dhskinner/Scoreboard/Design/Firmware/Scoreboard_Firmware/ScoreboardControllerWifi/data/mstile-150x150.png

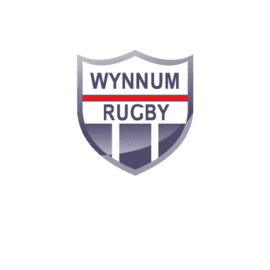
Design/Firmware/Scoreboard_Firmware/ScoreboardControllerWifi/data/mstile-150x150.png
