dhskinner/Scoreboard/Design/Solidworks Controller ULCD/sma-angled.jpg

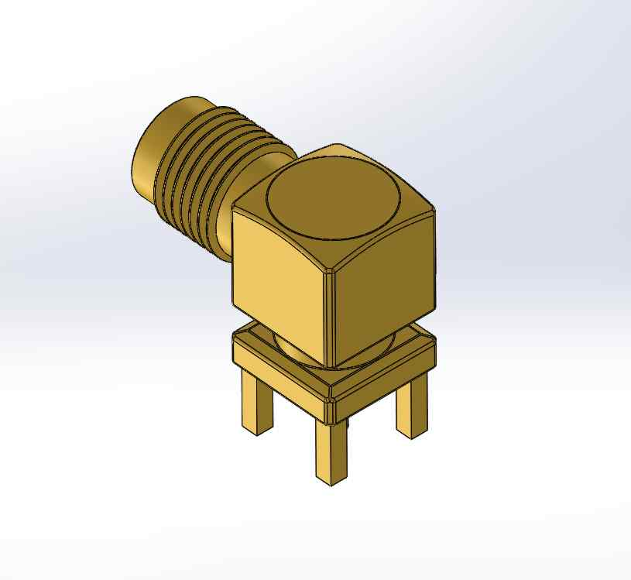
Design/Solidworks Controller ULCD/sma-angled.jpg
