dhskinner/Scoreboard/Sponsors/2023_Season/Property-Centre-stacked-blue.webp

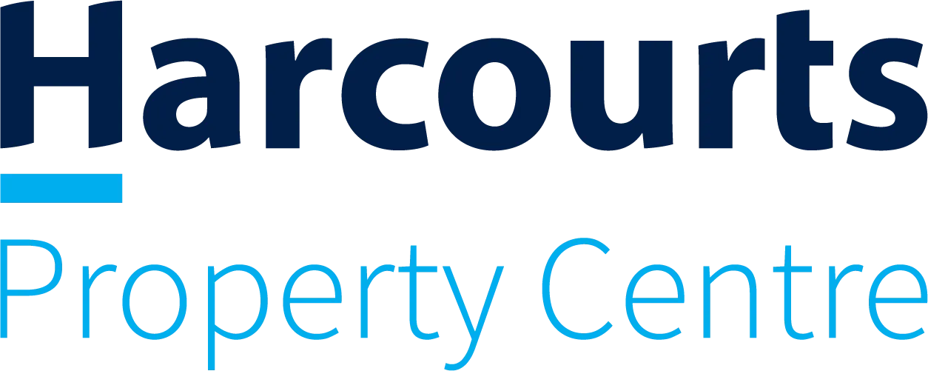
Sponsors/2023_Season/Property-Centre-stacked-blue.webp
