dhskinner/Scoreboard/Sponsors/2023_Season/The-Small-Business-Lawyer-1-1280x695.png

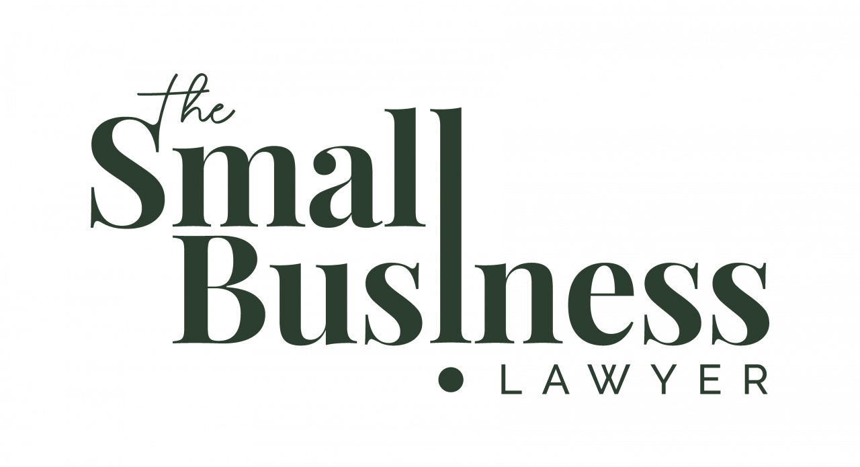
Sponsors/2023_Season/The-Small-Business-Lawyer-1-1280x695.png
