dhskinner/Scoreboard/Sponsors/2023_Season/YPM_Group_FullColour_DeepGreen-1280x766.png

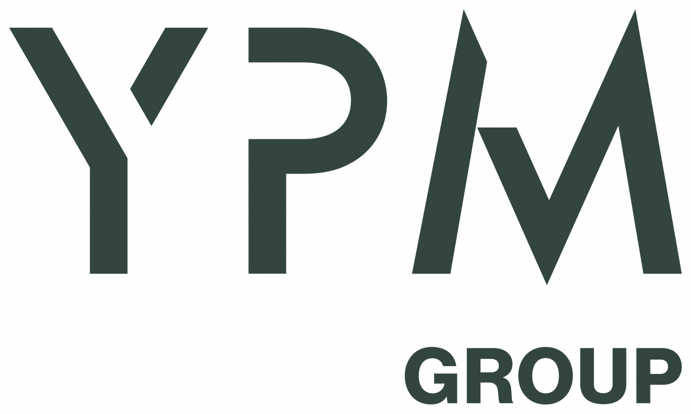
Sponsors/2023_Season/YPM_Group_FullColour_DeepGreen-1280x766.png
