dhskinner/Scoreboard/Design/ScoreBoard Arduino Code.xlsx

Sheet: Brightness
Brightness
// Scale from 0 = zero brightness to six = 255
// This is a whole bunch of magic numbers TODO
switch (_dmdBrightness)
{
 | case FLAG_BRIGHTNESS_0: |  | 0
 |  | _dmd.setBrightness ( 20 ); | 20
 |  | break;
 | case FLAG_BRIGHTNESS_1: |  | 1
 |  | _dmd.setBrightness ( 40 ); | 40
 |  | break;
 | case FLAG_BRIGHTNESS_2: |  | 2
 |  | _dmd.setBrightness ( 80 ); | 80
 |  | break;
 | case FLAG_BRIGHTNESS_3: |  | 3
 |  | _dmd.setBrightness ( 120 ); | 120
 |  | break;
 | case FLAG_BRIGHTNESS_4: |  | 4
 |  | _dmd.setBrightness ( 160 ); | 160
 |  | break;
 | case FLAG_BRIGHTNESS_5: |  | 5
 |  | _dmd.setBrightness ( 200 ); | 200
 |  | break;
 | default: |  | 6
 |  | _dmd.setBrightness ( 255 ); | 255
 |  | break;
}

Sheet: Font 48x24 New
 | 4 | 5 | 6 | 7 | 8 | 9 | 10 | 11 | 12 | 13 | 14 | 15 | 16 | 17 | 18 | 19 | 20 | 21 | 22 | 23 | 24 | 25 | 26 | 27 | 0 | // 0
0 | 0 | 0 | 0 | 0 | 0 | 0 | 0 | 0 | 1 | 1 | 1 | 1 | 1 | 1 | 1 | 1 | 0 | 0 | 0 | 0 | 0 | 0 | 0 | 0 | 0 | 0x00, | 0xC0, | 0xF0, | 0xF8, | 0xFC, | 0xFC, | 0xFE, | 0x7E, | 0x3F, | 0x3F, | 0x3F, | 0x3F, | 0x3F, | 0x3F, | 0x3F, | 0x3F, | 0x7E, | 0xFE, | 0xFC, | 0xFC, | 0xF8, | 0xF0, | 0xC0, | 0x00, | // 0 | 2
1 | 0 | 0 | 0 | 0 | 0 | 0 | 1 | 1 | 1 | 1 | 1 | 1 | 1 | 1 | 1 | 1 | 1 | 1 | 0 | 0 | 0 | 0 | 0 | 0 | 1
2 | 0 | 0 | 0 | 0 | 1 | 1 | 1 | 1 | 1 | 1 | 1 | 1 | 1 | 1 | 1 | 1 | 1 | 1 | 1 | 1 | 0 | 0 | 0 | 0 | 2
3 | 0 | 0 | 0 | 1 | 1 | 1 | 1 | 1 | 1 | 1 | 1 | 1 | 1 | 1 | 1 | 1 | 1 | 1 | 1 | 1 | 1 | 0 | 0 | 0 | 3
4 | 0 | 0 | 1 | 1 | 1 | 1 | 1 | 1 | 1 | 1 | 1 | 1 | 1 | 1 | 1 | 1 | 1 | 1 | 1 | 1 | 1 | 1 | 0 | 0 | 4
5 | 0 | 0 | 1 | 1 | 1 | 1 | 1 | 1 | 1 | 1 | 1 | 1 | 1 | 1 | 1 | 1 | 1 | 1 | 1 | 1 | 1 | 1 | 0 | 0 | 5
6 | 0 | 1 | 1 | 1 | 1 | 1 | 1 | 1 | 0 | 0 | 0 | 0 | 0 | 0 | 0 | 0 | 1 | 1 | 1 | 1 | 1 | 1 | 1 | 0 | 6
7 | 0 | 1 | 1 | 1 | 1 | 1 | 1 | 0 | 0 | 0 | 0 | 0 | 0 | 0 | 0 | 0 | 0 | 1 | 1 | 1 | 1 | 1 | 1 | 0 | 7
8 | 1 | 1 | 1 | 1 | 1 | 1 | 0 | 0 | 0 | 0 | 0 | 0 | 0 | 0 | 0 | 0 | 0 | 0 | 1 | 1 | 1 | 1 | 1 | 1 | 8 | 0xFF, | 0xFF, | 0xFF, | 0xFF, | 0xFF, | 0xFF, | 0x00, | 0x00, | 0x00, | 0x00, | 0x00, | 0x00, | 0x00, | 0x00, | 0x00, | 0x00, | 0x00, | 0x00, | 0xFF, | 0xFF, | 0xFF, | 0xFF, | 0xFF, | 0xFF, | // 0 | 10
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
47 | 0 | 0 | 0 | 0 | 0 | 0 | 0 | 0 | 0 | 0 | 0 | 0 | 0 | 0 | 0 | 0 | 0 | 0 | 0 | 0 | 0 | 0 | 0 | 0 | 47
 | 4 | 5 | 6 | 7 | 8 | 9 | 10 | 11 | 12 | 13 | 14 | 15 | 16 | 17 | 18 | 19 | 20 | 21 | 22 | 23 | 24 | 25 | 26 | 27 | 10

Sheet: Font 44x28 New
 | 0 | 1 | 2 | 3 | 4 | 5 | 6 | 7 | 8 | 9 | 10 | 11 | 12 | 13 | 14 | 15 | 16 | 17 | 18 | 19 | 20 | 21 | 22 | 23 | 24 | 25 | 26 | 27 | 0 | 0 | 1 | 2 | 3 | 4 | 5 | 6 | 7 | 8 | 9 | 10 | 11 | 12 | 13 | 14 | 15 | 16 | 17 | 18 | 19 | 20 | 21 | 22 | 23 | 24 | 25 | 26 | 27
0 | 0 | 0 | 0 | 0 | 0 | 0 | 0 | 0 | 1 | 1 | 1 | 1 | 1 | 1 | 1 | 1 | 1 | 1 | 1 | 1 | 0 | 0 | 0 | 0 | 0 | 0 | 0 | 0 | 0 | 0x00, | 0xC0, | 0xF0, | 0xF8, | 0xFC, | 0xFC, | 0xFE, | 0x7E, | 0x3F, | 0x3F, | 0x3F, | 0x3F, | 0x3F, | 0x3F, | 0x3F, | 0x3F, | 0x3F, | 0x3F, | 0x3F, | 0x3F, | 0x7E, | 0xFE, | 0xFC, | 0xFC, | 0xF8, | 0xF0, | 0xC0, | 0x00, | // 0
1 | 0 | 0 | 0 | 0 | 0 | 0 | 1 | 1 | 1 | 1 | 1 | 1 | 1 | 1 | 1 | 1 | 1 | 1 | 1 | 1 | 1 | 1 | 0 | 0 | 0 | 0 | 0 | 0 | 1
2 | 0 | 0 | 0 | 0 | 1 | 1 | 1 | 1 | 1 | 1 | 1 | 1 | 1 | 1 | 1 | 1 | 1 | 1 | 1 | 1 | 1 | 1 | 1 | 1 | 0 | 0 | 0 | 0 | 2
3 | 0 | 0 | 0 | 1 | 1 | 1 | 1 | 1 | 1 | 1 | 1 | 1 | 1 | 1 | 1 | 1 | 1 | 1 | 1 | 1 | 1 | 1 | 1 | 1 | 1 | 0 | 0 | 0 | 3
4 | 0 | 0 | 1 | 1 | 1 | 1 | 1 | 1 | 1 | 1 | 1 | 1 | 1 | 1 | 1 | 1 | 1 | 1 | 1 | 1 | 1 | 1 | 1 | 1 | 1 | 1 | 0 | 0 | 4
5 | 0 | 0 | 1 | 1 | 1 | 1 | 1 | 1 | 1 | 1 | 1 | 1 | 1 | 1 | 1 | 1 | 1 | 1 | 1 | 1 | 1 | 1 | 1 | 1 | 1 | 1 | 0 | 0 | 5
6 | 0 | 1 | 1 | 1 | 1 | 1 | 1 | 1 | 0 | 0 | 0 | 0 | 0 | 0 | 0 | 0 | 0 | 0 | 0 | 0 | 1 | 1 | 1 | 1 | 1 | 1 | 1 | 0 | 6
7 | 0 | 1 | 1 | 1 | 1 | 1 | 1 | 0 | 0 | 0 | 0 | 0 | 0 | 0 | 0 | 0 | 0 | 0 | 0 | 0 | 0 | 1 | 1 | 1 | 1 | 1 | 1 | 0 | 7
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
4 | 1 | 1 | 1 | 1 | 1 | 1 | 1 | 1 | 1 | 1 | 1 | 1 | 1 | 1 | 1 | 1 | 1 | 1 | 1 | 1 | 1 | 1 | 1 | 1 | 1 | 1 | 0 | 0 | 2
5 | 1 | 1 | 1 | 1 | 1 | 1 | 1 | 1 | 1 | 1 | 1 | 1 | 1 | 1 | 1 | 1 | 1 | 1 | 1 | 1 | 1 | 1 | 1 | 1 | 1 | 1 | 0 | 0 | 3

Sheet: Spacing
320 x 480
3 x BUTTONS

Sheet: Defines III
 |  |  | TYPE | ID | INDEX | NAME | DEFINE OBJECT PLUS INDEX | INPUT NUMBERS | BUTTON_NAMES
 |  |  |  |  |  | // FORMS | // FORMS
 |  |  | FORM | 10 | 0 | MAIN_FORM | #define ULCD_MAIN_FORM 10,0
 |  |  | FORM | 10 | 1 | FIELD1_SCORE0_FORM | #define ULCD_FIELD1_SCORE0_FORM 10,1
 |  |  | FORM | 10 | 2 | FIELD1_TIMER_FORM | #define ULCD_FIELD1_TIMER_FORM 10,2
 |  |  | FORM | 10 | 3 | FIELD2_SCORE0_FORM | #define ULCD_FIELD2_SCORE0_FORM 10,3
 |  |  | FORM | 10 | 4 | SPLASH_FORM | #define ULCD_SPLASH_FORM 10,4
 |  |  | FORM | 10 | 5 | FIELD1_FORM | #define ULCD_FIELD1_FORM 10,5
 |  |  | FORM | 10 | 6 | FIELD2_FORM | #define ULCD_FIELD2_FORM 10,6
 |  |  | FORM | 10 | 7 | MESSAGE_FORM | #define ULCD_MESSAGE_FORM 10,7
 |  |  | FORM | 10 | 8 | DIALOG_FORM | #define ULCD_DIALOG_FORM 10,8
 |  |  | FORM | 10 | 9 | TEXT_SET_FORM | #define ULCD_TEXT_SET_FORM 10,9
 |  |  | FORM | 10 | 10 | FIELD2_TIMER_FORM | #define ULCD_FIELD2_TIMER_FORM 10,10
 |  |  | FORM | 10 | 11 | TEXT_FORM | #define ULCD_TEXT_FORM 10,11
 |  |  | FORM | 10 | 12 | WORKING_FORM | #define ULCD_WORKING_FORM 10,12
4DBUTTON | GENIE_OBJ_4DBUTTON | 30 | FORM | 10 | 13 | FIELD1_SCORE1_FORM | #define ULCD_FIELD1_SCORE1_FORM 10,13
ANGULAR_METER | GENIE_OBJ_ANGULAR_METER | 7 | FORM | 10 | 14 | FIELD2_SCORE1_FORM | #define ULCD_FIELD2_SCORE1_FORM 10,14
ANIBUTTON | GENIE_OBJ_ANIBUTTON | 31 | FORM | 10 | 15 | BLANK_FORM | #define ULCD_BLANK_FORM 10,15
COLORPICKER | GENIE_OBJ_COLORPICKER | 32 |  |  |  | // MAIN FORM | // MAIN FORM
COOL_GAUGE | GENIE_OBJ_COOL_GAUGE | 8 | 4DBUTTON | 30 | 0 | MAIN_DUALSCREEN_4DBTN | #define ULCD_MAIN_DUALSCREEN_4DBTN 30,0 | #define INPUT_MAIN_DUALSCREEN_4DBTN 0 | case INPUT_MAIN_DUALSCREEN_4DBTN: break;
CUSTOM_DIGITS | GENIE_OBJ_CUSTOM_DIGITS | 9 | 4DBUTTON | 30 | 1 | MAIN_SWAPFIELD_4DBTN | #define ULCD_MAIN_SWAPFIELD_4DBTN 30,1 | #define INPUT_MAIN_SWAPFIELD_4DBTN 1 | case INPUT_MAIN_SWAPFIELD_4DBTN: break;
DIPSW | GENIE_OBJ_DIPSW | 0 | TRACKBAR | 5 | 0 | MAIN_BRIGHTNESS_BAR | #define ULCD_MAIN_BRIGHTNESS_BAR 5,0 | #define INPUT_MAIN_BRIGHTNESS_BAR 0 | case INPUT_MAIN_BRIGHTNESS_BAR: break;
FORM | GENIE_OBJ_FORM | 10 | USERBUTTON | 33 | 3 | MAIN_FIELD1_BTN | #define ULCD_MAIN_FIELD1_BTN 33,3 | #define INPUT_MAIN_FIELD1_BTN 3 | case INPUT_MAIN_FIELD1_BTN: break;
GAUGE | GENIE_OBJ_GAUGE | 11 | USERBUTTON | 33 | 5 | MAIN_FIELD2_BTN | #define ULCD_MAIN_FIELD2_BTN 33,5 | #define INPUT_MAIN_FIELD2_BTN 5 | case INPUT_MAIN_FIELD2_BTN: break;
IMAGE | GENIE_OBJ_IMAGE | 12 | USERBUTTON | 33 | 4 | MAIN_TEXT_BTN | #define ULCD_MAIN_TEXT_BTN 33,4 | #define INPUT_MAIN_TEXT_BTN 4 | case INPUT_MAIN_TEXT_BTN: break;
KEYBOARD | GENIE_OBJ_KEYBOARD | 13 | GAUGE | 11 | 4 | MAIN_BATTERY | #define ULCD_MAIN_BATTERY 11,4
KNOB | GENIE_OBJ_KNOB | 1 | USERIMAGES | 27 | 0 | MAIN_SIGNAL | #define ULCD_MAIN_SIGNAL 27,0
LED | GENIE_OBJ_LED | 14 | TIMER | 23 | 0 | MAIN_TIMER | #define ULCD_MAIN_TIMER 23,0
LED_DIGITS | GENIE_OBJ_LED_DIGITS | 15 | STRINGS | 17 | 15 | MAIN_ONLINE_STRING | #define ULCD_MAIN_ONLINE_STRING 17,15
METER | GENIE_OBJ_METER | 16 |  |  |  | // FIELD1 - SCORE0 | // FIELD1 - SCORE0
PININPUT | GENIE_OBJ_PININPUT | 29 | LED_DIGITS | 15 | 3 | FIELD1_SCORE0_SET_LED | #define ULCD_FIELD1_SCORE0_SET_LED 15,3
PINOUTPUT | GENIE_OBJ_PINOUTPUT | 28 | USERBUTTON | 33 | 22 | FIELD1_SCORE0_MINUS1_BTN | #define ULCD_FIELD1_SCORE0_MINUS1_BTN 33,22 | #define INPUT_FIELD1_SCORE0_MINUS1_BTN 22 | case INPUT_FIELD1_SCORE0_MINUS1_BTN: break;
ROCKERSW | GENIE_OBJ_ROCKERSW | 2 | USERBUTTON | 33 | 21 | FIELD1_SCORE0_MINUS5_BTN | #define ULCD_FIELD1_SCORE0_MINUS5_BTN 33,21 | #define INPUT_FIELD1_SCORE0_MINUS5_BTN 21 | case INPUT_FIELD1_SCORE0_MINUS5_BTN: break;
ROTARYSW | GENIE_OBJ_ROTARYSW | 3 | USERBUTTON | 33 | 24 | FIELD1_SCORE0_PLUS5_BTN | #define ULCD_FIELD1_SCORE0_PLUS5_BTN 33,24 | #define INPUT_FIELD1_SCORE0_PLUS5_BTN 24 | case INPUT_FIELD1_SCORE0_PLUS5_BTN: break;
SCOPE | GENIE_OBJ_SCOPE | 25 | USERBUTTON | 33 | 25 | FIELD1_SCORE0_PLUS1_BTN | #define ULCD_FIELD1_SCORE0_PLUS1_BTN 33,25 | #define INPUT_FIELD1_SCORE0_PLUS1_BTN 25 | case INPUT_FIELD1_SCORE0_PLUS1_BTN: break;
SLIDER | GENIE_OBJ_SLIDER | 4 | USERBUTTON | 33 | 23 | FIELD1_SCORE0_BACK_BTN | #define ULCD_FIELD1_SCORE0_BACK_BTN 33,23 | #define INPUT_FIELD1_SCORE0_BACK_BTN 23 | case INPUT_FIELD1_SCORE0_BACK_BTN: break;
SOUND | GENIE_OBJ_SOUND | 22 | USERBUTTON | 33 | 26 | FIELD1_SCORE0_SET_BTN | #define ULCD_FIELD1_SCORE0_SET_BTN 33,26 | #define INPUT_FIELD1_SCORE0_SET_BTN 26 | case INPUT_FIELD1_SCORE0_SET_BTN: break;
SPECTRUM | GENIE_OBJ_SPECTRUM | 24 |  |  |  | // FIELD1 - SCORE1 | // FIELD1 - SCORE1
STATIC_TEXT | GENIE_OBJ_STATIC_TEXT | 21 | LED_DIGITS | 15 | 0 | FIELD1_SCORE1_SET_LED | #define ULCD_FIELD1_SCORE1_SET_LED 15,0
STRINGS | GENIE_OBJ_STRINGS | 17 | USERBUTTON | 33 | 13 | FIELD1_SCORE1_MINUS1_BTN | #define ULCD_FIELD1_SCORE1_MINUS1_BTN 33,13 | #define INPUT_FIELD1_SCORE1_MINUS1_BTN 13 | case INPUT_FIELD1_SCORE1_MINUS1_BTN: break;
TANK | GENIE_OBJ_TANK | 26 | USERBUTTON | 33 | 14 | FIELD1_SCORE1_MINUS5_BTN | #define ULCD_FIELD1_SCORE1_MINUS5_BTN 33,14 | #define INPUT_FIELD1_SCORE1_MINUS5_BTN 14 | case INPUT_FIELD1_SCORE1_MINUS5_BTN: break;
THERMOMETER | GENIE_OBJ_THERMOMETER | 18 | USERBUTTON | 33 | 34 | FIELD1_SCORE1_PLUS5_BTN | #define ULCD_FIELD1_SCORE1_PLUS5_BTN 33,34 | #define INPUT_FIELD1_SCORE1_PLUS5_BTN 34 | case INPUT_FIELD1_SCORE1_PLUS5_BTN: break;
TIMER | GENIE_OBJ_TIMER | 23 | USERBUTTON | 33 | 35 | FIELD1_SCORE1_PLUS1_BTN | #define ULCD_FIELD1_SCORE1_PLUS1_BTN 33,35 | #define INPUT_FIELD1_SCORE1_PLUS1_BTN 35 | case INPUT_FIELD1_SCORE1_PLUS1_BTN: break;
TRACKBAR | GENIE_OBJ_TRACKBAR | 5 | USERBUTTON | 33 | 12 | FIELD1_SCORE1_BACK_BTN | #define ULCD_FIELD1_SCORE1_BACK_BTN 33,12 | #define INPUT_FIELD1_SCORE1_BACK_BTN 12 | case INPUT_FIELD1_SCORE1_BACK_BTN: break;
USER_LED | GENIE_OBJ_USER_LED | 19 | USERBUTTON | 33 | 11 | FIELD1_SCORE1_SET_BTN | #define ULCD_FIELD1_SCORE1_SET_BTN 33,11 | #define INPUT_FIELD1_SCORE1_SET_BTN 11 | case INPUT_FIELD1_SCORE1_SET_BTN: break;
USERBUTTON | GENIE_OBJ_USERBUTTON | 33 |  |  |  | // FIELD2 - SCORE0 | // FIELD2 - SCORE0
USERIMAGES | GENIE_OBJ_USERIMAGES | 27 | LED_DIGITS | 15 | 6 | FIELD2_SCORE0_SET_LED | #define ULCD_FIELD2_SCORE0_SET_LED 15,6
VIDEO | GENIE_OBJ_VIDEO | 20 | USERBUTTON | 33 | 16 | FIELD2_SCORE0_MINUS1_BTN | #define ULCD_FIELD2_SCORE0_MINUS1_BTN 33,16 | #define INPUT_FIELD2_SCORE0_MINUS1_BTN 16 | case INPUT_FIELD2_SCORE0_MINUS1_BTN: break;
WINBUTTON | GENIE_OBJ_WINBUTTON | 6 | USERBUTTON | 33 | 15 | FIELD2_SCORE0_MINUS5_BTN | #define ULCD_FIELD2_SCORE0_MINUS5_BTN 33,15 | #define INPUT_FIELD2_SCORE0_MINUS5_BTN 15 | case INPUT_FIELD2_SCORE0_MINUS5_BTN: break;
 |  |  | USERBUTTON | 33 | 18 | FIELD2_SCORE0_PLUS5_BTN | #define ULCD_FIELD2_SCORE0_PLUS5_BTN 33,18 | #define INPUT_FIELD2_SCORE0_PLUS5_BTN 18 | case INPUT_FIELD2_SCORE0_PLUS5_BTN: break;
 |  |  | USERBUTTON | 33 | 19 | FIELD2_SCORE0_PLUS1_BTN | #define ULCD_FIELD2_SCORE0_PLUS1_BTN 33,19 | #define INPUT_FIELD2_SCORE0_PLUS1_BTN 19 | case INPUT_FIELD2_SCORE0_PLUS1_BTN: break;
 |  |  | USERBUTTON | 33 | 17 | FIELD2_SCORE0_BACK_BTN | #define ULCD_FIELD2_SCORE0_BACK_BTN 33,17 | #define INPUT_FIELD2_SCORE0_BACK_BTN 17 | case INPUT_FIELD2_SCORE0_BACK_BTN: break;
 |  |  | USERBUTTON | 33 | 20 | FIELD2_SCORE0_SET_BTN | #define ULCD_FIELD2_SCORE0_SET_BTN 33,20 | #define INPUT_FIELD2_SCORE0_SET_BTN 20 | case INPUT_FIELD2_SCORE0_SET_BTN: break;
 |  |  |  |  |  | // FIELD2 - SCORE1 | // FIELD2 - SCORE1
 |  |  | LED_DIGITS | 15 | 1 | FIELD2_SCORE1_SET_LED | #define ULCD_FIELD2_SCORE1_SET_LED 15,1
 |  |  | USERBUTTON | 33 | 37 | FIELD2_SCORE1_MINUS1_BTN | #define ULCD_FIELD2_SCORE1_MINUS1_BTN 33,37 | #define INPUT_FIELD2_SCORE1_MINUS1_BTN 37 | case INPUT_FIELD2_SCORE1_MINUS1_BTN: break;
 |  |  | USERBUTTON | 33 | 36 | FIELD2_SCORE1_MINUS5_BTN | #define ULCD_FIELD2_SCORE1_MINUS5_BTN 33,36 | #define INPUT_FIELD2_SCORE1_MINUS5_BTN 36 | case INPUT_FIELD2_SCORE1_MINUS5_BTN: break;
 |  |  | USERBUTTON | 33 | 40 | FIELD2_SCORE1_PLUS5_BTN | #define ULCD_FIELD2_SCORE1_PLUS5_BTN 33,40 | #define INPUT_FIELD2_SCORE1_PLUS5_BTN 40 | case INPUT_FIELD2_SCORE1_PLUS5_BTN: break;
 |  |  | USERBUTTON | 33 | 39 | FIELD2_SCORE1_PLUS1_BTN | #define ULCD_FIELD2_SCORE1_PLUS1_BTN 33,39 | #define INPUT_FIELD2_SCORE1_PLUS1_BTN 39 | case INPUT_FIELD2_SCORE1_PLUS1_BTN: break;
 |  |  | USERBUTTON | 33 | 38 | FIELD2_SCORE1_BACK_BTN | #define ULCD_FIELD2_SCORE1_BACK_BTN 33,38 | #define INPUT_FIELD2_SCORE1_BACK_BTN 38 | case INPUT_FIELD2_SCORE1_BACK_BTN: break;
 |  |  | USERBUTTON | 33 | 41 | FIELD2_SCORE1_SET_BTN | #define ULCD_FIELD2_SCORE1_SET_BTN 33,41 | #define INPUT_FIELD2_SCORE1_SET_BTN 41 | case INPUT_FIELD2_SCORE1_SET_BTN: break;
 |  |  |  |  |  | // FIELD1 - TIMER | // FIELD1 - TIMER
 |  |  | LED_DIGITS | 15 | 4 | FIELD1_TIMER_SET_LED | #define ULCD_FIELD1_TIMER_SET_LED 15,4
 |  |  | STRINGS | 17 | 2 | FIELD1_TIMER_SET_STRING | #define ULCD_FIELD1_TIMER_SET_STRING 17,2
 |  |  | USERBUTTON | 33 | 1 | FIELD1_TIMER_STOP_BTN | #define ULCD_FIELD1_TIMER_STOP_BTN 33,1 | #define INPUT_FIELD1_TIMER_STOP_BTN 1 | case INPUT_FIELD1_TIMER_STOP_BTN: break;
 |  |  | USERBUTTON | 33 | 0 | FIELD1_TIMER_PAUSE_BTN | #define ULCD_FIELD1_TIMER_PAUSE_BTN 33,0 | #define INPUT_FIELD1_TIMER_PAUSE_BTN 0 | case INPUT_FIELD1_TIMER_PAUSE_BTN: break;
 |  |  | USERBUTTON | 33 | 2 | FIELD1_TIMER_START_BTN | #define ULCD_FIELD1_TIMER_START_BTN 33,2 | #define INPUT_FIELD1_TIMER_START_BTN 2 | case INPUT_FIELD1_TIMER_START_BTN: break;
 |  |  | USERBUTTON | 33 | 6 | FIELD1_TIMER_BACK_BTN | #define ULCD_FIELD1_TIMER_BACK_BTN 33,6 | #define INPUT_FIELD1_TIMER_BACK_BTN 6 | case INPUT_FIELD1_TIMER_BACK_BTN: break;
 |  |  | USERBUTTON | 33 | 10 | FIELD1_TIMER_CLOCK_BTN | #define ULCD_FIELD1_TIMER_CLOCK_BTN 33,10 | #define INPUT_FIELD1_TIMER_CLOCK_BTN 10 | case INPUT_FIELD1_TIMER_CLOCK_BTN: break;
 |  |  |  |  |  | // FIELD2 - TIMER | // FIELD2 - TIMER
 |  |  | LED_DIGITS | 15 | 11 | FIELD2_TIMER_SET_LED | #define ULCD_FIELD2_TIMER_SET_LED 15,11
 |  |  | STRINGS | 17 | 13 | FIELD2_TIMER_SET_STRING | #define ULCD_FIELD2_TIMER_SET_STRING 17,13
 |  |  | USERBUTTON | 33 | 47 | FIELD2_TIMER_STOP_BTN | #define ULCD_FIELD2_TIMER_STOP_BTN 33,47 | #define INPUT_FIELD2_TIMER_STOP_BTN 47 | case INPUT_FIELD2_TIMER_STOP_BTN: break;
 |  |  | USERBUTTON | 33 | 48 | FIELD2_TIMER_PAUSE_BTN | #define ULCD_FIELD2_TIMER_PAUSE_BTN 33,48 | #define INPUT_FIELD2_TIMER_PAUSE_BTN 48 | case INPUT_FIELD2_TIMER_PAUSE_BTN: break;
 |  |  | USERBUTTON | 33 | 49 | FIELD2_TIMER_START_BTN | #define ULCD_FIELD2_TIMER_START_BTN 33,49 | #define INPUT_FIELD2_TIMER_START_BTN 49 | case INPUT_FIELD2_TIMER_START_BTN: break;
 |  |  | USERBUTTON | 33 | 51 | FIELD2_TIMER_BACK_BTN | #define ULCD_FIELD2_TIMER_BACK_BTN 33,51 | #define INPUT_FIELD2_TIMER_BACK_BTN 51 | case INPUT_FIELD2_TIMER_BACK_BTN: break;
 |  |  | USERBUTTON | 33 | 50 | FIELD2_TIMER_CLOCK_BTN | #define ULCD_FIELD2_TIMER_CLOCK_BTN 33,50 | #define INPUT_FIELD2_TIMER_CLOCK_BTN 50 | case INPUT_FIELD2_TIMER_CLOCK_BTN: break;
 |  |  |  |  |  | // WORKING | // WORKING
 |  |  | USERIMAGES | 27 | 0 | WORKING_IMAGE | #define ULCD_WORKING_IMAGE 27,0
 |  |  |  |  |  | // SPLASH | // SPLASH
 |  |  | USERBUTTON | 33 | 7 | SPLASH_SKIP_BTN | #define ULCD_SPLASH_SKIP_BTN 33,7 | #define INPUT_SPLASH_SKIP_BTN 7 | case INPUT_SPLASH_SKIP_BTN: break;
 |  |  | USERBUTTON | 33 | 8 | SPLASH_OFFLINE_BTN | #define ULCD_SPLASH_OFFLINE_BTN 33,8 | #define INPUT_SPLASH_OFFLINE_BTN 8 | case INPUT_SPLASH_OFFLINE_BTN: break;
 |  |  |  |  |  | //FIELD1 | //FIELD1
 |  |  | LED_DIGITS | 15 | 5 | FIELD1_SCORE0_LED | #define ULCD_FIELD1_SCORE0_LED 15,5
 |  |  | LED_DIGITS | 15 | 8 | FIELD1_SCORE1_LED | #define ULCD_FIELD1_SCORE1_LED 15,8
 |  |  | LED_DIGITS | 15 | 7 | FIELD1_TIMER_LED | #define ULCD_FIELD1_TIMER_LED 15,7
 |  |  | STRINGS | 17 | 5 | FIELD1_TIMER_STRING | #define ULCD_FIELD1_TIMER_STRING 17,5
 |  |  | USERBUTTON | 33 | 31 | FIELD1_SCORE0_BTN | #define ULCD_FIELD1_SCORE0_BTN 33,31 | #define INPUT_FIELD1_SCORE0_BTN 31 | case INPUT_FIELD1_SCORE0_BTN: break;
 |  |  | USERBUTTON | 33 | 29 | FIELD1_SCORE1_BTN | #define ULCD_FIELD1_SCORE1_BTN 33,29 | #define INPUT_FIELD1_SCORE1_BTN 29 | case INPUT_FIELD1_SCORE1_BTN: break;
 |  |  | USERBUTTON | 33 | 30 | FIELD1_TIMER_BTN | #define ULCD_FIELD1_TIMER_BTN 33,30 | #define INPUT_FIELD1_TIMER_BTN 30 | case INPUT_FIELD1_TIMER_BTN: break;
 |  |  | USERBUTTON | 33 | 32 | FIELD1_BACK_BTN | #define ULCD_FIELD1_BACK_BTN 33,32 | #define INPUT_FIELD1_BACK_BTN 32 | case INPUT_FIELD1_BACK_BTN: break;
 |  |  | USERBUTTON | 33 | 33 | FIELD1_CLEAR_BTN | #define ULCD_FIELD1_CLEAR_BTN 33,33 | #define INPUT_FIELD1_CLEAR_BTN 33 | case INPUT_FIELD1_CLEAR_BTN: break;
 |  |  | GAUGE | 11 | 0 | FIELD1_BATTERY | #define ULCD_FIELD1_BATTERY 11,0
 |  |  | USERIMAGES | 27 | 2 | FIELD1_SIGNAL | #define ULCD_FIELD1_SIGNAL 27,2
 |  |  |  |  |  | //FIELD2 | //FIELD2
 |  |  | LED_DIGITS | 15 | 2 | FIELD2_SCORE0_LED | #define ULCD_FIELD2_SCORE0_LED 15,2
 |  |  | LED_DIGITS | 15 | 10 | FIELD2_SCORE1_LED | #define ULCD_FIELD2_SCORE1_LED 15,10
 |  |  | LED_DIGITS | 15 | 9 | FIELD2_TIMER_LED | #define ULCD_FIELD2_TIMER_LED 15,9
 |  |  | STRINGS | 17 | 7 | FIELD2_TIMER_STRING | #define ULCD_FIELD2_TIMER_STRING 17,7
 |  |  | USERBUTTON | 33 | 42 | FIELD2_SCORE0_BTN | #define ULCD_FIELD2_SCORE0_BTN 33,42 | #define INPUT_FIELD2_SCORE0_BTN 42 | case INPUT_FIELD2_SCORE0_BTN: break;
 |  |  | USERBUTTON | 33 | 46 | FIELD2_SCORE1_BTN | #define ULCD_FIELD2_SCORE1_BTN 33,46 | #define INPUT_FIELD2_SCORE1_BTN 46 | case INPUT_FIELD2_SCORE1_BTN: break;
 |  |  | USERBUTTON | 33 | 43 | FIELD2_TIMER_BTN | #define ULCD_FIELD2_TIMER_BTN 33,43 | #define INPUT_FIELD2_TIMER_BTN 43 | case INPUT_FIELD2_TIMER_BTN: break;
 |  |  | USERBUTTON | 33 | 45 | FIELD2_BACK_BTN | #define ULCD_FIELD2_BACK_BTN 33,45 | #define INPUT_FIELD2_BACK_BTN 45 | case INPUT_FIELD2_BACK_BTN: break;
 |  |  | USERBUTTON | 33 | 44 | FIELD2_CLEAR_BTN | #define ULCD_FIELD2_CLEAR_BTN 33,44 | #define INPUT_FIELD2_CLEAR_BTN 44 | case INPUT_FIELD2_CLEAR_BTN: break;
 |  |  | GAUGE | 11 | 1 | FIELD2_BATTERY | #define ULCD_FIELD2_BATTERY 11,1
 |  |  | USERIMAGES | 27 | 3 | FIELD2_SIGNAL | #define ULCD_FIELD2_SIGNAL 27,3
 |  |  |  |  |  | // MESSAGE | // MESSAGE
 |  |  | STRINGS | 17 | 3 | MESSAGE_STRING | #define ULCD_MESSAGE_STRING 17,3
 |  |  | USERBUTTON | 33 | 27 | MESSAGE_OK_BTN | #define ULCD_MESSAGE_OK_BTN 33,27 | #define INPUT_MESSAGE_OK_BTN 27 | case INPUT_MESSAGE_OK_BTN: break;
 |  |  |  |  |  | // DIALOG | // DIALOG
 |  |  | STRINGS | 17 | 4 | DIALOG_STRING | #define ULCD_DIALOG_STRING 17,4
 |  |  | USERBUTTON | 33 | 28 | DIALOG_YES_BTN | #define ULCD_DIALOG_YES_BTN 33,28 | #define INPUT_DIALOG_YES_BTN 28 | case INPUT_DIALOG_YES_BTN: break;
 |  |  | USERBUTTON | 33 | 9 | DIALOG_NO_BTN | #define ULCD_DIALOG_NO_BTN 33,9 | #define INPUT_DIALOG_NO_BTN 9 | case INPUT_DIALOG_NO_BTN: break;

Sheet: BOM
BILL OF MATERIALS |  |  |  |  |  | BILL OF MATERIALS
Name: | Scoreboard - Electronics |  |  |  |  | Name: | Scoreboard - Electronics
Date: | 2015-07-15 |  |  |  |  | Date: | 2015-07-15
Item | Description | Quantity | Cost/Unit | Total | Comments | Item | Description | Quantity | Cost/Unit | Total | Comments
0 |  |  |  |  |  | 0
1 | SCOREBOARD |  |  |  |  | 1 | SCOREBOARD
2 | DMD LED Panels | 20 | $30 | $929.961 | USD 688.86 | 2 | DMD LED Panels - Blue | 40 | $21.65 | $865.92 | USD 688.86 | 0.7232
3 | ATMEGA328 MCU (Slave) | 4 | $5 | $20 |  | 3 | DMD LED Panels - White | 4 | $0.00 | $0.00
4 | ATMEGA2560 MCU (Master) | 1 | $20 | $20 |  | 4 | ATMEGA328 MCU (Slave) | 3 | $3.34 | $10.02
5 | 5V 30A 150W Switching Power Supply | 3 | $30 | $90 |  | 5 | ATMEGA328 MCU (Master) | 1 | $3.34 | $3.34
6 | DS3231 Realtime Clock | 1 | $5 | $5 |  | 6 | 5V 40A 150W Switching Power Supply | 4 | $25.69 | $102.76
7 | 16A Power Cabling | 20 | $5 | $100 |  | 7 | DS3231 Realtime Clock | 1 | $1.50 | $1.50
8 | Data cabling and hookup | 18 | $3 | $54 |  | 8 | 16A Power Cabling | 20 | $5.00 | $100.00
9 | NRF24L01 inc LNA and PA | 1 | $5 | $5 |  | 9 | Data cabling and hookup | 18 | $3.00 | $54.00
10 | Backboards | 3 | $10 | $30 |  | 10 | NRF24L01 inc LNA and PA | 1 | $5.00 | $5.00
11 | PCB | 1 | $40 | $40 |  | 11 | Backboards | 3 | $10.00 | $30.00
12 | Cooling Fan | 2 | $5 | $10 |  | 12 | PCB | 1 | $56.69 | $56.69
13 | Fasteners, Standoffs, Hardware, Cables | 1 | $50 | $50 |  | 13 | Clipsal PowerInlet | 1 | $36.00 | $36.00
14 |  |  |  | $1353.961 |  | 14 | Cooling Fan | 2 | $5.00 | $10.00
15 | CONTROLLER (EACH) |  |  |  |  | 15 | Fasteners, Standoffs, Hardware, Cables | 1 | $50.00 | $50.00
16 | Duratech Enclosure | 1 | $25 | $25 |  | 16 |  |  |  | $1325.236653
17 | uLCD35 Display | 1 | $95 | $95 |  | 17 | CONTROLLER (EACH)
18 | NRF24L01 inc LNA and PA | 1 | $5 | $5 |  | 18 | Duratech Enclosure | 1 | $25.00 | $25.00
19 | 3.3V Regulator | 1 | $2 | $2 |  | 19 | uLCD35 Display | 1 | $95.00 | $95.00
20 | Switch | 1 | $2 | $2 |  | 20 | NRF24L01 inc LNA and PA | 1 | $5.00 | $5.00
21 | LIPO Battery | 1 | $10 | $10 |  | 21 | 3.3V Regulator | 1 | $2.00 | $2.00
22 | MAX17043 LiPo Fuel Gauge | 1 | $10 | $10 |  | 22 | Switch | 1 | $2.00 | $2.00
23 | TP4056 LiPo charger | 1 | $10 | $10 |  | 23 | LIPO Battery | 1 | $10.00 | $10.00
24 | PCB | 1 | $40 | $40 |  | 24 | MAX17043 LiPo Fuel Gauge | 1 | $10.00 | $10.00
25 | Acrylic , fasteners, standoffs, hardware | 1 | $10 | $10 |  | 25 | TP4056 LiPo charger | 1 | $10.00 | $10.00
26 |  |  |  | $209 |  | 26 | PCB | 1 | $40.00 | $40.00
27 |  |  |  |  |  | 27 | Acrylic , fasteners, standoffs, hardware | 1 | $10.00 | $10.00
28 |  |  |  |  |  | 28 |  |  |  | $209
29 |  |  |  |  |  | 29
30 |  |  |  | $1562.961 |  | 30 |  |  |  | $1534.236653
 |  |  |  |  |  |  | todo
 |  |  |  |  |  |  | sort out an enclosure
 |  |  |  |  |  |  | fix the frame / wrap it up into two demo units
 |  |  |  |  |  |  | make longer wires for i2c
 |  |  |  |  |  |  | sort out a longer antenna
 |  |  |  |  |  |  | sort out the control box
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
