dhskinner/Scoreboard/Sponsors/2024_Season/SponsorList.xlsx

No | Name | 2024 | Logo? | Programmed | Note
0 | Wynnum Bugs Logo |  | Yes | OK |  | Yes | 38
1 | Harcourts Property Centre | Premier | Yes | OK |  | No | 0
2 | Ampol | Foundation | Yes | OK |  | This year | 38
3 | ElectroFire Technologies | Gold | Yes | OK |  | All time | 111
4 | Moody Civil and Pipe | Gold | Yes | OK |  | Test | 0
5 | Waterloo Bay Hotel | Gold | Yes | OK |  | OK | 37
6 | YPM Group | Gold | Yes | OK |  | To do | 1
7 | Aussie Wynnum | Silver | Yes | OK
8 | Bendigo Bank | Silver | Yes | OK
9 | CNW Electrical Wholesale | Silver | Yes | OK
10 | DNV Transport Qld | Silver | Yes | OK
11 | Iona | Silver | Yes | OK
12 | Republic Bar and Lounge | Silver | Yes | OK
13 | Bayside Health Nook | Bronze | Yes | OK
14 | BazTech Construction | Bronze | Yes | OK
15 | C&H Recruitment | Bronze | Yes | Fix the world
16 | Complete Dental Wynnum | Bronze | Yes | OK
17 | EDB Training Services | Bronze | Yes | OK
18 | Gage Roads Brew Co | Bronze | Yes | OK
19 | Joan Pease | Bronze | Yes | OK
20 | Lawn Pride Australia | Bronze | Yes | OK
21 | Mack Services | Bronze | Yes | OK
22 | MDA Cabinets | Bronze | Yes | OK
23 | Port of Brisbane | Bronze | Yes | OK
24 | Reece Tully | Bronze | Yes | OK
25 | Safeguard Inspections | Bronze | Yes | OK
26 | The Small Business Lawyer | Bronze | Yes | OK
27 | The Source Bulk Foods Manly West | Bronze | Yes | OK
28 | Topp Shopp & Office Fitters | Bronze | Yes | OK
29 | Wynnum Manly Veterinary Hospital | Bronze | Yes | OK
30 | Andrew Woodforth Marine | Junior | Yes | OK
31 | Collar Recruitment | Junior | Yes | OK
32 | Bayside Property | Junior | Yes | OK
33 | Leading Edge Prosthetics | Junior | Yes | OK
34 | Ocean Realty | Junior | Yes | OK
35 | Reemax | Junior | Yes | OK
36 | Smartframe | Junior | Yes | OK
37 | Tru Blu Trophies | Junior | Yes | OK
LOGOS FROM PREVIOUS YEARS
No | Name | Year | Logo? | Note
 | 1300 ePromo |  | Yes
 | ActiveHire |  | Yes
 | Aliweld |  | Yes
 | AMHARC |  | Yes
 | Ampol |  | Yes
 | Astute Financial |  | Yes
 | Bartons |  | Yes
 | Bayside Medical |  | Yes
 | Belle Real Estate |  | Yes
 | BLK |  | Yes
 | Buildia |  | Yes
 | Caltex |  | Yes
 | Capitol Coatings |  | Yes
 | CedarAndPine |  | Yes
 | CG Catering |  | Yes
 | CityCave |  | Yes
 | CNW Electrical |  | Yes
 | CompleteDental |  | Yes
 | DentalOnCambridge |  | Yes
 | DMCQueensland |  | Yes
 | Easy Living |  | Yes
 | Ecopool |  | Yes
 | EDB |  | Yes
 | Electrofire |  | Yes
 | EvolvedEngineering |  | Yes
 | Falcon Cranes |  | Yes
 | Fig Resteraunt |  | Yes
 | Fitzroy Island |  | Yes
 | HazMat Plus |  | Yes
 | IFC |  | Yes
 | IFeelGood |  | Yes
 | InspiredBuilt |  | Yes
 | Intercept |  | Yes
 | InvestmentZone |  | Yes
 | JoyConstructions |  | Yes
 | KebabZone |  | Yes
 | KeidlnElectrical |  | Yes
 | Kickons |  | Yes
 | Kris Webb Constructions |  | Yes
 | LandscapeSolutions |  | Yes
 | LHDLAwyers |  | Yes
 | MCElectric |  | Yes
 | MDACabinets |  | Yes
 | Minipump |  | Yes
 | MoodyCivil |  | Yes
 | Mosh |  | Yes
 | MovePodiatry |  | Yes
 | Murrays Concrete |  | Yes
 | Nailedit Creations |  | Yes
 | NestHomes |  | Yes
 | Perrys Fruit |  | Yes
 | Pita Pit |  | Yes
 | Place Realestate |  | Yes
 | PoolWerx |  | Yes
 | Port of Brisbane |  | Yes
 | RBC Electrical Solutions |  | Yes
 | Reece Tully |  | Yes
 | Remax |  | Yes
 | Ross Planning |  | Yes
 | Safeguard Inspections |  | Yes
 | SBI Group |  | Yes
 | Simient |  | Yes
 | Sleeper Hut |  | Yes
 | Sonic6 |  | Yes
 | Spot |  | Yes
 | SSSSigns |  | Yes
 | TasteTheAroma |  | Yes
 | The MasterMind |  | Yes
 | Thor Demolition |  | Yes
 | Vet Hospital |  | Yes
 | Waterloo Bay |  | Yes
 | Wynnum RSL |  | Yes
 | YDF |  | Yes
