dhskinner/Scoreboard/Sponsors/2017_Season/2017 Sponsors.xlsx

Sheet: Sheet1
TYPE | PACKAGE TITLE | COMPANY | Domain | LOGO REC'D | Programmed |  | Tagline | Club | Netball | Seniors | PLATINUM | GOLD | SILVER | BRONZE
CLUB | PLATINUM CLUB SPONSOR | Waterloo Hotel | hambros.com.au | X | Yes |  |  | TRUE | FALSE | FALSE | TRUE | FALSE | FALSE | FALSE
NETBALL | GOLD SPONSOR |  |  |  | No |  |  | FALSE | TRUE | FALSE | FALSE | TRUE | FALSE | FALSE
CLUB | GOLD SPONSOR | MDA Cabinets | gmail.com | X | Yes | Logo OK | Quality, Service, Craftmanship | TRUE | FALSE | FALSE | FALSE | TRUE | FALSE | FALSE
CLUB/SENIORS | GOLD SPONSOR | Capitol Coatings |  |  | No |  |  | TRUE | FALSE | TRUE | FALSE | TRUE | FALSE | FALSE
CLUB/NETBALL | SILVER SPONSOR | Aussie Home Loans | aussie.com.au | X | Yes |  |  | TRUE | TRUE | FALSE | FALSE | FALSE | TRUE | FALSE
CLUB/NETBALL | SILVER SPONSOR | Caltex | caltex.com.au | X | Yes |  |  | TRUE | TRUE | FALSE | FALSE | FALSE | TRUE | FALSE
CLUB/NETBALL | SILVER SPONSOR | I Feel Good | ifeelgood247.com.au | X | Yes |  |  | TRUE | TRUE | FALSE | FALSE | FALSE | TRUE | FALSE
CLUB/NETBALL | SILVER SPONSOR | Belle | bellproperty.com.au | X | Yes |  |  | TRUE | TRUE | FALSE | FALSE | FALSE | TRUE | FALSE
SENIORS | SILVER SPONSOR | SBI group | sbigroup.net.au | X | No | Could not confirm logo |  | FALSE | FALSE | TRUE | FALSE | FALSE | TRUE | FALSE
CLUB | SILVER SPONSOR | 1300epromo | 1300epromo.com.au | X | Yes |  |  | TRUE | FALSE | FALSE | FALSE | FALSE | TRUE | FALSE
NETBALL | SILVER SPONSOR | Caltex | caltex.com.au | X | Yes |  |  | FALSE | TRUE | FALSE | FALSE | FALSE | TRUE | FALSE
CLUB | SILVER SPONSOR | Your Digital File | yourdigitalfile.com | X | Yes | Logo OK |  | TRUE | FALSE | FALSE | FALSE | FALSE | TRUE | FALSE
SENIORS | BRONZE SPONSOR | The Mastermind | businessnet.com.au | X | No | Could not confirm logo |  | FALSE | FALSE | TRUE | FALSE | FALSE | FALSE | TRUE
CLUB/NETBALL | BRONZE SPONSOR | Joan Pease | parliament.qld.gov.au | X | Yes | Could not confirm logo |  | TRUE | TRUE | FALSE | FALSE | FALSE | FALSE | TRUE
CLUB/NETBALL | BRONZE SPONSOR | Easy Living | easy-living.com.au | X | Yes |  |  | TRUE | TRUE | FALSE | FALSE | FALSE | FALSE | TRUE
CLUB | BRONZE SPONSOR | Perry's Fruit | perrysfruit.com | X | Yes |  | Picked with passion / #PERRYSFRUITMARKET | TRUE | FALSE | FALSE | FALSE | FALSE | FALSE | TRUE
SENIORS | Senior polo shirts | EDB | edbtraining.com.au | X | Yes | Logo OK | Excellence, Development and Business (EDB) Training | FALSE | FALSE | TRUE | FALSE | FALSE | FALSE | FALSE
SENIORS | Senior polo shirts | Eco Pools | ecopools.com.au | X | Yes |  |  | FALSE | FALSE | TRUE | FALSE | FALSE | FALSE | FALSE
CLUB | JNR KITS U16 | Bartons | bartons.net.au | X | Yes |  |  | TRUE | FALSE | FALSE | FALSE | FALSE | FALSE | FALSE
CLUB | JNR KITS U13 | Active Hire | activehire.com.au | X | Yes | Logo OK | From eskies to excavators - we can help - hire sales repairs | TRUE | FALSE | FALSE | FALSE | FALSE | FALSE | FALSE
SENIORS | SNR JERSEY SLEEVE | Murrays | murraysconcretecutting.com.au | X | Yes | Logo OK | Concrete cutting and demolition | FALSE | FALSE | TRUE | FALSE | FALSE | FALSE | FALSE
SENIORS | SNR JERSEY SLEEVE | Baztech | gmail.com | X | Yes |  |  | FALSE | FALSE | TRUE | FALSE | FALSE | FALSE | FALSE
SENIORS | SNR JERSEY SLEEVE | Kebabzone | hotmail.com | X | Yes | No logo | @WynnumKebabZone / find us on facebook | FALSE | FALSE | TRUE | FALSE | FALSE | FALSE | FALSE
SENIORS | SNR JERSEY SLEEVE | Simient | simient.com | X | Yes |  |  | FALSE | FALSE | TRUE | FALSE | FALSE | FALSE | FALSE
CLUB | GAME DAY - OLD BOYS DAY | Move Podiatry | movepodiatry.com.au | X | Yes | Logo OK | Your feet are your foundation | TRUE | FALSE | FALSE | FALSE | FALSE | FALSE | FALSE
CLUB | GAME DAY - FIRST GAME | Complete Dental | completedentalwynnum.com.au | X | Yes | Logo OK |  | TRUE | FALSE | FALSE | FALSE | FALSE | FALSE | FALSE
CLUB | GAME DAY - OLD BOYS DAY | Epromo | epromo.com.au | X | Yes |  |  | TRUE | FALSE | FALSE | FALSE | FALSE | FALSE | FALSE
 |  | Mack Services | live.com.au | X | No |  |  | FALSE | FALSE | FALSE | FALSE | FALSE | FALSE | FALSE
 |  | ilove2Plumb | gmail.com | X | No |  |  | FALSE | FALSE | FALSE | FALSE | FALSE | FALSE | FALSE

Sheet: Sheet3
Sponsor | Programmed
Waterloo Hotel | Yes
Waterloo Motel | Yes
Fig Restaurant | Yes
Bartons | Yes
Caltex | Yes
MDA Cabinets | Yes
Capitol Coatings | No
Your Digital file | Yes
SBI Group | Yes
Aussie | Yes
I feel Good 24/7 | Yes
Belle | Yes
1300 epromo | Yes
Easy living | Yes
Simient | Yes
Eco pools | Yes
EDB Training | Yes
Active Hire | Yes
Perry’s Fruit Market | Yes
Mastermind | Yes
Joan Pease | Yes
Kebabzone | Yes
Baztech | Yes
I Love 2 Plumb | Yes
Mack Electrical | Yes
Intercept | Yes
Pita Pit | Yes

Sheet: Sheet2
COMPANY | LOGO REC'D | Programmed
1300epromo | X | Yes
Active Hire | X | No
Aussie Home Loans | X | Yes
Bartons | X | Yes
Baztech | X | Yes
Belle | X | Yes
Caltex | X | Yes
Capitol Coatings |  | No
Complete Dental | X | No
Easy Living | X | Yes
Eco Pools | X | Yes
EDB | X | No
Epromo | X | Yes
I Feel Good | X | Yes
ilove2Plumb | X | No
Joan Pease | X | No
Kebabzone | X | No
Mack Services | X | No
MDA Cabinets | X | No
Move Podiatry | X | No
Murrays | X | No
Perry's Fruit | X | No
SBI group | X | No
Simient | X | Yes
The Mastermind | X | No
Waterloo Hotel | X | Yes
Your Digital File | X | No
