dhskinner/Scoreboard/Design/DMD Template.SLDASM

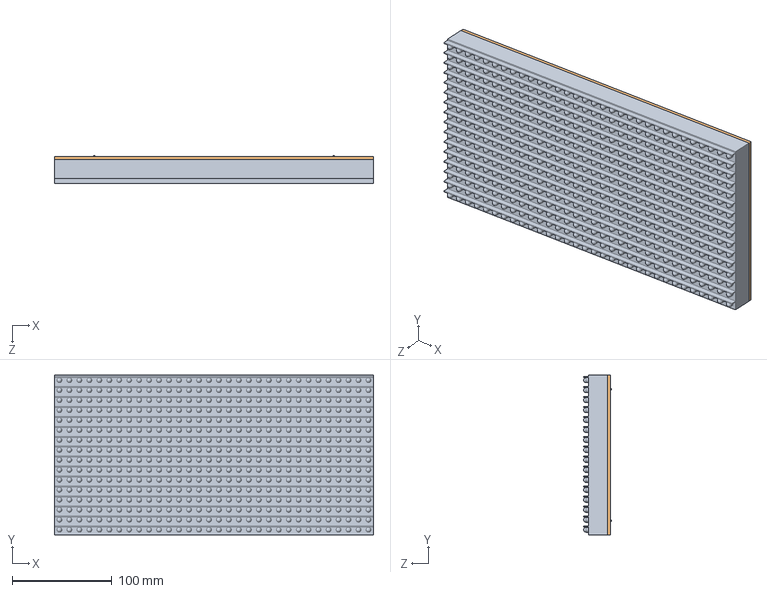
[picture p18: CAD file, 2017-08-02]
Design/DMD Template.SLDASM
320.0 x 160.0 x 28.0 mm
Freetronics DMD
DMD Template^DMD Template
