dhskinner/Scoreboard/Design/Solidworks Mini Timer/Scoreboard Timer.SLDASM

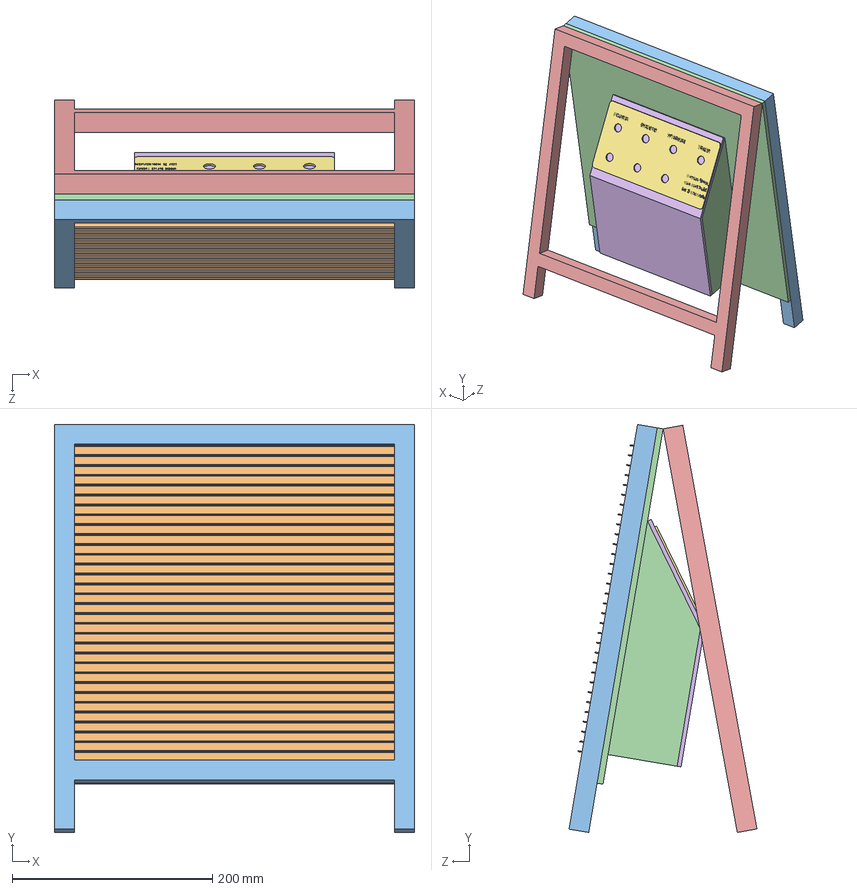
[picture p19: CAD file, 2017-08-02]
Design/Solidworks Mini Timer/Scoreboard Timer.SLDASM
360.0 x 407.6 x 187.8 mm
Battery SLA HT-12V-7.2AH-20HR
Freetronics DMD Simplified x 2
Scoreboard Timer Frame Front
Scoreboard Timer Back
Scoreboard Timer Frame Back
Scoreboard Tomer Cover
Scoreboard Timer Switch Plate
