dhskinner/Scoreboard/Design/Solidworks Mini Timer/Scoreboard Timer Electronics.SLDASM

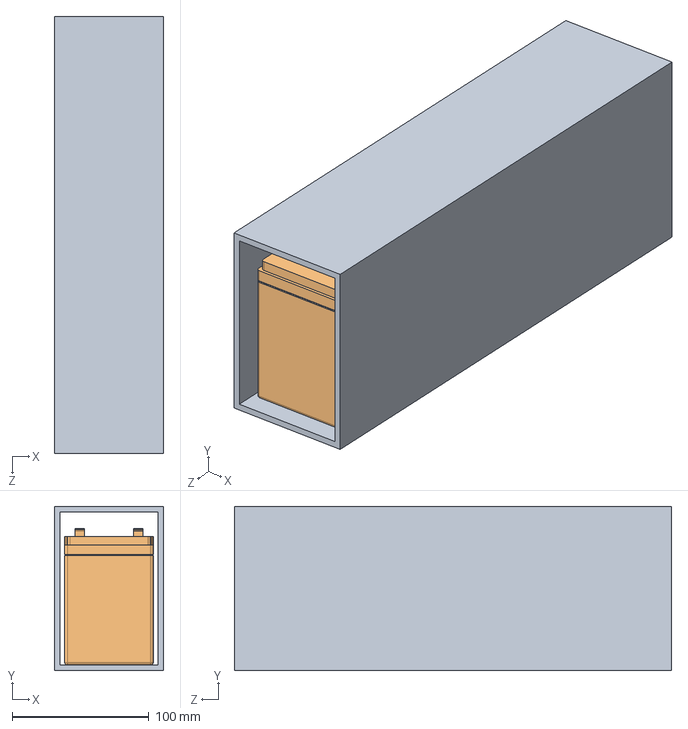
[picture p20: CAD file, 2017-08-02]
Design/Solidworks Mini Timer/Scoreboard Timer Electronics.SLDASM
80.0 x 120.0 x 320.0 mm
Timer Electronics
Battery SLA HT-12V-7.2AH-20HR
