dhskinner/Scoreboard/Design/Solidworks Scoreboard/Scoreboard - Power Supply Shield B.SLDASM

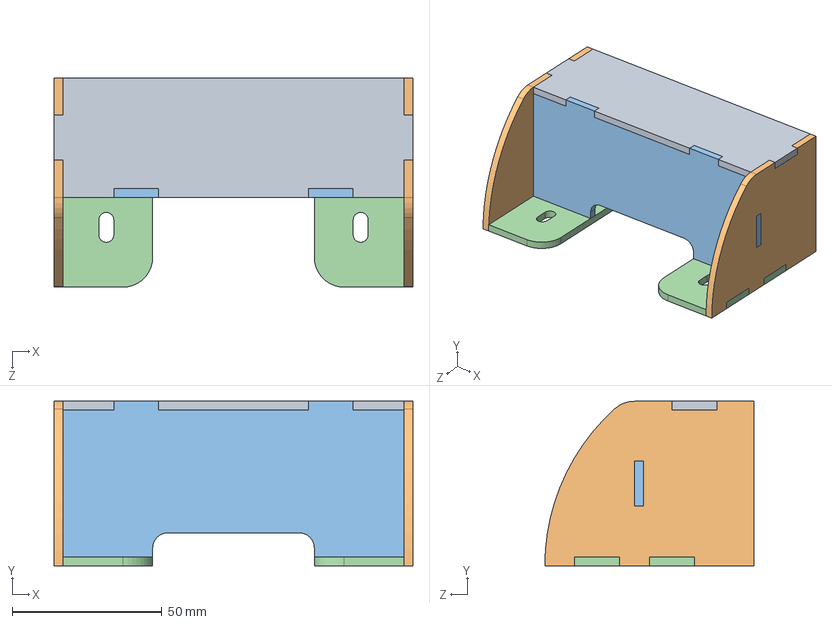
[picture p21: CAD file, 2017-08-02]
Design/Solidworks Scoreboard/Scoreboard - Power Supply Shield B.SLDASM
120.0 x 55.0 x 70.0 mm
Power Supply - Shield I
Power Supply - Shield H x 2
Power Supply - Shield J
Power Supply - Shield K x 2
