dhskinner/Scoreboard/Design/Solidworks Controller WIFI/NRF24L01+PA.SLDASM

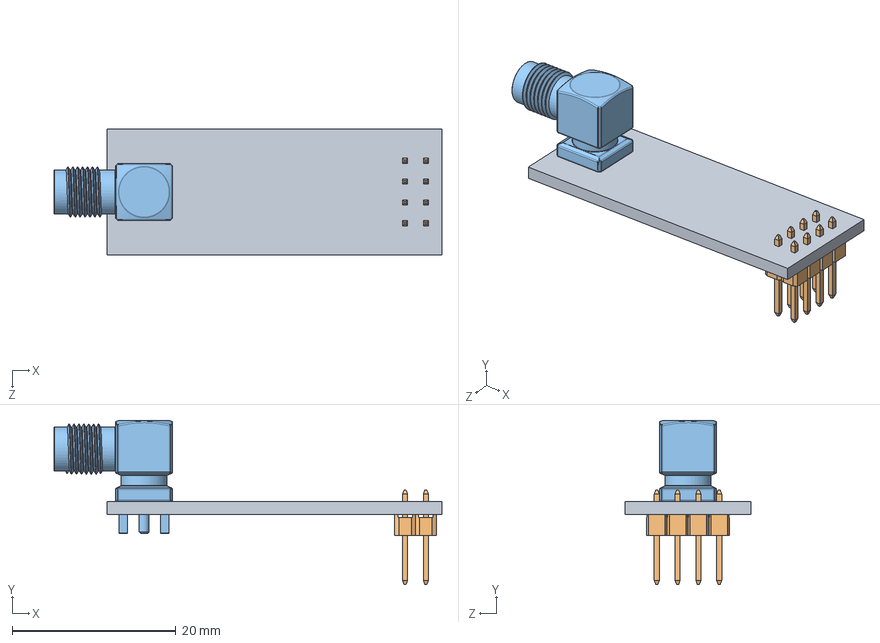
[picture p22: CAD file, 2020-08-17]
Design/Solidworks Controller WIFI/NRF24L01+PA.SLDASM
47.4 x 20.0 x 15.4 mm
NRF24L01
pin header double row- 20 contacts
SMA-angled
