dhskinner/Scoreboard/Design/Solidworks Scoreboard/Scoreboard - Trolley Side Front.SLDASM

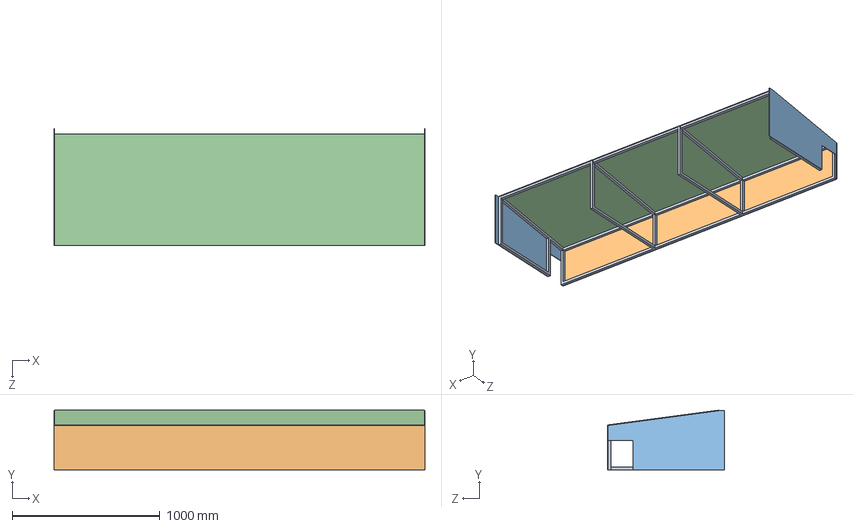
[picture p23: CAD file, 2017-08-02]
Design/Solidworks Scoreboard/Scoreboard - Trolley Side Front.SLDASM
2508.0 x 403.9 x 792.0 mm
Scoreboard - Trolley Signboard Frame - Front
Signboard - Side
Signboard - Back x 2
Signboard - Top
