dhskinner/Scoreboard/Design/Solidworks Scoreboard/Electronics Sled Triple.SLDASM

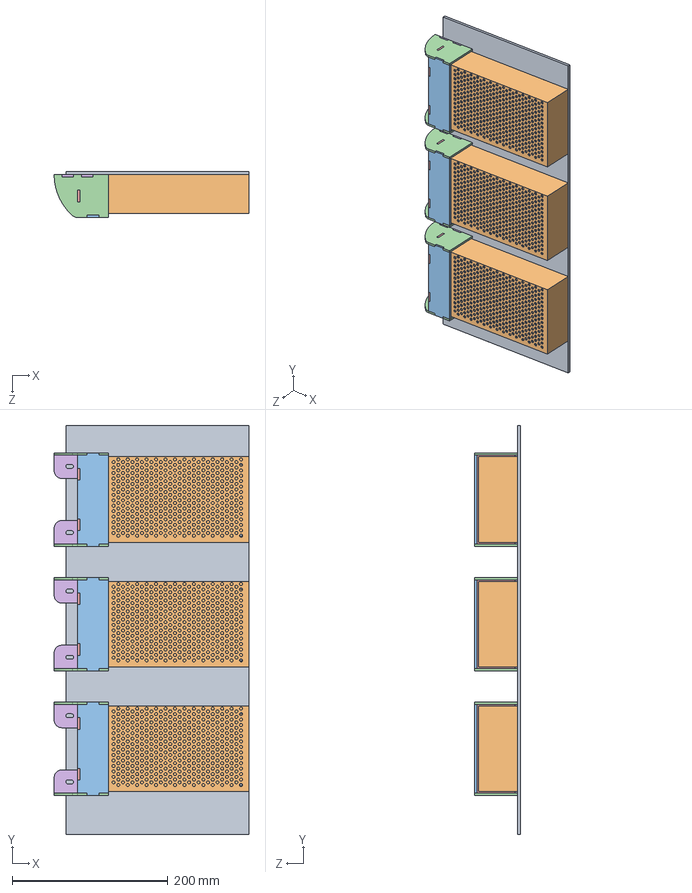
[picture p24: CAD file, 2017-08-02]
Design/Solidworks Scoreboard/Electronics Sled Triple.SLDASM
250.0 x 525.0 x 59.0 mm
Electronics Sled Triple
Power Supply 5V40A x 3
Power Supply - Shield I x 3
Power Supply - Shield H x 6
Power Supply - Shield J x 3
Power Supply - Shield K x 6
