dhskinner/Scoreboard/Design/Solidworks Mini Timer/Scoreboard Timer 2.SLDASM

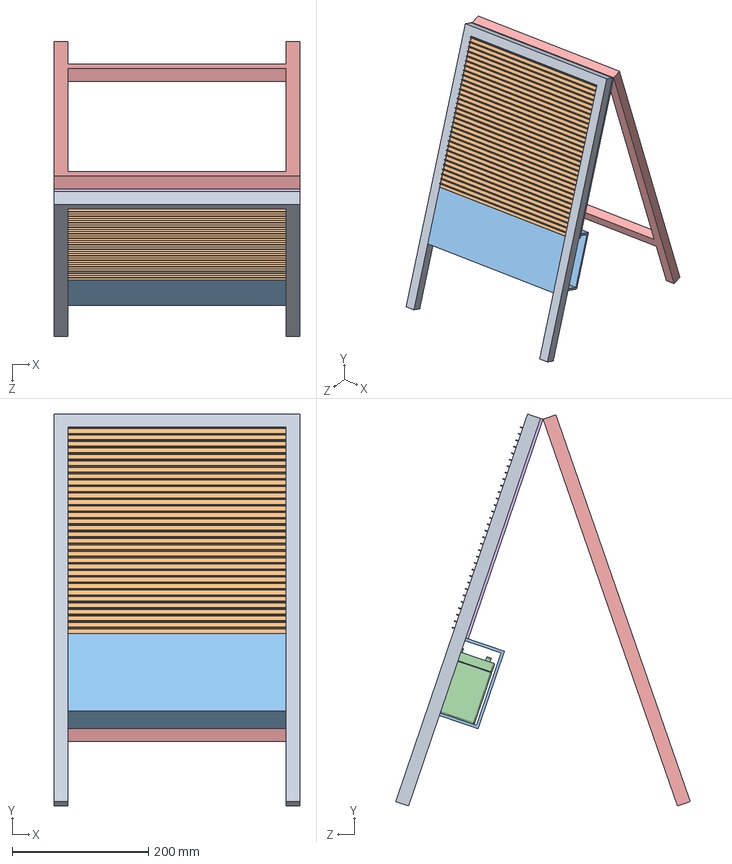
[picture p25: CAD file, 2017-08-02]
Design/Solidworks Mini Timer/Scoreboard Timer 2.SLDASM
360.0 x 574.5 x 431.8 mm
Scoreboard Timer Frame Front IISLDPRT
Freetronics DMD Simplified x 2
Timer Electronics
Battery SLA HT-12V-7.2AH-20HR
Scoreboard Timer Frame Back 2
Scoreboard Timer Back 2
