dhskinner/Scoreboard/Design/Solidworks Scoreboard/Electronics Sled.SLDASM

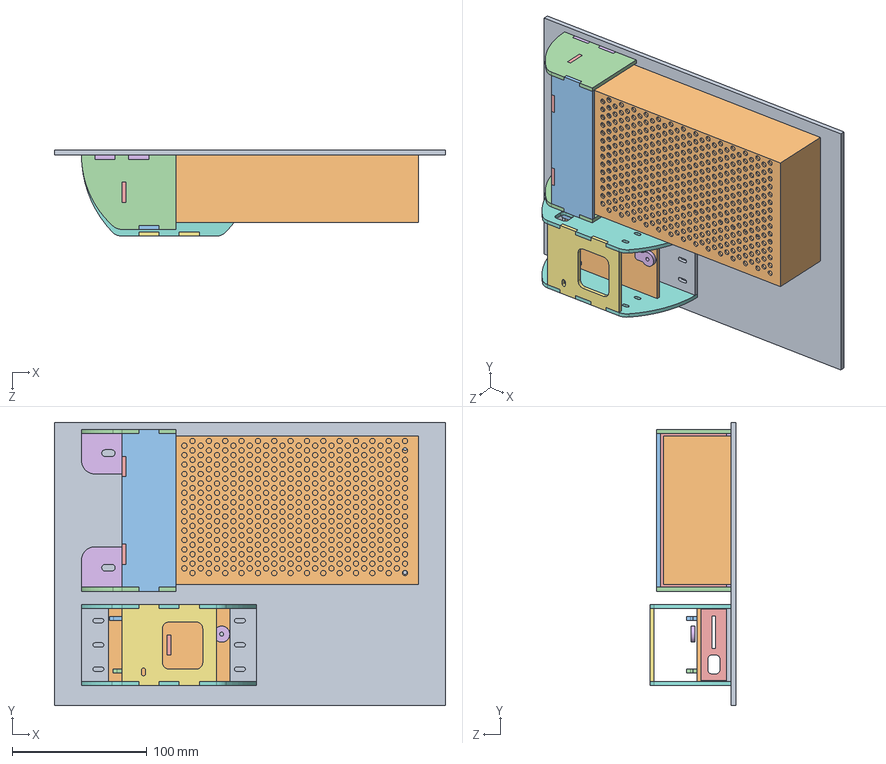
[picture p26: CAD file, 2017-08-02]
Design/Solidworks Scoreboard/Electronics Sled.SLDASM
290.0 x 210.0 x 64.0 mm
Electronics Sled
Power Supply 5V40A
Power Supply - Shield I
Power Supply - Shield H x 2
Power Supply - Shield J
Power Supply - Shield K x 2
Processor - Shield CBare
Processor - Shield ABare x 2
Processor - Shield BBare
Processor - Shield DBare
Processor - Shield EBare
Processor - Shield FBare
Processor - Shield GBare
Processor - Shield HBare
