dhskinner/Scoreboard/Design/Solidworks Scoreboard/Scoreboard LED 4x2 Panel.SLDASM

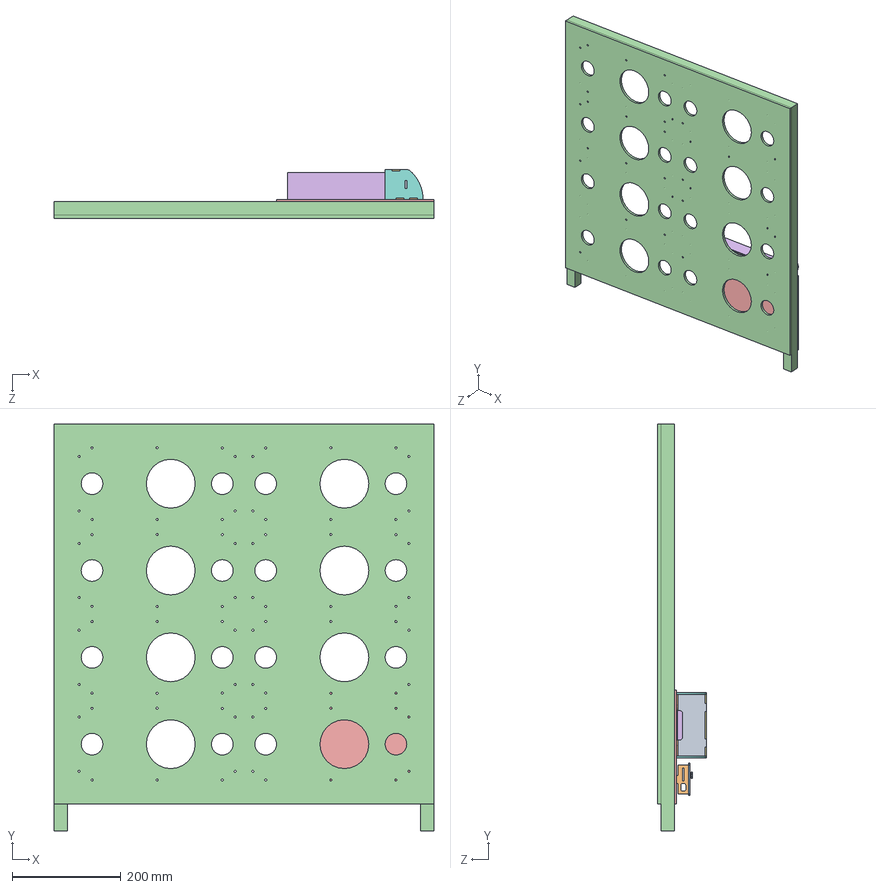
[picture p27: CAD file, 2017-08-02]
Design/Solidworks Scoreboard/Scoreboard LED 4x2 Panel.SLDASM
700.0 x 750.0 x 90.0 mm
Scoreboard 4 x 2 Frame
Electronics Sled
Power Supply 5V40A
Power Supply - Shield I
Power Supply - Shield H x 2
Power Supply - Shield J
Power Supply - Shield K x 2
Processor - Shield DBare
Processor - Shield GBare
Processor - Shield HBare
