dhskinner/Scoreboard/Design/Solidworks Scoreboard/ScoreBoard.SLDASM

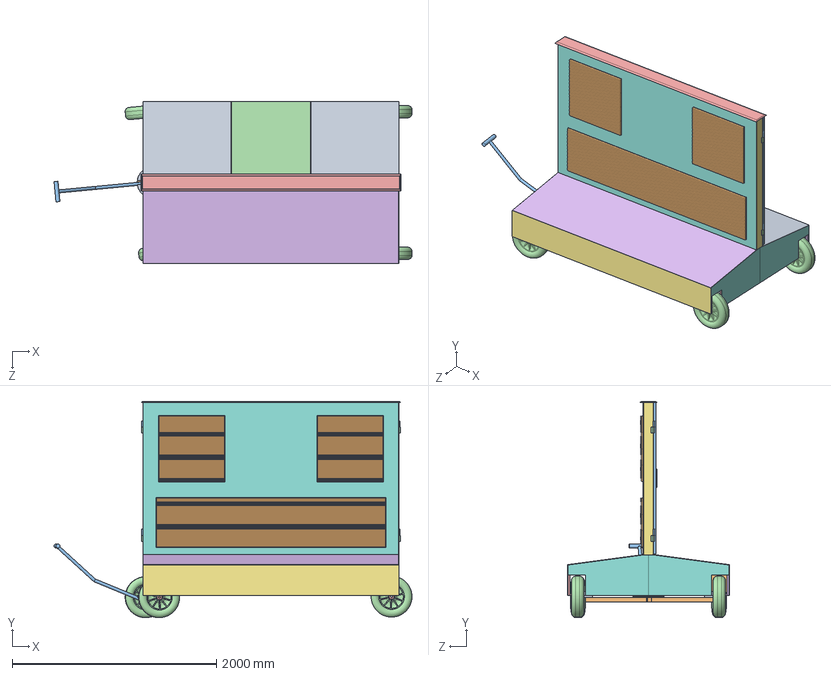
[picture p28: CAD file, 2017-08-02]
Design/Solidworks Scoreboard/ScoreBoard.SLDASM
3502.7 x 2115.9 x 1583.9 mm
Scoreboard - Trolley 2
Scoreboard Axle - Front
Scoreboard - Trolley Handle
Scoreboard - Trolley Wheel x 4
Washer 19x50x3 x 8
Scoreboard - Trolley Signboard Frame - Back
Signboard - Side x 2
Signboard - Back x 4
Signboard - Back Half x 2
Plywood - Back Storage
Scoreboard - Trolley Signboard Frame - Back Hatch
Signboard - Back Hatch
Scoreboard - Trolley Signboard Frame - Front
Signboard - Top
Scoreboard - Frame
Scoreboard Front
Scoreboard 7 x 3 Frame
Freetronics DMD Simplified x 37
Electronics Sled Triple
Power Supply 5V40A x 5
Power Supply - Shield I x 5
Power Supply - Shield H x 10
Power Supply - Shield J x 5
Power Supply - Shield K x 10
Scoreboard 4 x 2 Frame x 2
Electronics Sled x 2
Processor - Shield CBare x 2
Processor - Shield ABare x 4
Processor - Shield BBare x 2
Processor - Shield DBare x 2
Processor - Shield EBare x 2
Processor - Shield FBare x 2
Processor - Shield GBare x 2
Processor - Shield HBare x 2
Scoreboard - Door Frame x 2
Hinge x 4
Scoreboard - Flashing
