dhskinner/Scoreboard/Design/Solidworks Controller ULCD/Scoreboard Controller Base.SLDASM

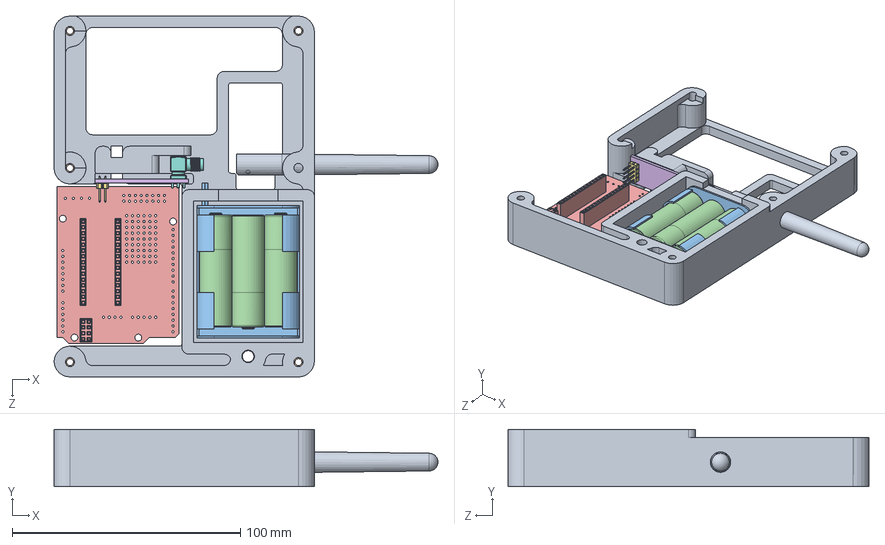
[picture p29: CAD file, 2017-08-02]
Design/Solidworks Controller ULCD/Scoreboard Controller Base.SLDASM
168.1 x 25.0 x 158.0 mm
Nut SS304 M5
3xAA Battery Holder
AA Battery x 3
Nano Breakout Controller
NRF24L01
pin header double row- 20 contacts
SMA-angled
SMA Antenna Dipole
Scoreboard Controller Base 3D
Nut SS304 M3 x 6
