dhskinner/Scoreboard/Design/Solidworks Scoreboard/Scoreboard - Trolley.SLDASM

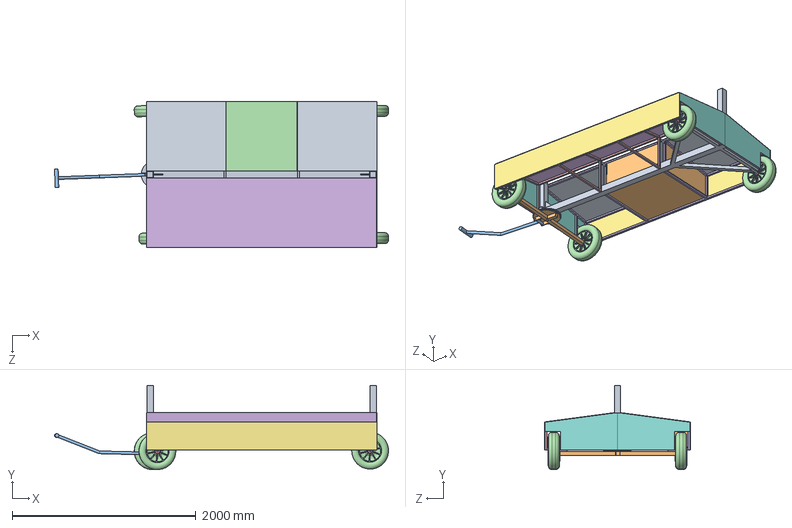
[picture p30: CAD file, 2017-08-02]
Design/Solidworks Scoreboard/Scoreboard - Trolley.SLDASM
3633.2 x 915.0 x 1583.9 mm
Scoreboard - Trolley 2
Scoreboard Axle - Front
Scoreboard - Trolley Handle
Scoreboard - Trolley Wheel x 4
Washer 19x50x3 x 8
Scoreboard - Trolley Signboard Frame - Back
Signboard - Side x 2
Signboard - Back x 4
Signboard - Back Half x 2
Plywood - Back Storage
Scoreboard - Trolley Signboard Frame - Back Hatch
Signboard - Back Hatch
Scoreboard - Trolley Signboard Frame - Front
Signboard - Top
