dhskinner/Scoreboard/Design/Solidworks Scoreboard/Scoreboard - Trolley Side Back.SLDASM

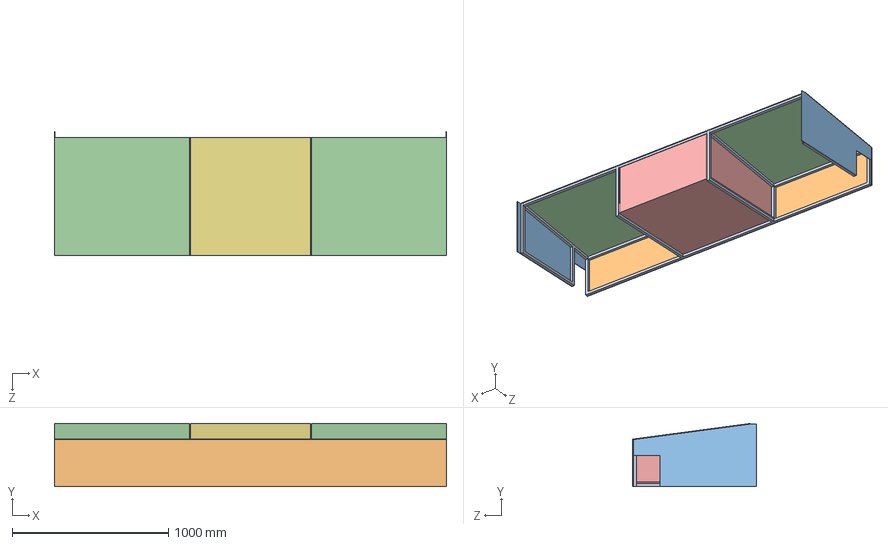
[picture p31: CAD file, 2017-08-02]
Design/Solidworks Scoreboard/Scoreboard - Trolley Side Back.SLDASM
2508.0 x 403.9 x 792.0 mm
Scoreboard - Trolley Signboard Frame - Back
Signboard - Side
Signboard - Back x 2
Signboard - Back Half x 2
Plywood - Back Storage
Scoreboard - Trolley Signboard Frame - Back Hatch
Signboard - Back Hatch
