dhskinner/Scoreboard/Design/Solidworks Scoreboard/Scoreboard - Trolley Wheel.SLDASM

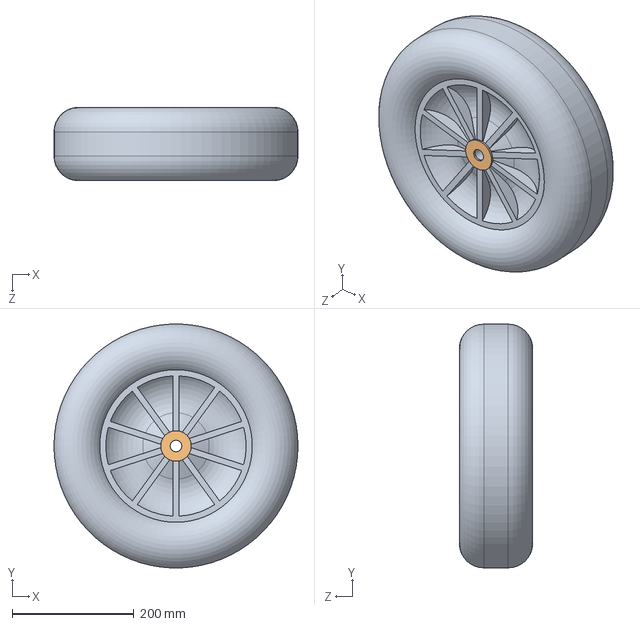
[picture p32: CAD file, 2017-08-02]
Design/Solidworks Scoreboard/Scoreboard - Trolley Wheel.SLDASM
400.0 x 399.6 x 120.1 mm
Scoreboard - Trolley Wheel
Washer 19x50x3 x 2
