dhskinner/Scoreboard/Design/Solidworks Scoreboard/Scoreboard LED 7x3 Panel - Triple Row.SLDASM

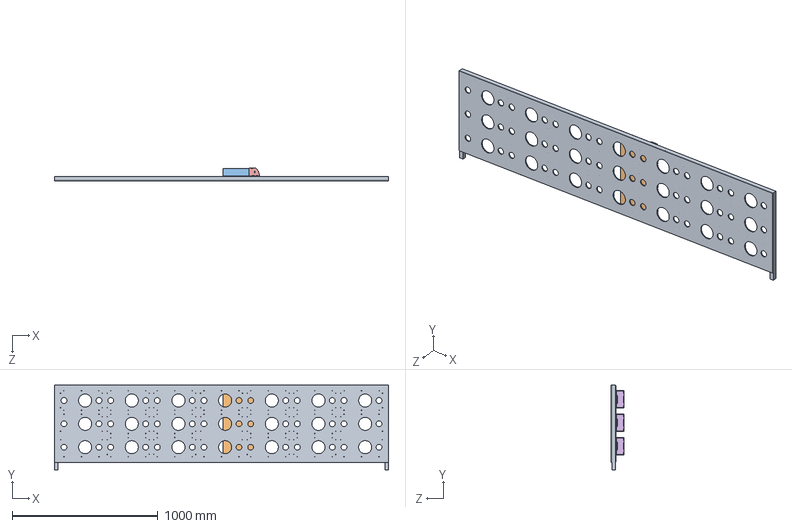
[picture p33: CAD file, 2017-08-02]
Design/Solidworks Scoreboard/Scoreboard LED 7x3 Panel - Triple Row.SLDASM
2290.0 x 580.0 x 90.0 mm
Scoreboard 7 x 3 Frame
Electronics Sled Triple
Power Supply 5V40A x 3
Power Supply - Shield I x 3
Power Supply - Shield H x 6
Power Supply - Shield J x 3
Power Supply - Shield K x 6
