dhskinner/Scoreboard/Design/Solidworks Scoreboard/Scoreboard - Trolley 2.SLDASM

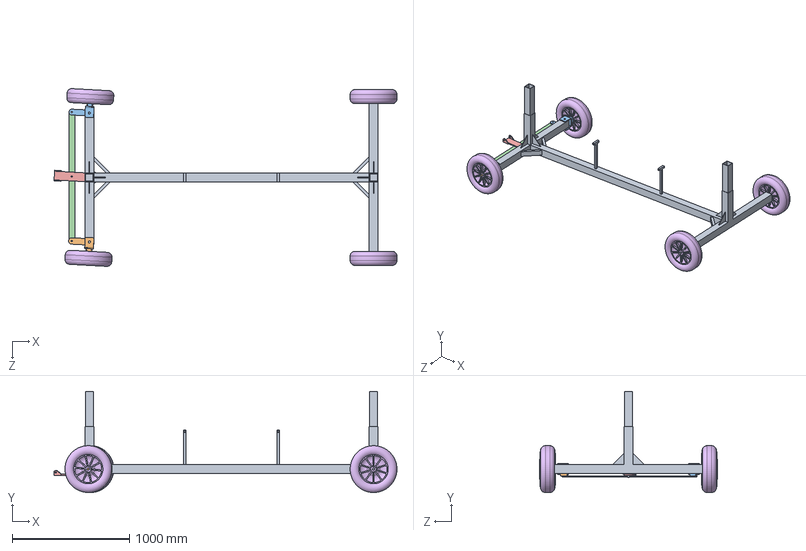
[picture p34: CAD file, 2017-08-02]
Design/Solidworks Scoreboard/Scoreboard - Trolley 2.SLDASM
2927.1 x 862.5 x 1517.5 mm
Scoreboard - Trolley 2
Trolley Front Wheel Mount Left
Trolley Front Wheel Mount Right
Scoreboard - Trolley Steering Bar
Scoreboard - Trolley Steering Tang
Scoreboard - Trolley Wheel x 4
