dhskinner/Scoreboard/Design/Solidworks Controller WIFI/SMA Antenna.SLDASM

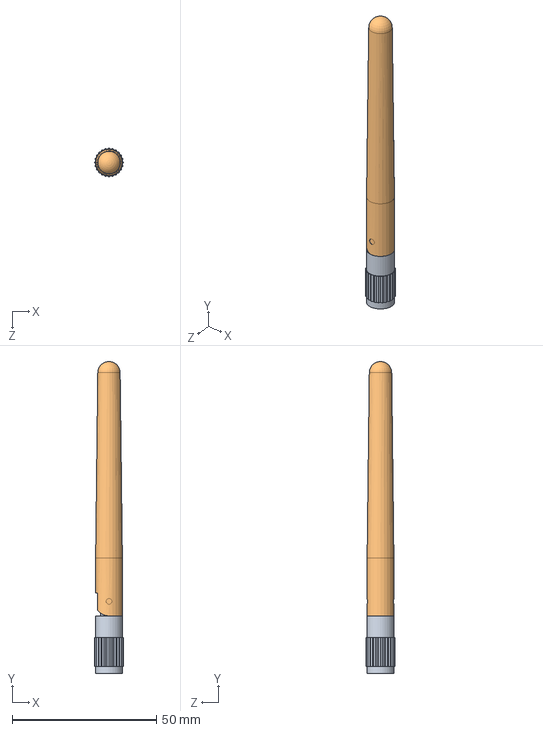
[picture p35: CAD file, 2020-08-17]
Design/Solidworks Controller WIFI/SMA Antenna.SLDASM
10.0 x 108.2 x 10.0 mm
SMA Antenna Base
SMA Antenna Dipole
