dhskinner/Scoreboard/Design/Solidworks Scoreboard/Scoreboard - Board.SLDASM

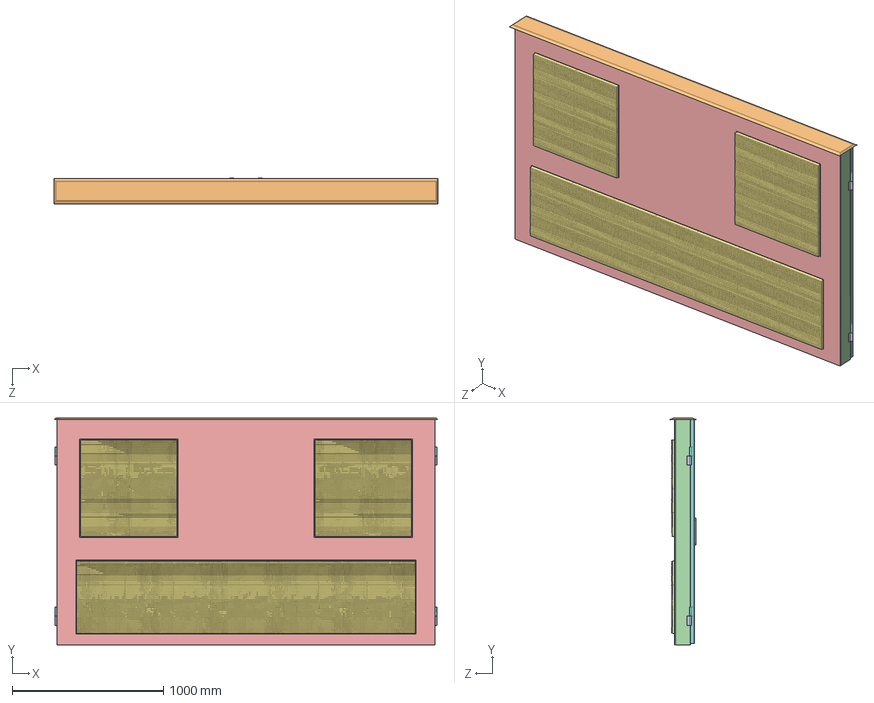
[picture p36: CAD file, 2017-08-02]
Design/Solidworks Scoreboard/Scoreboard - Board.SLDASM
2540.0 x 1501.0 x 169.0 mm
Scoreboard - Frame
Scoreboard Front
Scoreboard 7 x 3 Frame
Freetronics DMD x 37
Electronics Sled Triple
Power Supply 5V40A x 5
Power Supply - Shield I x 5
Power Supply - Shield H x 10
Power Supply - Shield J x 5
Power Supply - Shield K x 10
Scoreboard 4 x 2 Frame x 2
Electronics Sled x 2
Processor - Shield DBare x 2
Processor - Shield GBare x 2
Processor - Shield HBare x 2
Scoreboard - Door Frame x 2
Hinge x 4
Scoreboard - Flashing
