dhskinner/Scoreboard/Design/Solidworks Controller ULCD/Scoreboard Controller Top.SLDASM

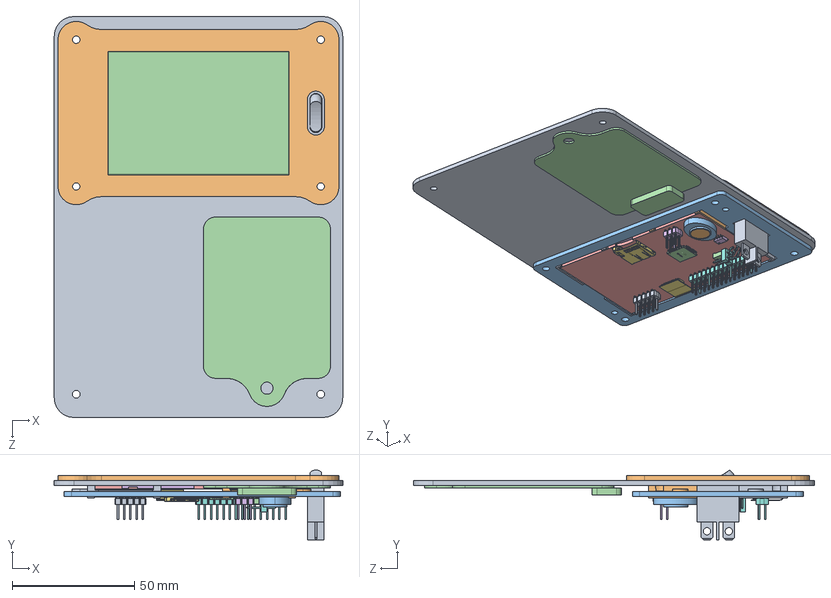
[picture p37: CAD file, 2017-08-02]
Design/Solidworks Controller ULCD/Scoreboard Controller Top.SLDASM
118.0 x 28.6 x 164.0 mm
Scoreboard Controller Base Top Face
4DLCD-35T-HVGA-BASE
4DLCD-35T-HVGA-LCDGLASS
4DLCD-35T-HVGA-GLASS
4DLCD-35T-HVGA-METAL
4DLCD-35T-HVGA-FRAME
Flex
K3D-WH1P040WA1-R5 JAE Connector Division Proprietary
Corner2 x 2
Corner1
Corner1-Trimmed
uLCD-35DT-REV1.03_Outline
Header3x2
112A-TAAR-R02_C_1
2x15Header
2x5Header
Speaker_Magnet
Speaker_Shell
User_Library-TQFP64
User_Library-SOIC-8-150_pin_SOIC_SO-150_1 x 8
User_Library-SOIC-8-150_SOIC_150_SOIC_5X4_1
K3D-WH1S040WA1-R5_JAE_Connector_Division_Proprietary
Samtec-TSM-102-01-L-DH-A
Jaycar Switch Rocker
Scoreboard Controller Base Bezel A
Scoreboard Controller Bezel B
Scoreboard Controller Base E
