dhskinner/Scoreboard/Design/Solidworks Scoreboard/Scoreboard - Processor Shield Bare.SLDASM

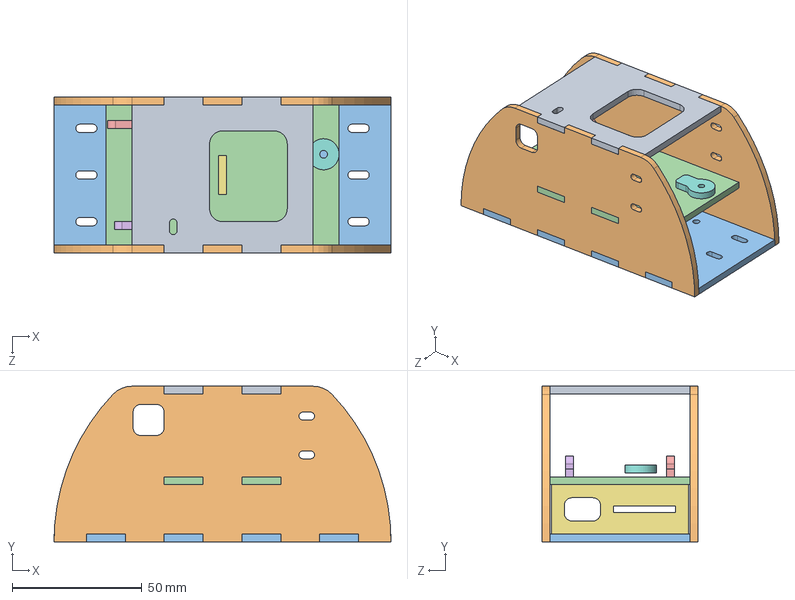
[picture p38: CAD file, 2017-08-02]
Design/Solidworks Scoreboard/Scoreboard - Processor Shield Bare.SLDASM
130.0 x 60.0 x 60.0 mm
Processor - Shield CBare
Processor - Shield ABare x 2
Processor - Shield BBare
Processor - Shield DBare
Processor - Shield EBare
Processor - Shield FBare
Processor - Shield GBare
Processor - Shield HBare
