dhskinner/Scoreboard/Design/Solidworks Controller WIFI/Adafruit HUZZAH.SLDASM

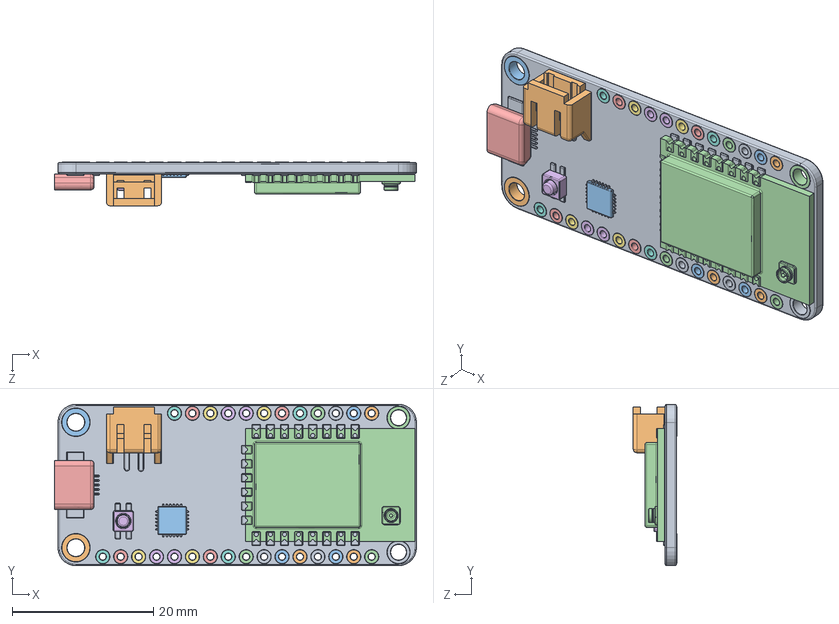
[picture p39: CAD file, 2020-08-17]
Design/Solidworks Controller WIFI/Adafruit HUZZAH.SLDASM
51.3 x 22.9 x 6.17 mm
Base PCB1
Base PCB2
Base PCB3
Base PCB4
Base PCB5
Base PCB6
Base PCB7
Base PCB8
Base PCB9
Base PCB10
Base PCB11
Base PCB12
Base PCB13
Base PCB14
Base PCB15
Base PCB16
Base PCB17
Base PCB18
Base PCB19
Base PCB20
Base PCB21
Base PCB22
Base PCB23
Base PCB24
Base PCB25
Base PCB26
Base PCB27
Base PCB28
Base PCB29
Base PCB30
Base PCB31
Base PCB32
Base PCB33
Base PCB34
Base PCB35
Base PCB36
Base PCB37
Base PCB38
