dhskinner/Scoreboard/Design/Solidworks Controller WIFI/Scoreboard Hotspot Controller.SLDASM

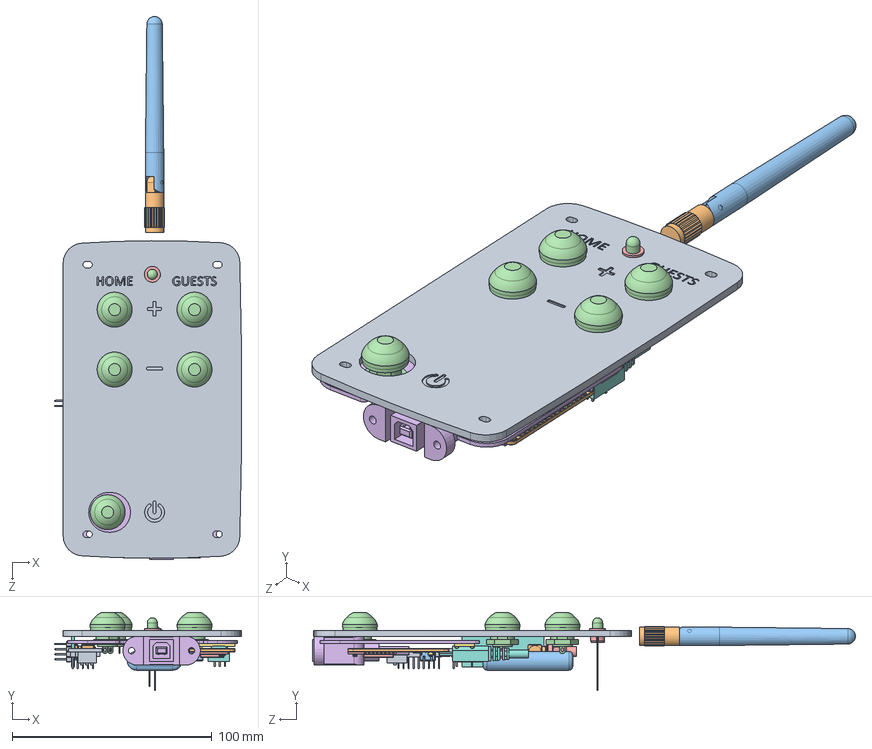
[picture p40: CAD file, 2017-08-02]
Design/Solidworks Controller WIFI/Scoreboard Hotspot Controller.SLDASM
93.8 x 39.2 x 271.9 mm
Top
Base PCB1
Base PCB2
Base PCB3
Base PCB4
Base PCB5
Base PCB6
Base PCB7
Base PCB8
Base PCB9
Base PCB10
Base PCB11
Base PCB12
Base PCB13
Base PCB14
Base PCB15
Base PCB16
Base PCB17
Base PCB18
Base PCB19
Base PCB20
Base PCB21
Base PCB22
Base PCB23
Base PCB24
Base PCB25
Base PCB26
Base PCB27
Base PCB28
Base PCB29
Base PCB30
Base PCB31
Base PCB32
Base PCB33
Base PCB34
Base PCB35
Base PCB36
Base PCB37
Base PCB38
NRF24L01
pin header double row- 20 contacts
SMA-angled
Lipo 1000mAh Battery
Button SPST Momentary IP67 x 5
SMA male
92844-005 USB CABLE B MALE TO B FEMALE PANEL MOUNT2
LIPO Fuel Gauge
micro_usb_plug
PCF8754 I2C GPIO Short
SMA Antenna Base
SMA Antenna Dipole
Led
5mm LED GROMMIT
New Scoreboard PCB V2
