dhskinner/Scoreboard/Design/Solidworks Mini Timer/Scoreboard Timer Frame Back.SLDPRT

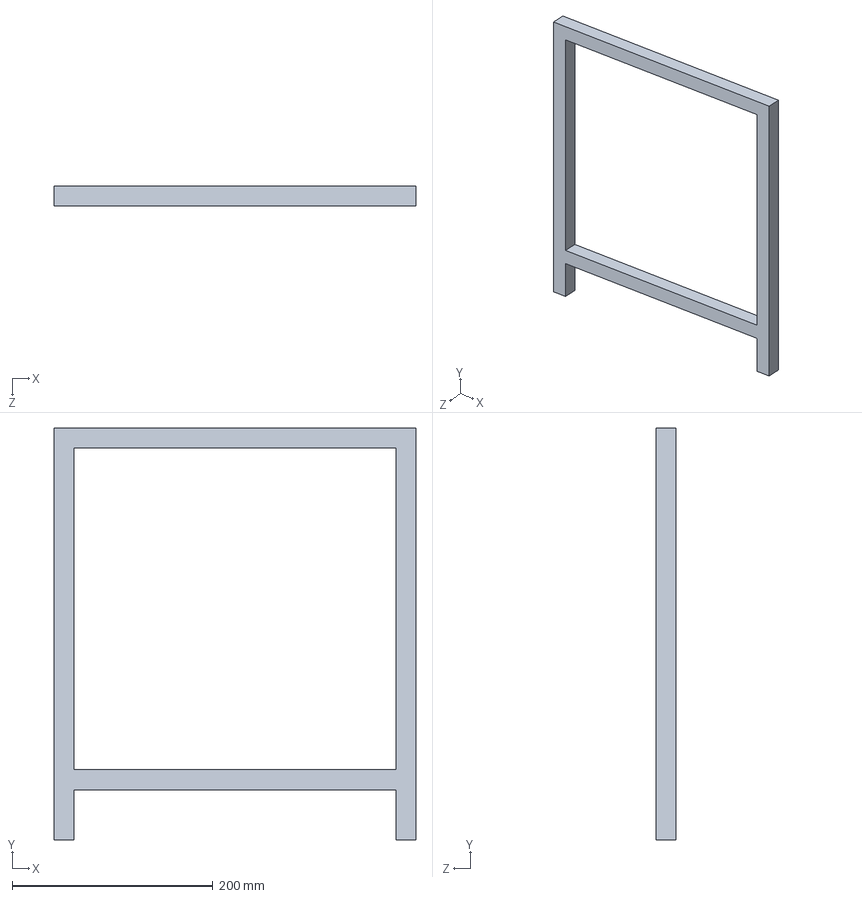
[picture p41: CAD file, 2017-08-02]
Design/Solidworks Mini Timer/Scoreboard Timer Frame Back.SLDPRT
360.0 x 410.0 x 20.0 mm
