dhskinner/Scoreboard/Design/Solidworks Scoreboard/Power Supply - Shield K.sldprt

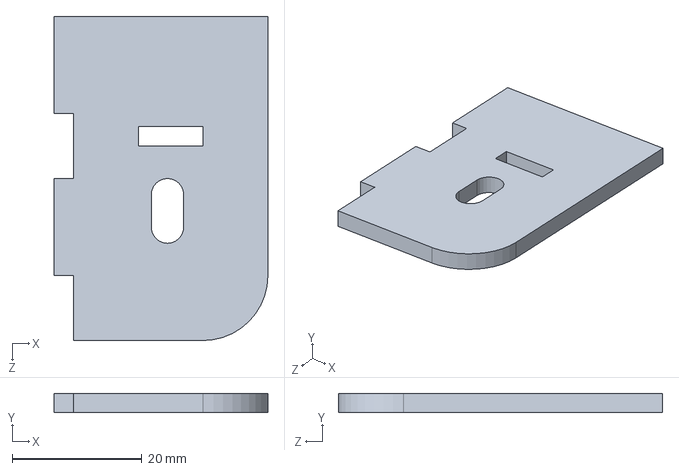
[picture p42: CAD file, 2017-08-02]
Design/Solidworks Scoreboard/Power Supply - Shield K.sldprt
33.0 x 3.00 x 50.0 mm
