dhskinner/Scoreboard/Design/Solidworks Controller ULCD/Top Face.SLDPRT

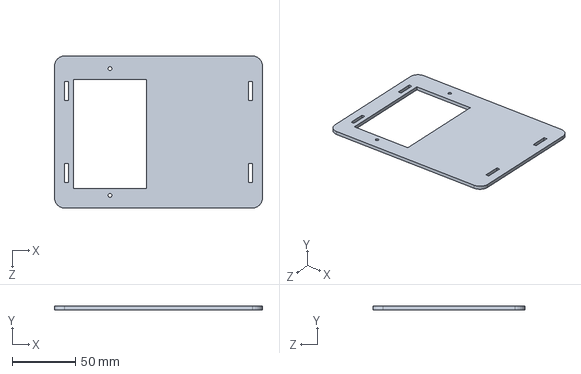
[picture p43: CAD file, 2017-08-02]
Design/Solidworks Controller ULCD/Top Face.SLDPRT
164.0 x 3.00 x 120.0 mm
