dhskinner/Scoreboard/Design/Solidworks Scoreboard/Power Supply - Shield H.sldprt

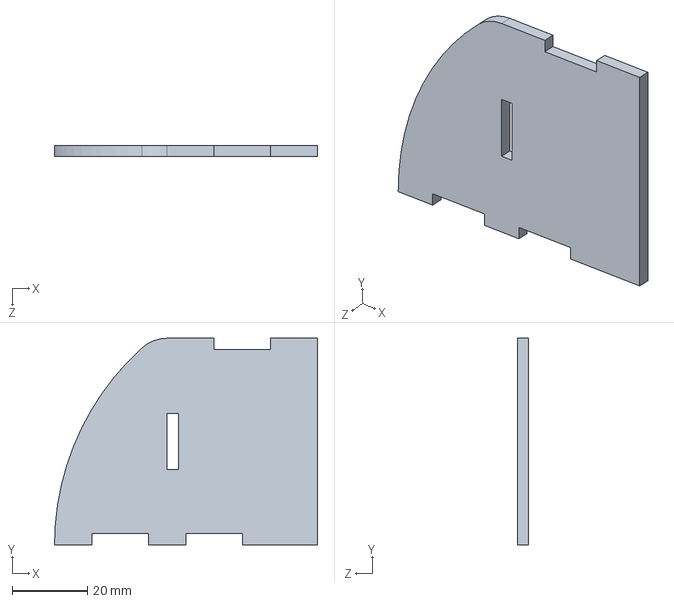
[picture p44: CAD file, 2017-08-02]
Design/Solidworks Scoreboard/Power Supply - Shield H.sldprt
70.0 x 55.0 x 3.00 mm
