dhskinner/Scoreboard/Design/Solidworks Controller ULCD/Scoreboard Controller Bezel B.SLDPRT

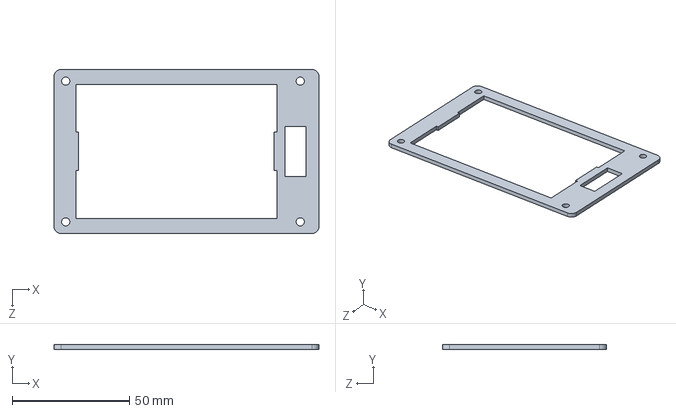
[picture p45: CAD file, 2017-08-02]
Design/Solidworks Controller ULCD/Scoreboard Controller Bezel B.SLDPRT
113.0 x 2.00 x 70.0 mm
