dhskinner/Scoreboard/Design/Solidworks Mini Timer/Scoreboard Timer Frame Front IISLDPRT.SLDPRT

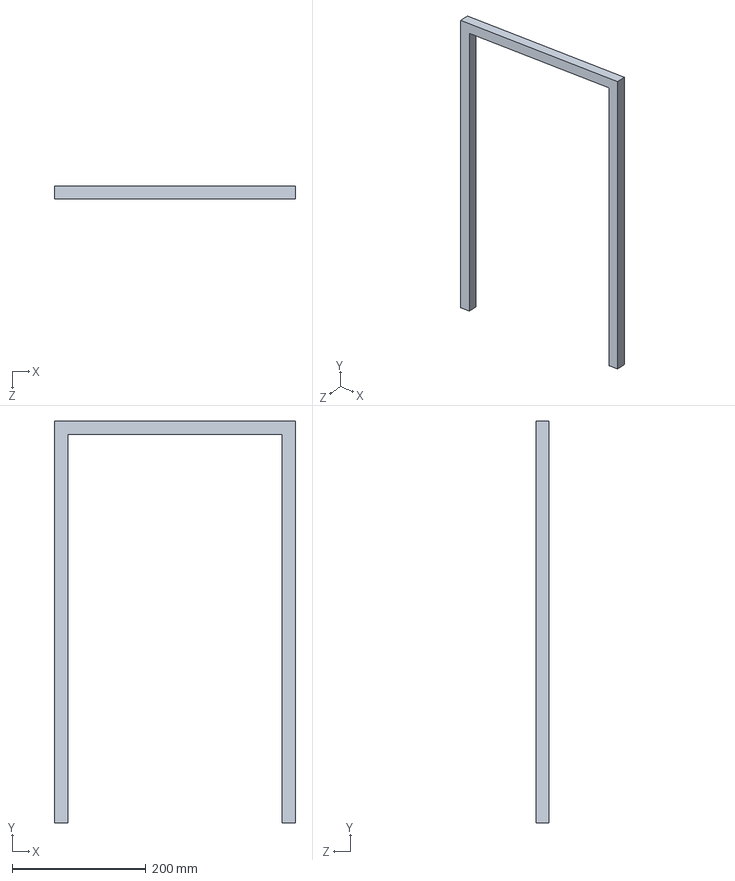
[picture p46: CAD file, 2017-08-02]
Design/Solidworks Mini Timer/Scoreboard Timer Frame Front IISLDPRT.SLDPRT
360.0 x 600.0 x 20.0 mm
