dhskinner/Scoreboard/Design/Solidworks Scoreboard/Processor - Shield GBare.sldprt

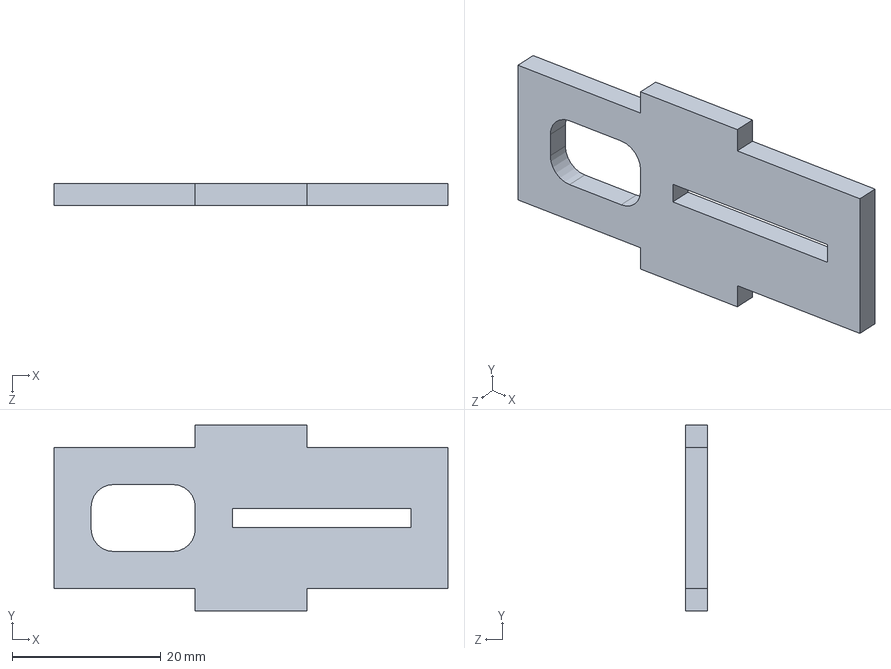
[picture p47: CAD file, 2017-08-02]
Design/Solidworks Scoreboard/Processor - Shield GBare.sldprt
53.0 x 25.0 x 3.00 mm
