dhskinner/Scoreboard/Design/Solidworks Controller ULCD/Scoreboard Controller Base Bezel A.sldprt

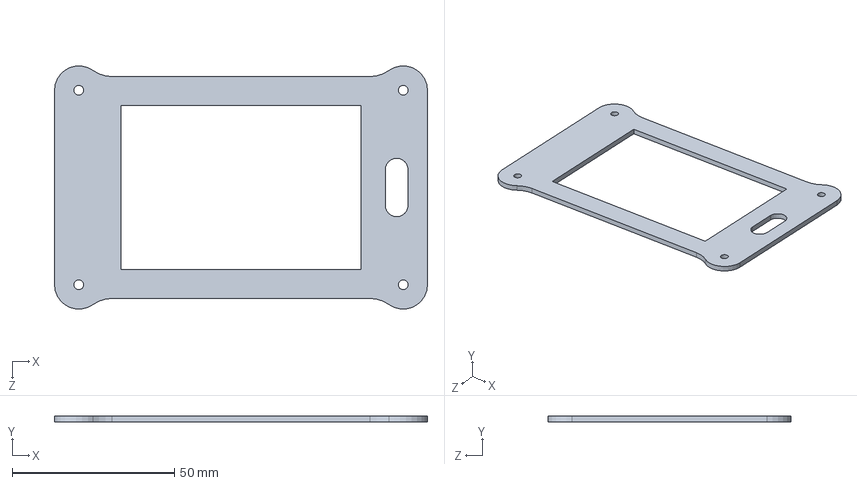
[picture p48: CAD file, 2017-08-02]
Design/Solidworks Controller ULCD/Scoreboard Controller Base Bezel A.sldprt
115.0 x 2.00 x 74.9 mm
