dhskinner/Scoreboard/Design/Solidworks Controller WIFI/SMA Antenna Dipole.SLDPRT

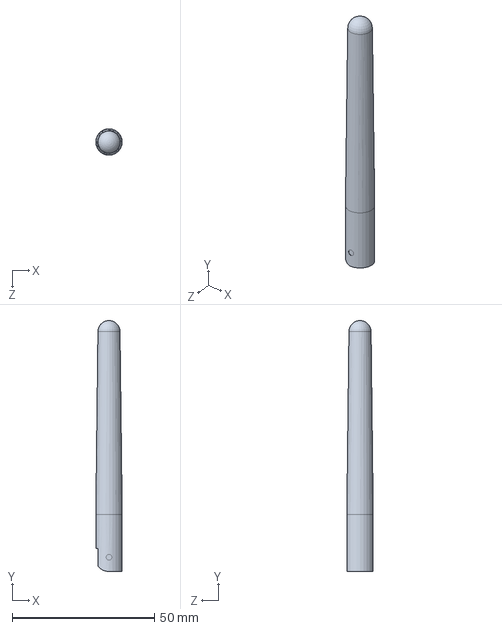
[picture p49: CAD file, 2020-08-17]
Design/Solidworks Controller WIFI/SMA Antenna Dipole.SLDPRT
9.30 x 88.2 x 9.30 mm
