dhskinner/Scoreboard/Design/Solidworks Controller ULCD/Bulgin Battery Holder.SLDPRT

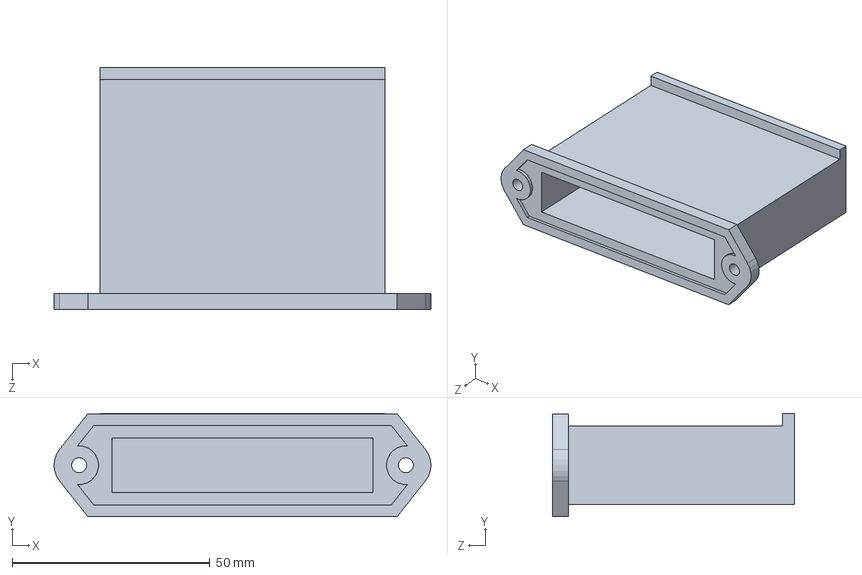
[picture p50: CAD file, 2017-08-02]
Design/Solidworks Controller ULCD/Bulgin Battery Holder.SLDPRT
95.3 x 26.1 x 61.2 mm
