dhskinner/Scoreboard/Design/Solidworks Mini Timer/Scoreboard Tomer Cover.SLDPRT

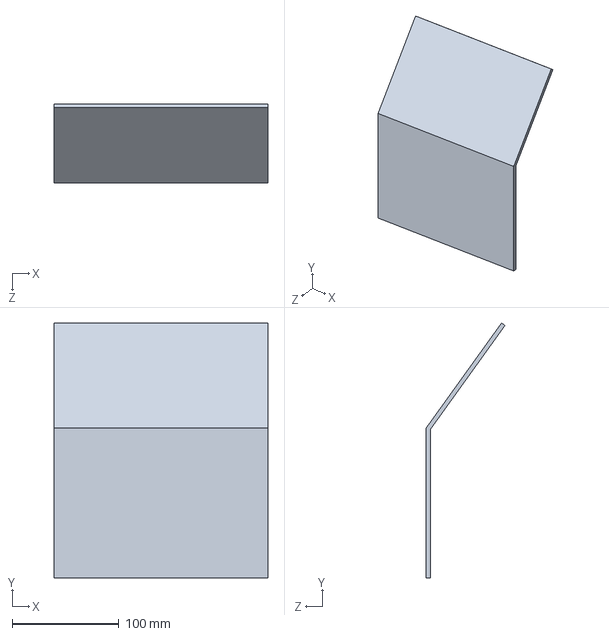
[picture p51: CAD file, 2017-08-02]
Design/Solidworks Mini Timer/Scoreboard Tomer Cover.SLDPRT
200.0 x 238.8 x 74.0 mm
