dhskinner/Scoreboard/Design/Solidworks Scoreboard/Scoreboard - Trolley Signboard Frame - Back.SLDPRT

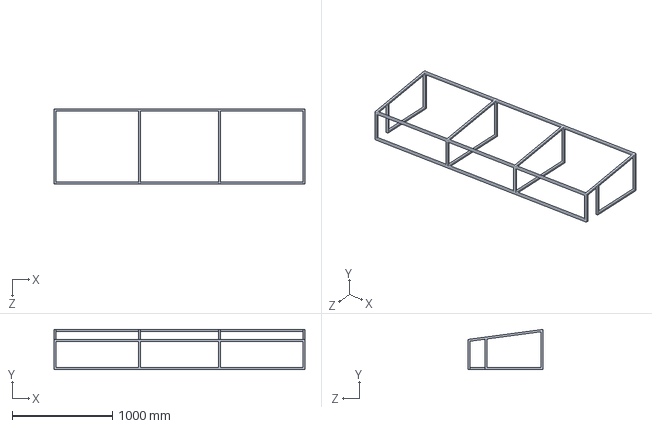
[picture p52: CAD file, 2017-08-02]
Design/Solidworks Scoreboard/Scoreboard - Trolley Signboard Frame - Back.SLDPRT
2500.0 x 400.0 x 750.0 mm
