dhskinner/Scoreboard/Design/Solidworks Controller ULCD/3xAA Battery Holder.SLDPRT

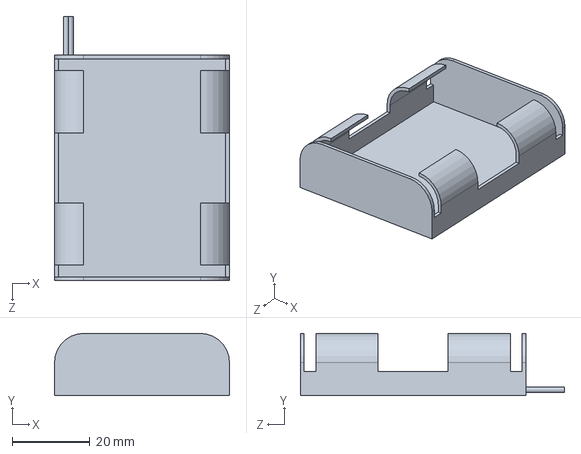
[picture p53: CAD file, 2017-08-02]
Design/Solidworks Controller ULCD/3xAA Battery Holder.SLDPRT
45.0 x 16.0 x 68.0 mm
