dhskinner/Scoreboard/Design/Solidworks Scoreboard/Processor - Shield DBare.sldprt

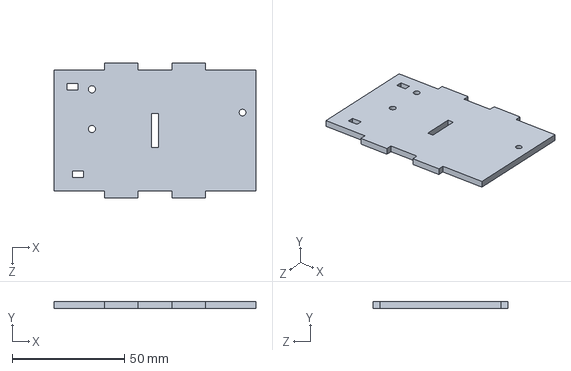
[picture p54: CAD file, 2017-08-02]
Design/Solidworks Scoreboard/Processor - Shield DBare.sldprt
90.0 x 3.00 x 60.0 mm
