dhskinner/Scoreboard/Design/Solidworks Mini Timer/Scoreboard Timer Back.SLDPRT

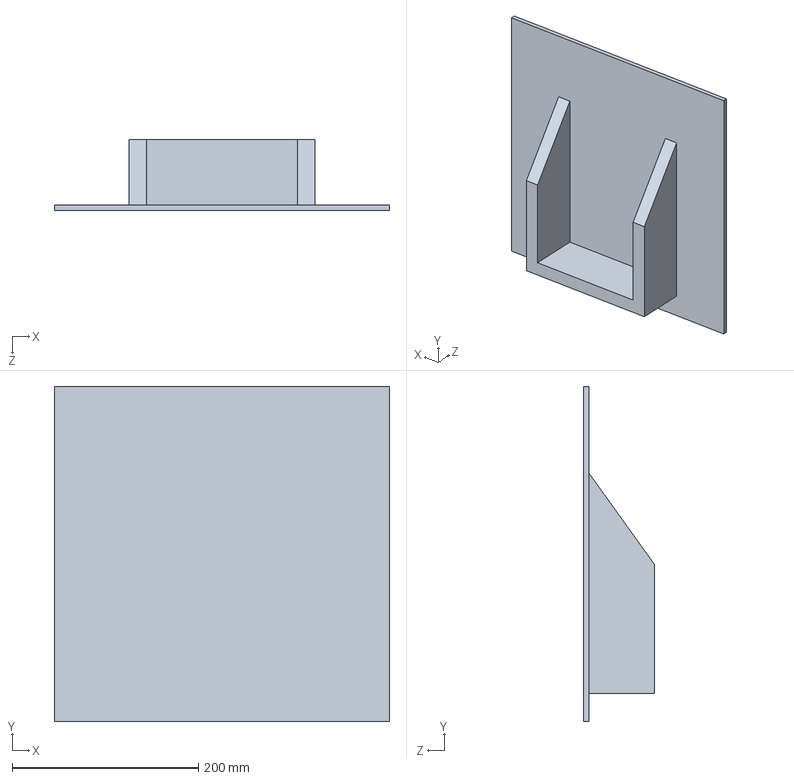
[picture p55: CAD file, 2017-08-02]
Design/Solidworks Mini Timer/Scoreboard Timer Back.SLDPRT
360.0 x 360.0 x 76.0 mm
