dhskinner/Scoreboard/Design/Solidworks Scoreboard/Hinge.SLDPRT

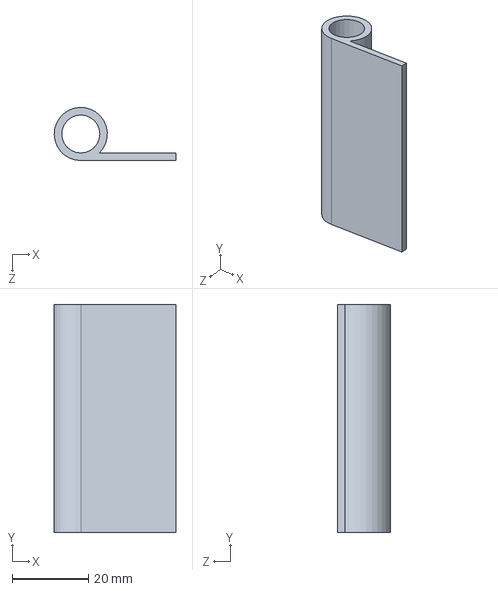
[picture p56: CAD file, 2017-08-02]
Design/Solidworks Scoreboard/Hinge.SLDPRT
32.0 x 60.0 x 14.0 mm
