dhskinner/Scoreboard/Design/Solidworks Controller ULCD/Top Face Bezel.sldprt

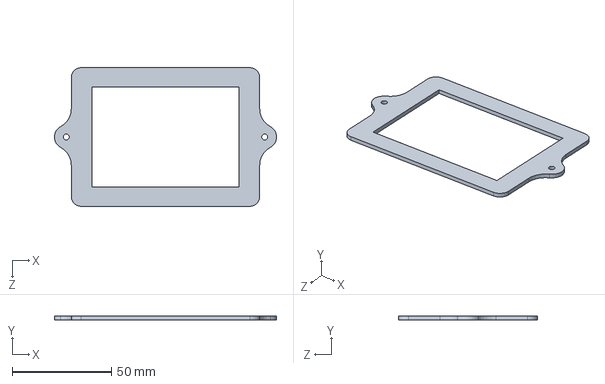
[picture p57: CAD file, 2017-08-02]
Design/Solidworks Controller ULCD/Top Face Bezel.sldprt
111.9 x 2.00 x 70.0 mm
