dhskinner/Scoreboard/Design/Solidworks Controller WIFI/Top.SLDPRT

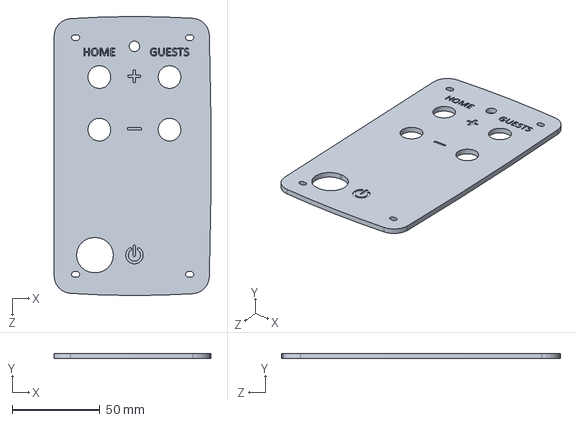
[picture p58: CAD file, 2020-08-17]
Design/Solidworks Controller WIFI/Top.SLDPRT
89.4 x 3.00 x 159.0 mm
