dhskinner/Scoreboard/Design/Solidworks Mini Timer/Timer Electronics.SLDPRT

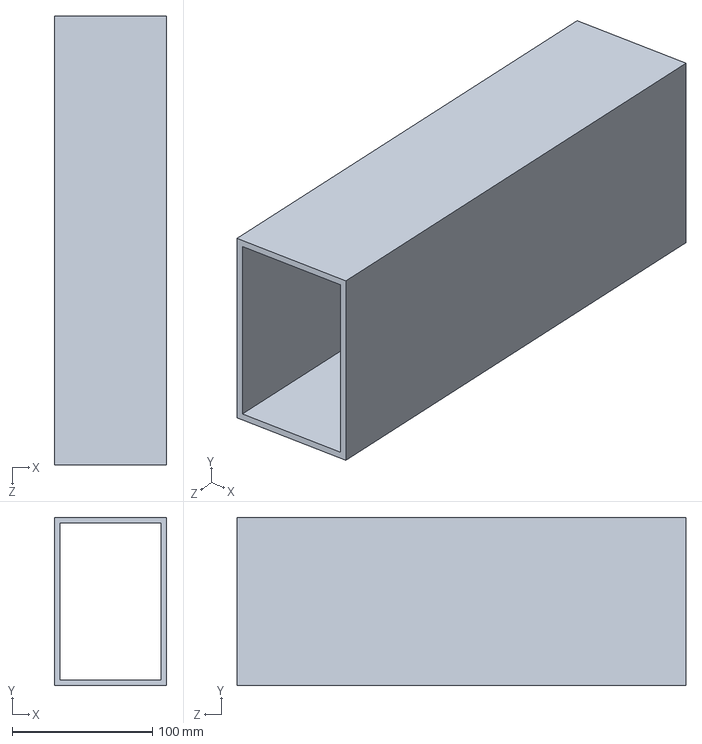
[picture p59: CAD file, 2017-08-02]
Design/Solidworks Mini Timer/Timer Electronics.SLDPRT
80.0 x 120.0 x 320.0 mm
