dhskinner/Scoreboard/Design/Solidworks Mini Timer/Scoreboard Timer Switch Plate.SLDPRT

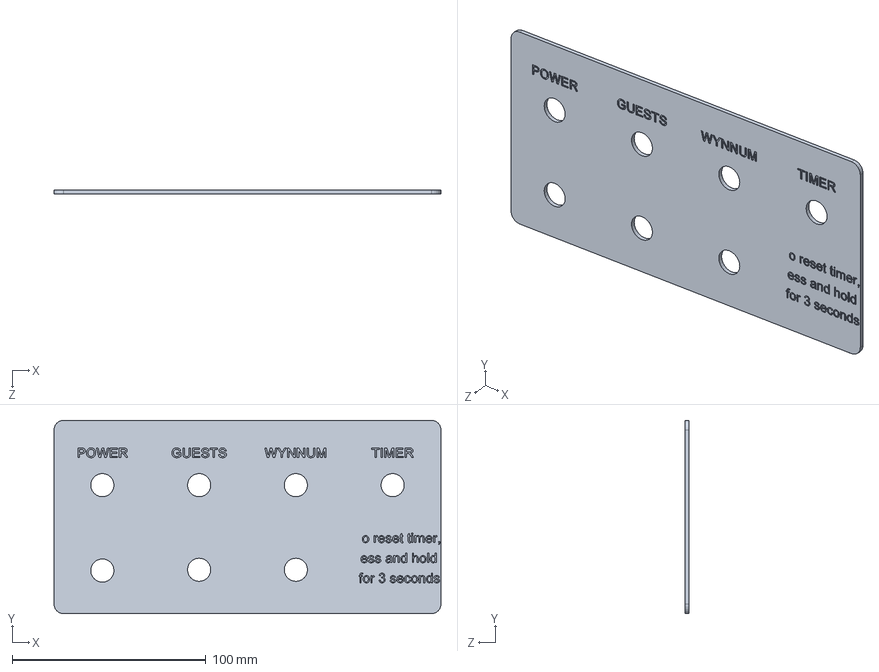
[picture p60: CAD file, 2017-08-02]
Design/Solidworks Mini Timer/Scoreboard Timer Switch Plate.SLDPRT
200.0 x 100.0 x 2.00 mm
