dhskinner/Scoreboard/Design/Solidworks Scoreboard/Signboard - Back Hatch.sldprt

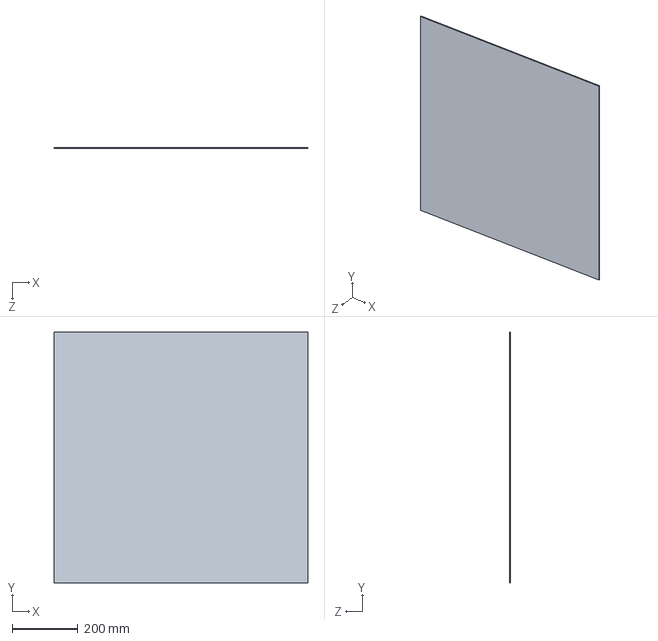
[picture p61: CAD file, 2017-08-02]
Design/Solidworks Scoreboard/Signboard - Back Hatch.sldprt
770.0 x 760.0 x 4.00 mm
