dhskinner/Scoreboard/Design/Solidworks Controller ULCD/Scoreboard Controller Base B.SLDPRT

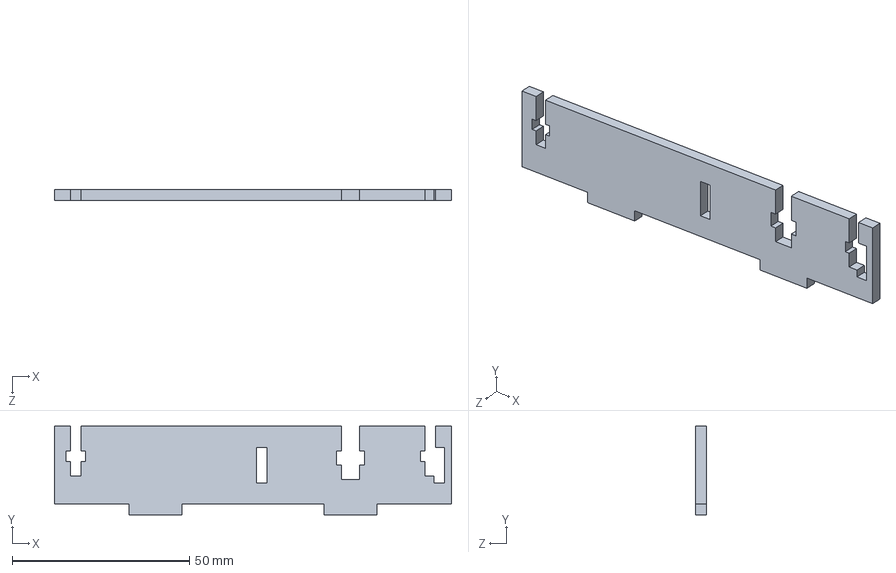
[picture p62: CAD file, 2017-08-02]
Design/Solidworks Controller ULCD/Scoreboard Controller Base B.SLDPRT
112.0 x 25.0 x 3.00 mm
