dhskinner/Scoreboard/Design/Solidworks Controller WIFI/New Scoreboard PCB V2.SLDPRT

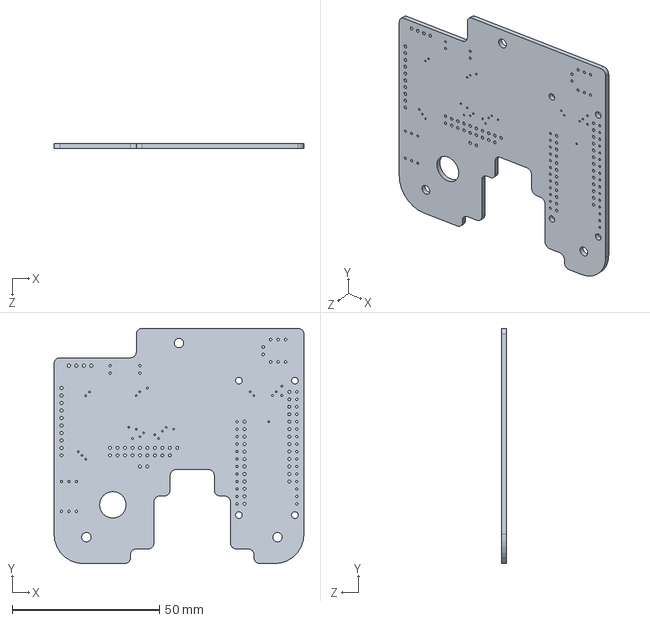
[picture p63: CAD file, 2020-08-17]
Design/Solidworks Controller WIFI/New Scoreboard PCB V2.SLDPRT
85.0 x 80.0 x 1.60 mm
