dhskinner/Scoreboard/Design/Solidworks Mini Timer/Scoreboard Timer Back 2.SLDPRT

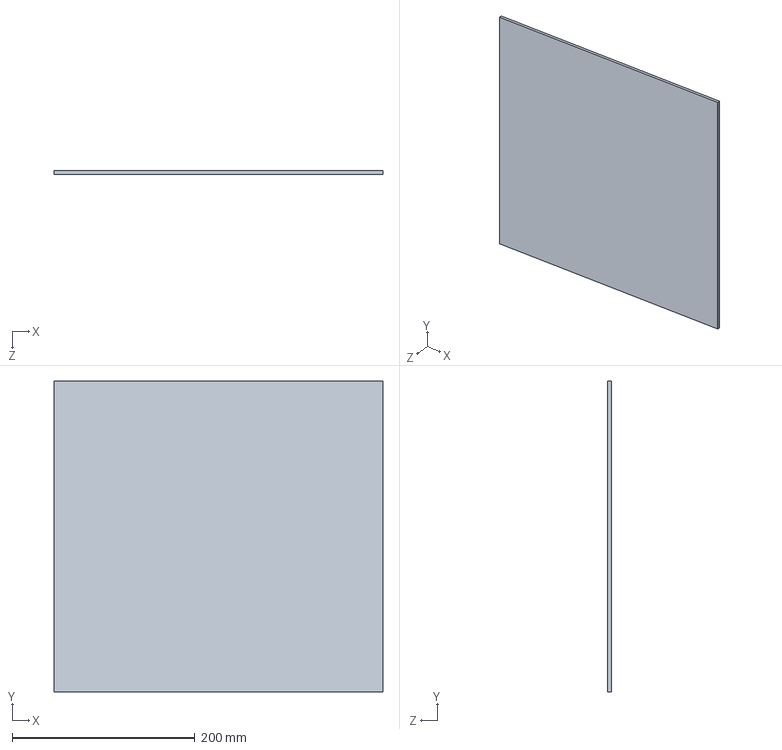
[picture p64: CAD file, 2017-08-02]
Design/Solidworks Mini Timer/Scoreboard Timer Back 2.SLDPRT
360.0 x 340.0 x 4.00 mm
