dhskinner/Scoreboard/Design/Solidworks Scoreboard/Processor - Shield HBare.sldprt

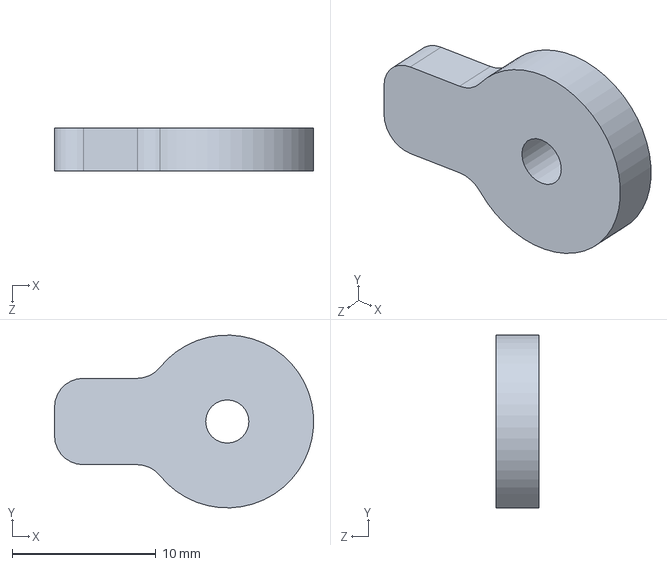
[picture p65: CAD file, 2017-08-02]
Design/Solidworks Scoreboard/Processor - Shield HBare.sldprt
18.0 x 12.0 x 3.00 mm
