dhskinner/Scoreboard/Design/Solidworks Controller ULCD/Rib.SLDPRT

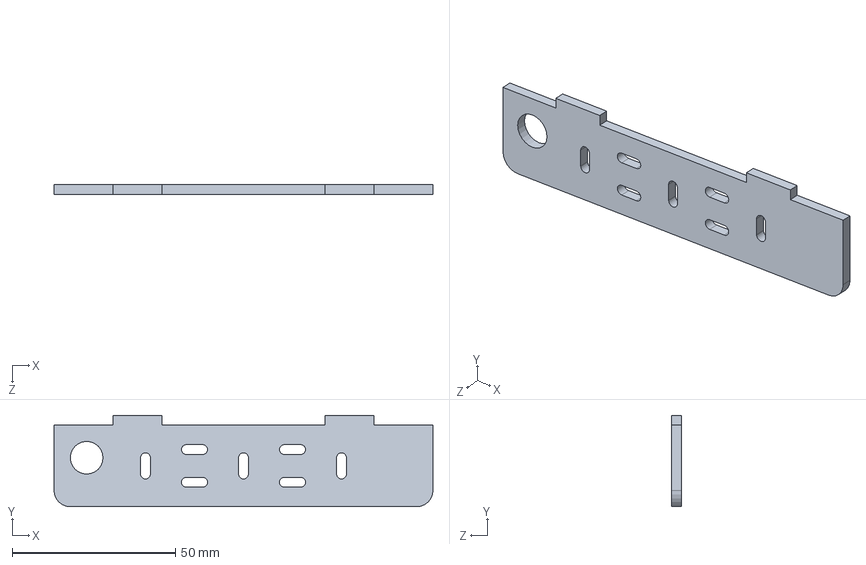
[picture p66: CAD file, 2017-08-02]
Design/Solidworks Controller ULCD/Rib.SLDPRT
116.0 x 28.0 x 3.00 mm
