dhskinner/Scoreboard/Design/Solidworks Mini Timer/Scoreboard Timer Frame Back 2.SLDPRT

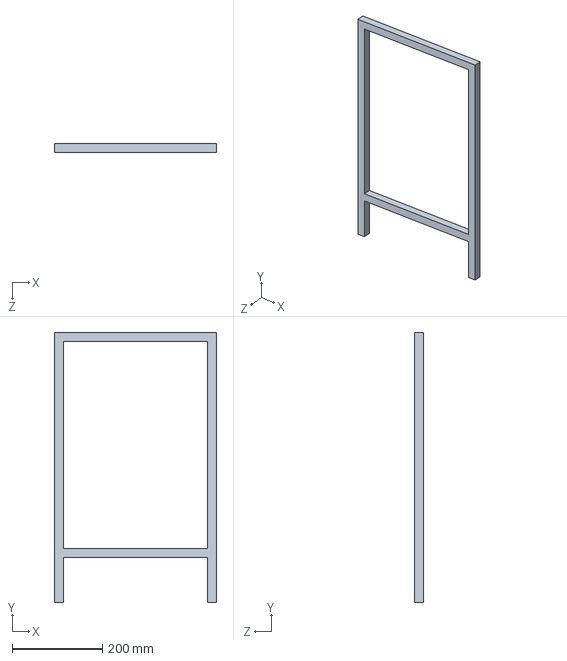
[picture p67: CAD file, 2017-08-02]
Design/Solidworks Mini Timer/Scoreboard Timer Frame Back 2.SLDPRT
360.0 x 600.0 x 20.0 mm
