dhskinner/Scoreboard/Design/Solidworks Controller WIFI/NRF24L01.SLDPRT

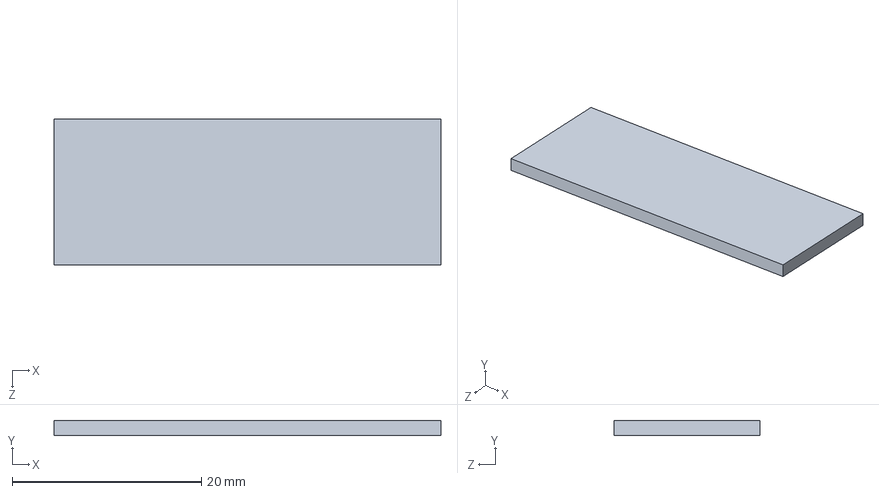
[picture p68: CAD file, 2020-08-17]
Design/Solidworks Controller WIFI/NRF24L01.SLDPRT
40.9 x 1.60 x 15.4 mm
