dhskinner/Scoreboard/Design/Solidworks Scoreboard/Signboard - Back.SLDPRT

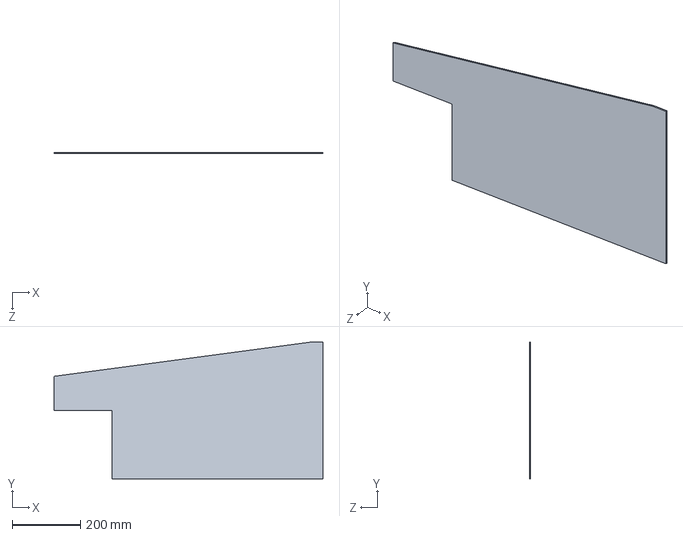
[picture p69: CAD file, 2017-08-02]
Design/Solidworks Scoreboard/Signboard - Back.SLDPRT
787.5 x 400.0 x 4.00 mm
