dhskinner/Scoreboard/Design/Solidworks Controller ULCD/Keeper.SLDPRT

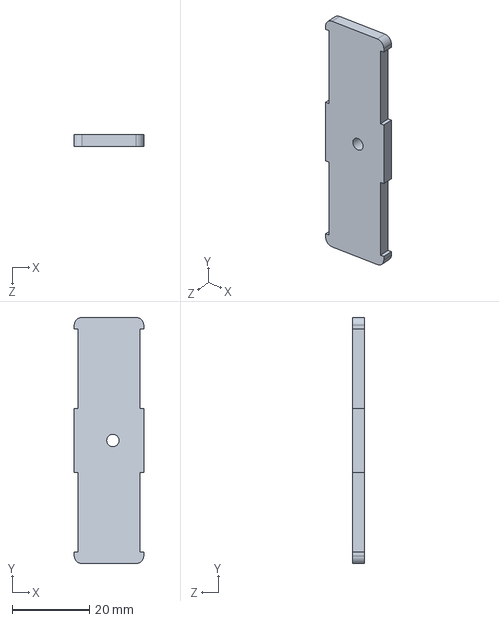
[picture p70: CAD file, 2017-08-02]
Design/Solidworks Controller ULCD/Keeper.SLDPRT
18.0 x 63.5 x 3.00 mm
