dhskinner/Scoreboard/Design/Solidworks Controller WIFI/Lipo 1000mAh Battery.SLDPRT

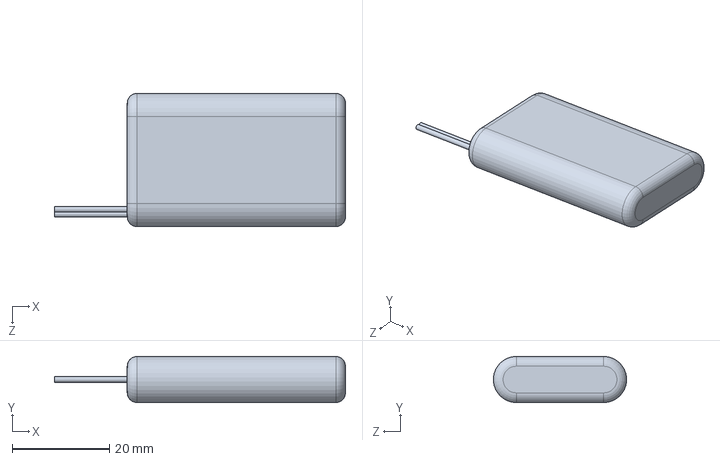
[picture p71: CAD file, 2020-08-17]
Design/Solidworks Controller WIFI/Lipo 1000mAh Battery.SLDPRT
60.0 x 9.50 x 27.5 mm
