dhskinner/Scoreboard/Design/Solidworks Controller ULCD/Scoreboard Controller Base C.SLDPRT

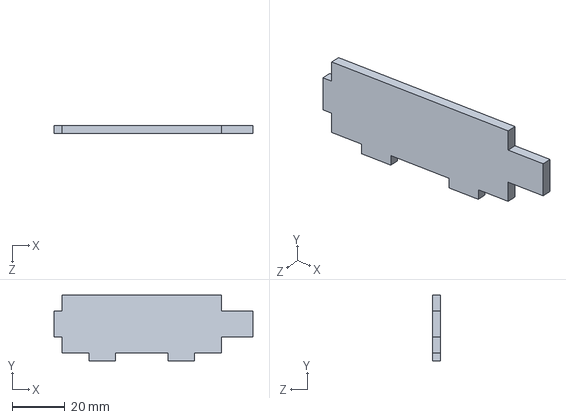
[picture p72: CAD file, 2017-08-02]
Design/Solidworks Controller ULCD/Scoreboard Controller Base C.SLDPRT
75.5 x 25.0 x 3.00 mm
