dhskinner/Scoreboard/Design/Solidworks Scoreboard/Freetronics DMD.SLDPRT

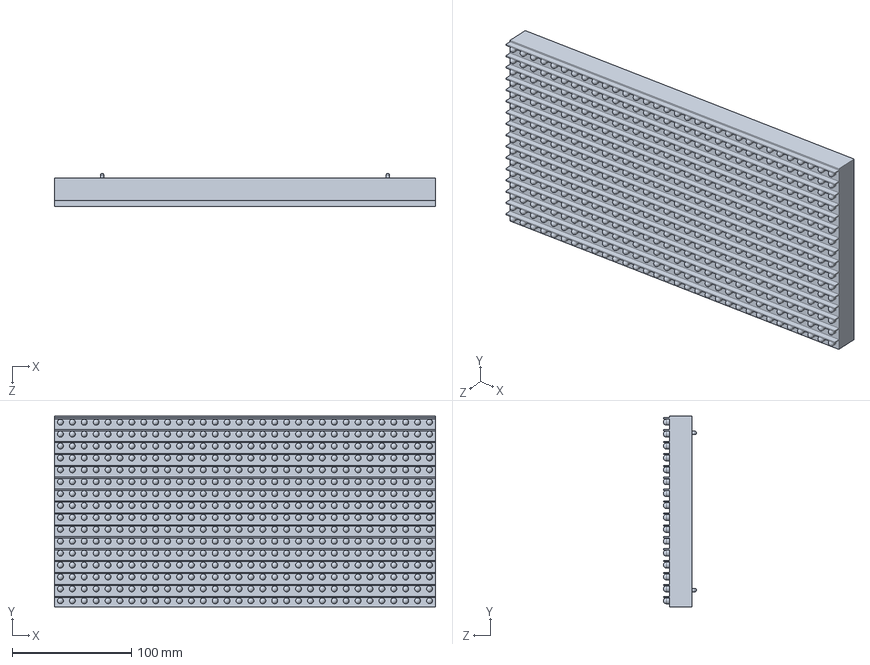
[picture p73: CAD file, 2017-08-02]
Design/Solidworks Scoreboard/Freetronics DMD.SLDPRT
320.0 x 160.0 x 28.0 mm
