dhskinner/Scoreboard/Design/Solidworks Scoreboard/Power Supply - Shield J.sldprt

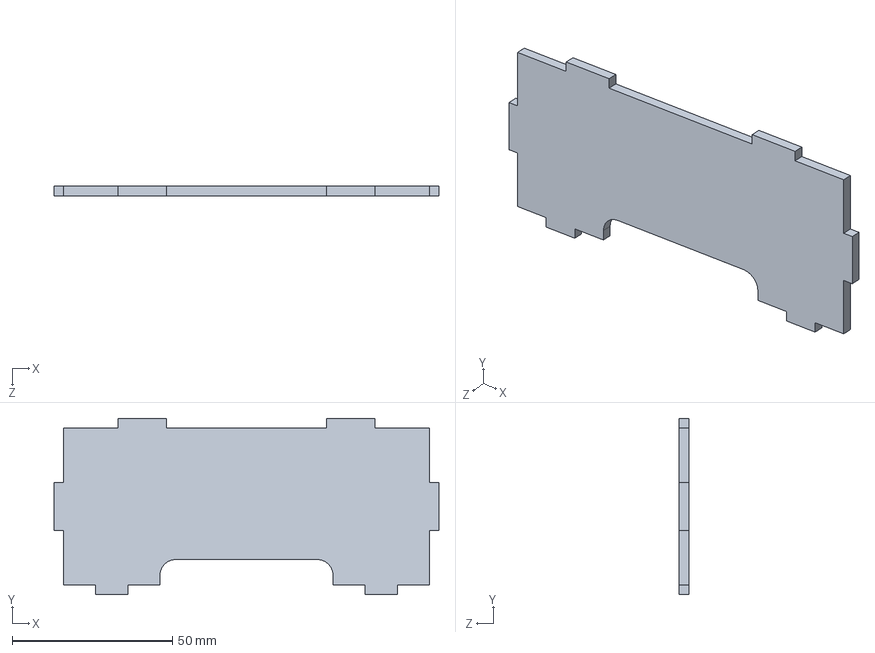
[picture p74: CAD file, 2017-08-02]
Design/Solidworks Scoreboard/Power Supply - Shield J.sldprt
120.0 x 55.0 x 3.00 mm
