dhskinner/Scoreboard/Design/Solidworks Controller ULCD/LIPO Fuel Gauge.SLDPRT

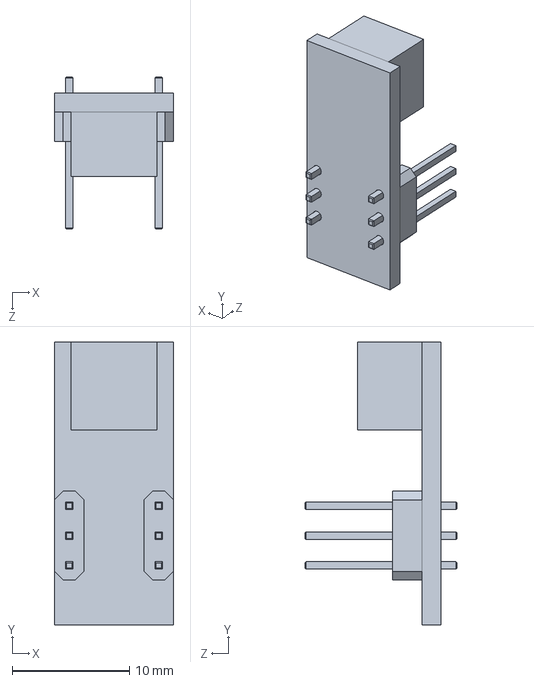
[picture p75: CAD file, 2017-08-02]
Design/Solidworks Controller ULCD/LIPO Fuel Gauge.SLDPRT
10.2 x 24.1 x 13.0 mm
