dhskinner/Scoreboard/Design/Solidworks Scoreboard/Processor - Shield BBare.sldprt

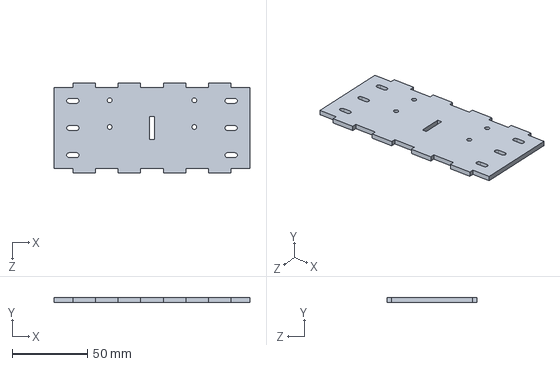
[picture p76: CAD file, 2017-08-02]
Design/Solidworks Scoreboard/Processor - Shield BBare.sldprt
130.0 x 3.00 x 60.0 mm
