dhskinner/Scoreboard/Design/Solidworks Controller ULCD/Scoreboard Controller Base A.SLDPRT

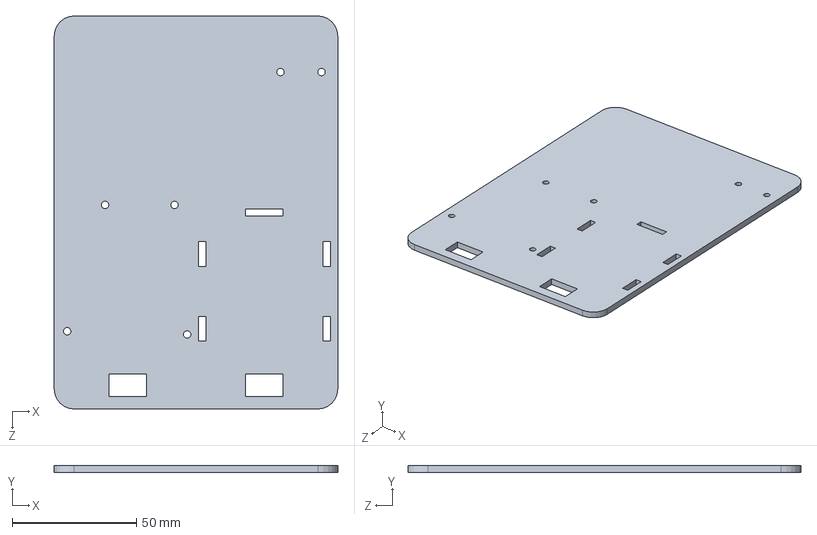
[picture p77: CAD file, 2017-08-02]
Design/Solidworks Controller ULCD/Scoreboard Controller Base A.SLDPRT
114.0 x 3.00 x 158.0 mm
