dhskinner/Scoreboard/Design/Solidworks Controller WIFI/pin header double row- 20 contacts.SLDPRT

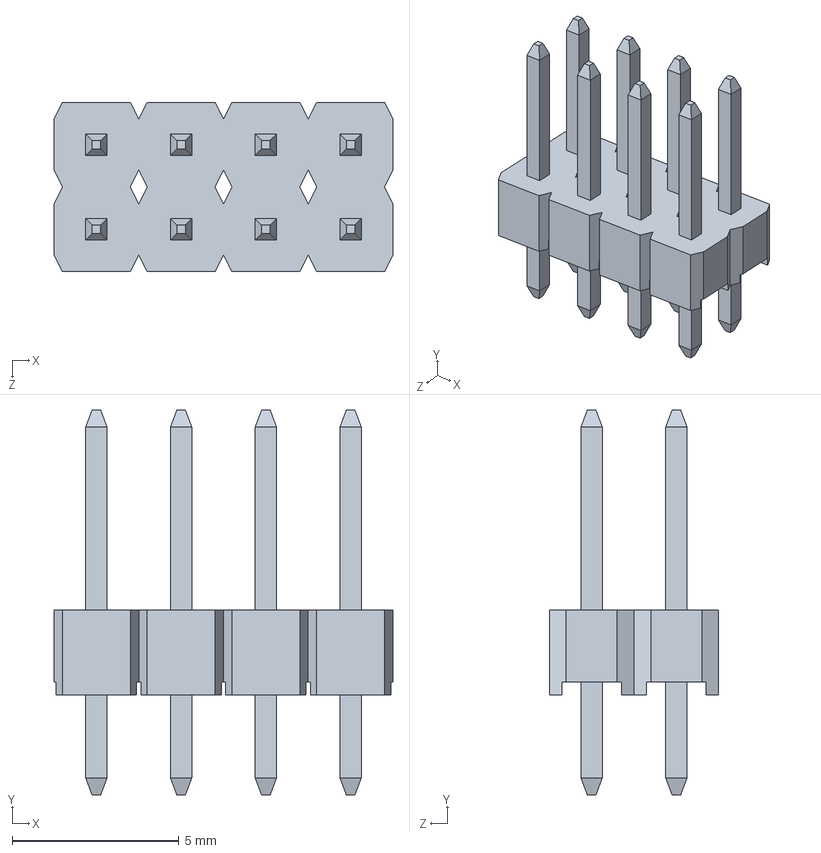
[picture p78: CAD file, 2020-08-17]
Design/Solidworks Controller WIFI/pin header double row- 20 contacts.SLDPRT
10.2 x 11.5 x 5.08 mm
