dhskinner/Scoreboard/Design/Solidworks Scoreboard/Plywood - Back Storage.sldprt

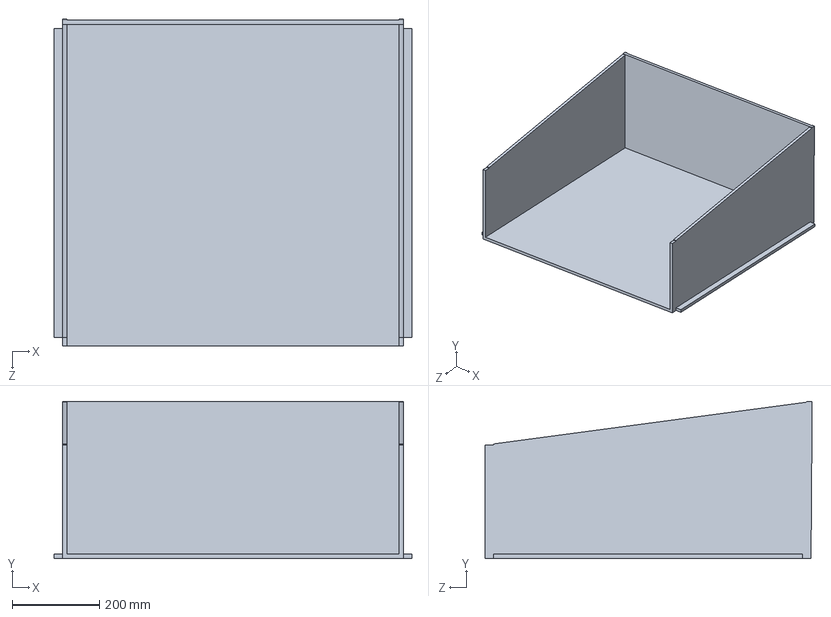
[picture p79: CAD file, 2017-08-02]
Design/Solidworks Scoreboard/Plywood - Back Storage.sldprt
820.0 x 359.8 x 750.0 mm
