dhskinner/Scoreboard/Design/Solidworks Controller WIFI/5mm LED GROMMIT.SLDPRT

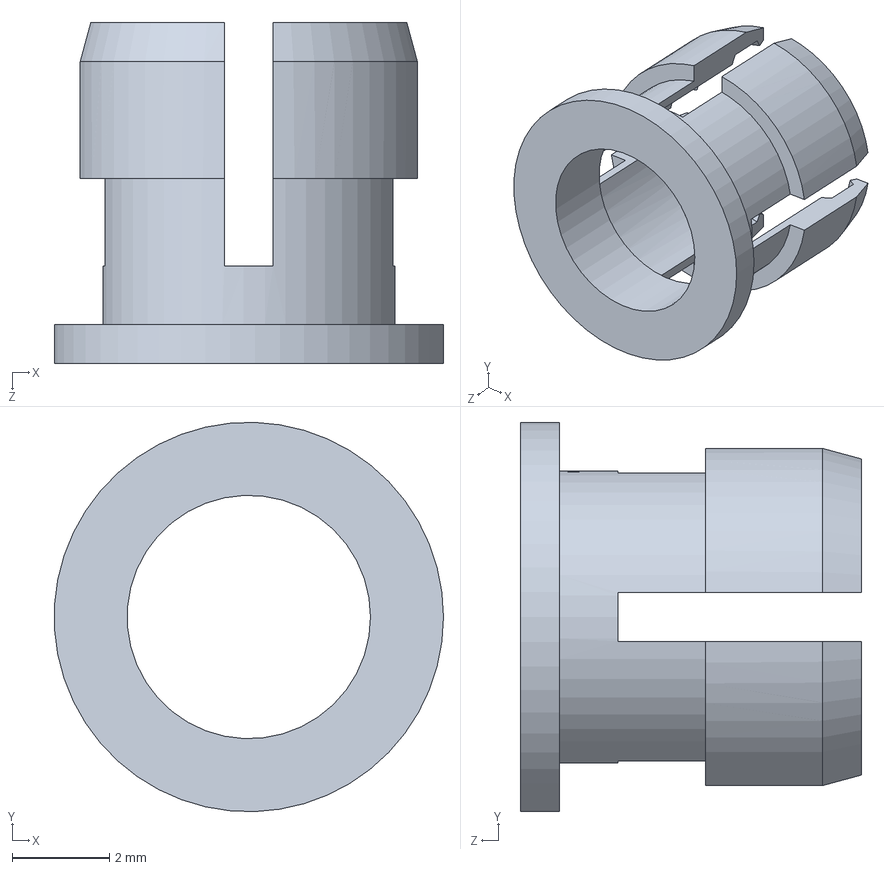
[picture p80: CAD file, 2020-08-17]
Design/Solidworks Controller WIFI/5mm LED GROMMIT.SLDPRT
7.99 x 8.00 x 7.00 mm
