dhskinner/Scoreboard/Design/Solidworks Scoreboard/Scoreboard - Frame.SLDPRT

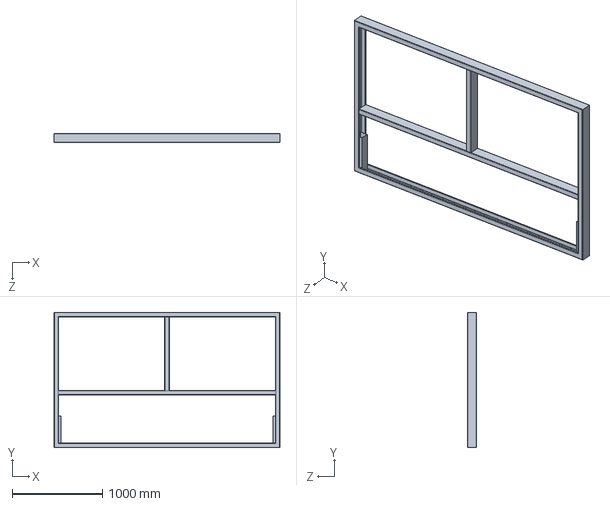
[picture p81: CAD file, 2017-08-02]
Design/Solidworks Scoreboard/Scoreboard - Frame.SLDPRT
2502.0 x 1500.0 x 102.0 mm
