dhskinner/Scoreboard/Design/Solidworks Controller WIFI/SMA-angled.SLDPRT

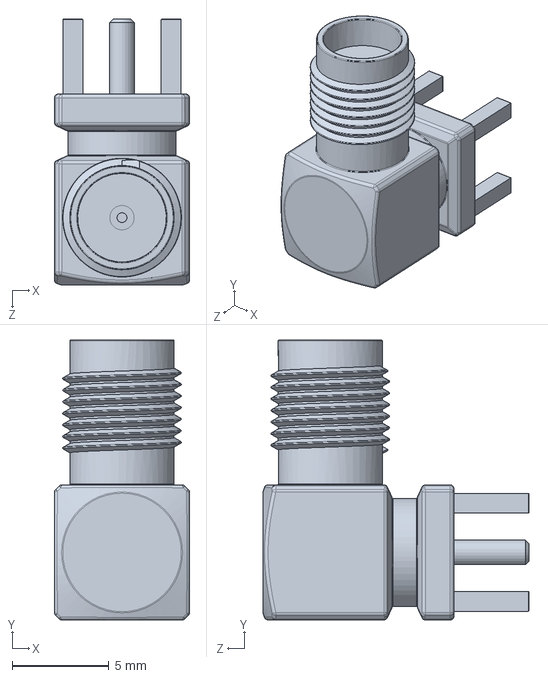
[picture p82: CAD file, 2020-08-17]
Design/Solidworks Controller WIFI/SMA-angled.SLDPRT
7.00 x 14.5 x 13.8 mm
