dhskinner/Scoreboard/Design/Solidworks Scoreboard/Signboard - Back Half.SLDPRT

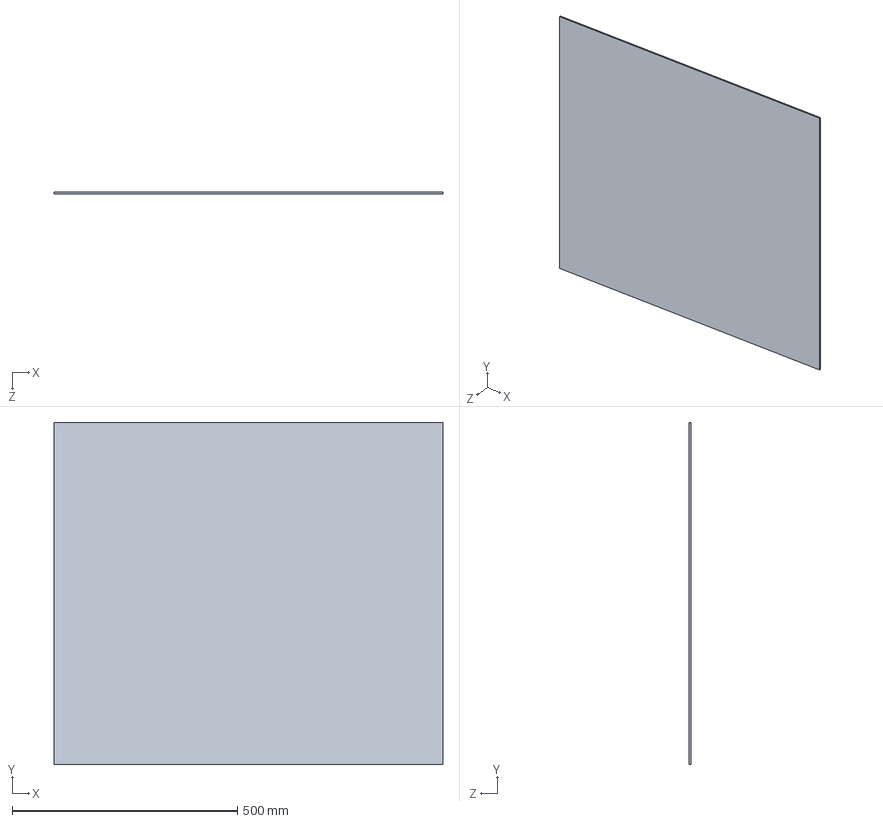
[picture p83: CAD file, 2017-08-02]
Design/Solidworks Scoreboard/Signboard - Back Half.SLDPRT
864.0 x 760.0 x 4.00 mm
