dhskinner/Scoreboard/Design/Solidworks Controller ULCD/8x2 Header Female.SLDPRT

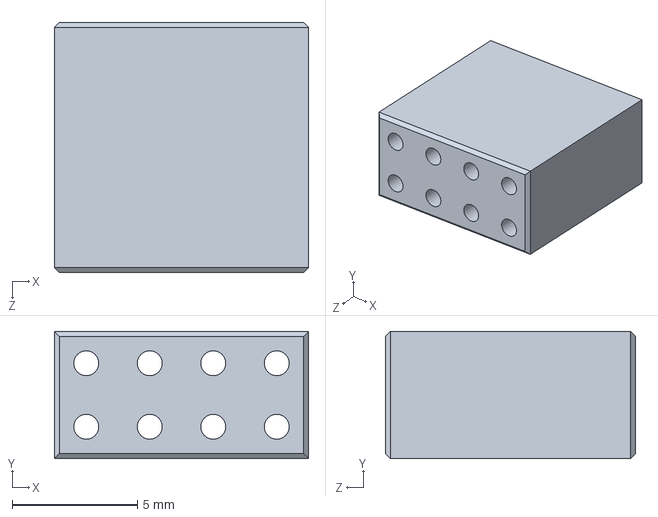
[picture p84: CAD file, 2017-08-02]
Design/Solidworks Controller ULCD/8x2 Header Female.SLDPRT
10.2 x 5.08 x 10.0 mm
