dhskinner/Scoreboard/Design/Solidworks Scoreboard/Scoreboard Axle - Front.SLDPRT

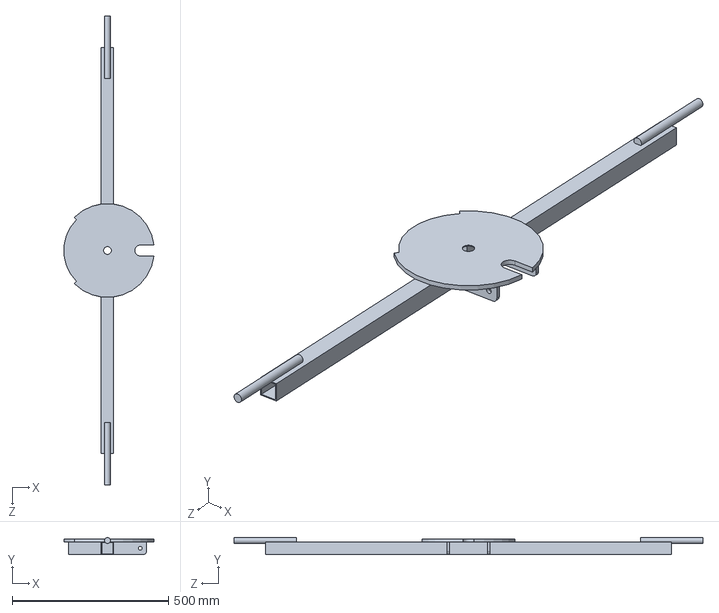
[picture p85: CAD file, 2017-08-02]
Design/Solidworks Scoreboard/Scoreboard Axle - Front.SLDPRT
288.1 x 54.5 x 1500.0 mm
