dhskinner/Scoreboard/Design/Solidworks Controller ULCD/Scoreboard Controller Base F.SLDPRT

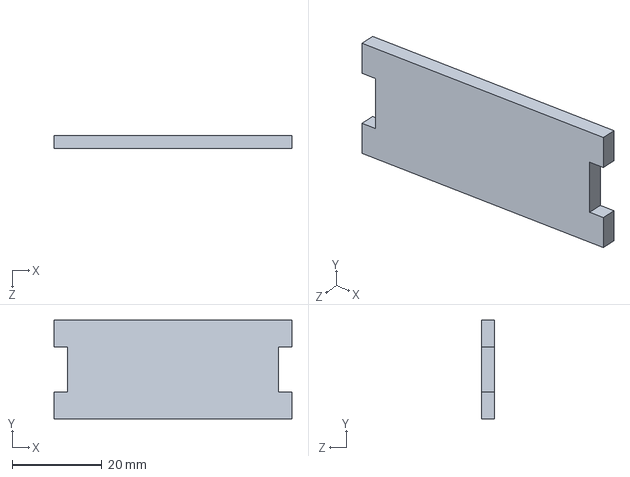
[picture p86: CAD file, 2017-08-02]
Design/Solidworks Controller ULCD/Scoreboard Controller Base F.SLDPRT
53.0 x 22.0 x 3.00 mm
