dhskinner/Scoreboard/Design/Solidworks Scoreboard/Power Supply - Shield I.sldprt

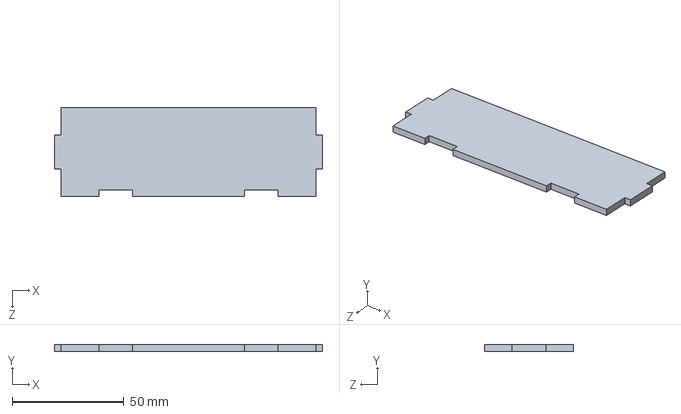
[picture p87: CAD file, 2017-08-02]
Design/Solidworks Scoreboard/Power Supply - Shield I.sldprt
120.0 x 3.00 x 40.0 mm
