dhskinner/Scoreboard/Design/Solidworks Controller ULCD/Scoreboard Controller Base Top Face.SLDPRT

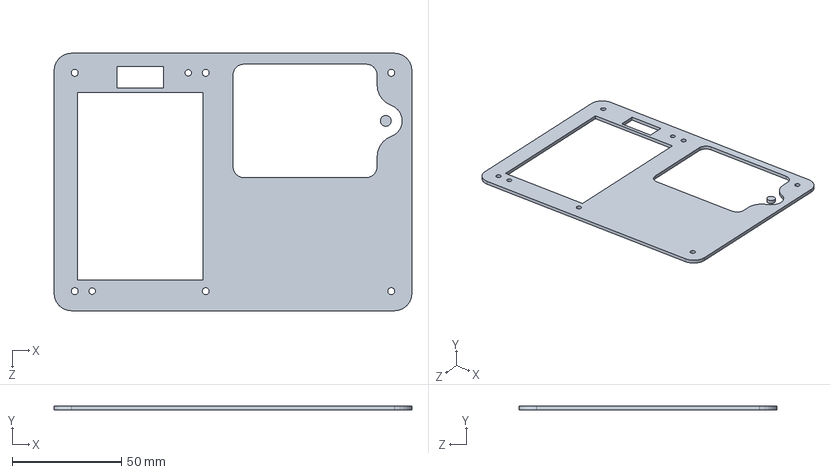
[picture p88: CAD file, 2017-08-02]
Design/Solidworks Controller ULCD/Scoreboard Controller Base Top Face.SLDPRT
164.0 x 2.00 x 118.0 mm
