dhskinner/Scoreboard/Design/Solidworks Scoreboard/Processor - Shield EBare.sldprt

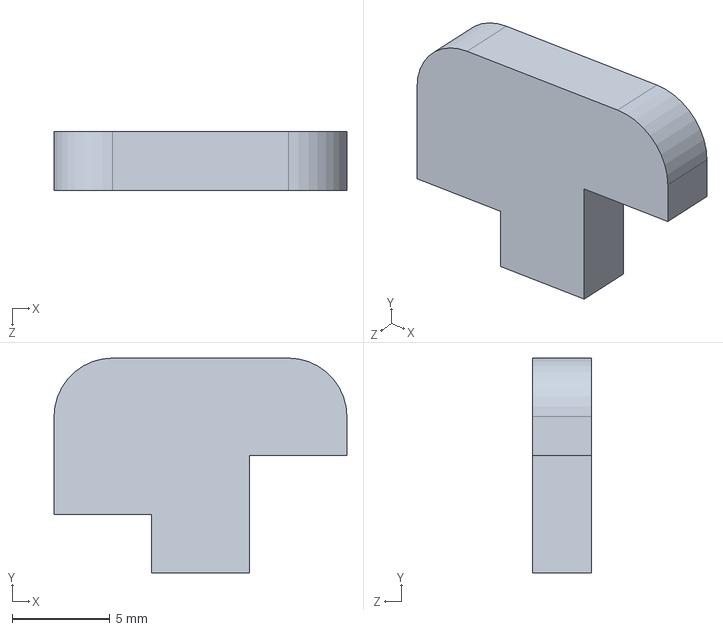
[picture p89: CAD file, 2017-08-02]
Design/Solidworks Scoreboard/Processor - Shield EBare.sldprt
15.0 x 11.0 x 3.00 mm
