dhskinner/Scoreboard/Design/Solidworks Controller ULCD/Scoreboard Controller Base 3D.SLDPRT

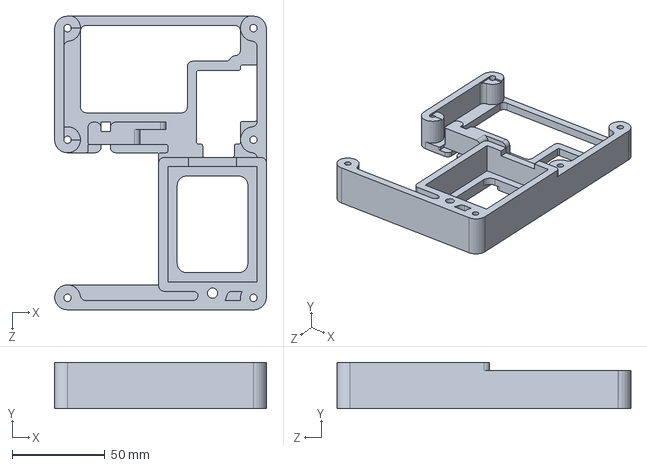
[picture p90: CAD file, 2017-08-02]
Design/Solidworks Controller ULCD/Scoreboard Controller Base 3D.SLDPRT
114.0 x 25.0 x 158.0 mm
