dhskinner/Scoreboard/Design/Solidworks Controller WIFI/SMA Antenna Base.SLDPRT

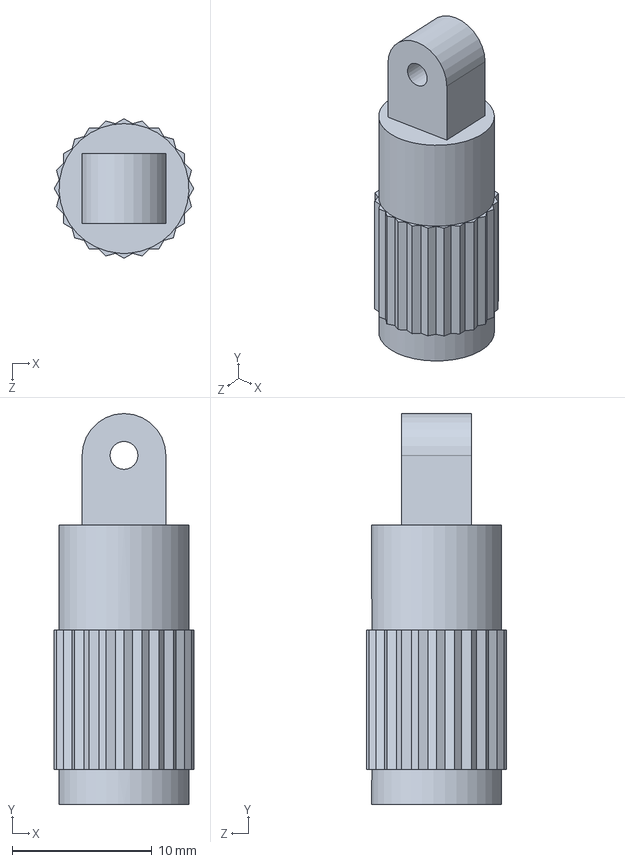
[picture p91: CAD file, 2020-08-17]
Design/Solidworks Controller WIFI/SMA Antenna Base.SLDPRT
10.0 x 28.0 x 10.0 mm
