dhskinner/Scoreboard/Design/Solidworks Controller WIFI/Button SPST Momentary IP67.SLDPRT

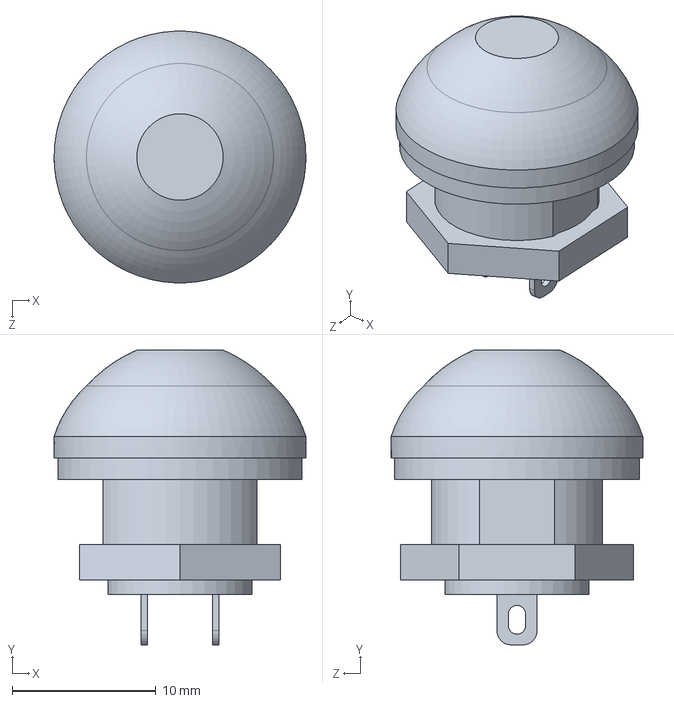
[picture p92: CAD file, 2020-08-17]
Design/Solidworks Controller WIFI/Button SPST Momentary IP67.SLDPRT
17.5 x 20.5 x 17.5 mm
