dhskinner/Scoreboard/Design/Solidworks Scoreboard/Scoreboard - Trolley Signboard Frame - Back Hatch.SLDPRT

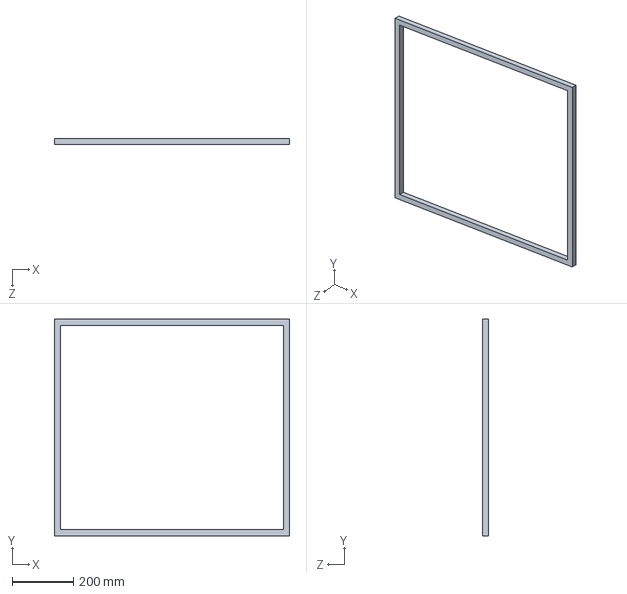
[picture p93: CAD file, 2017-08-02]
Design/Solidworks Scoreboard/Scoreboard - Trolley Signboard Frame - Back Hatch.SLDPRT
770.0 x 710.0 x 20.0 mm
