dhskinner/Scoreboard/Design/Solidworks Controller WIFI/PCF8754 I2C GPIO Short.SLDPRT

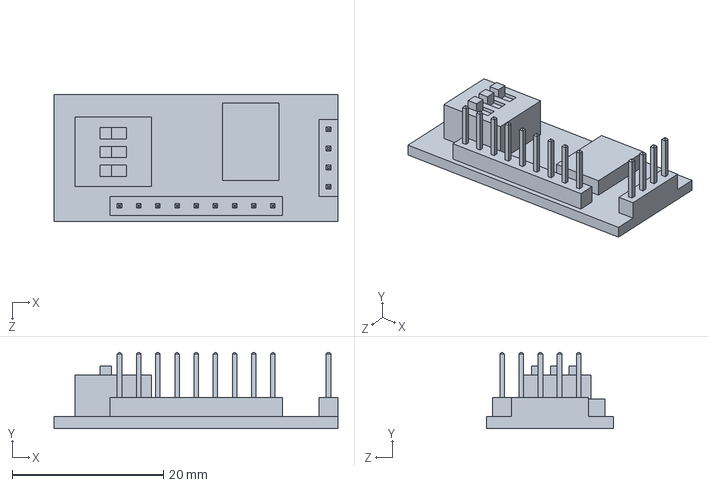
[picture p94: CAD file, 2020-08-17]
Design/Solidworks Controller WIFI/PCF8754 I2C GPIO Short.SLDPRT
37.6 x 10.1 x 16.8 mm
