dhskinner/Scoreboard/Design/Solidworks Scoreboard/Scoreboard - Trolley Handle.SLDPRT

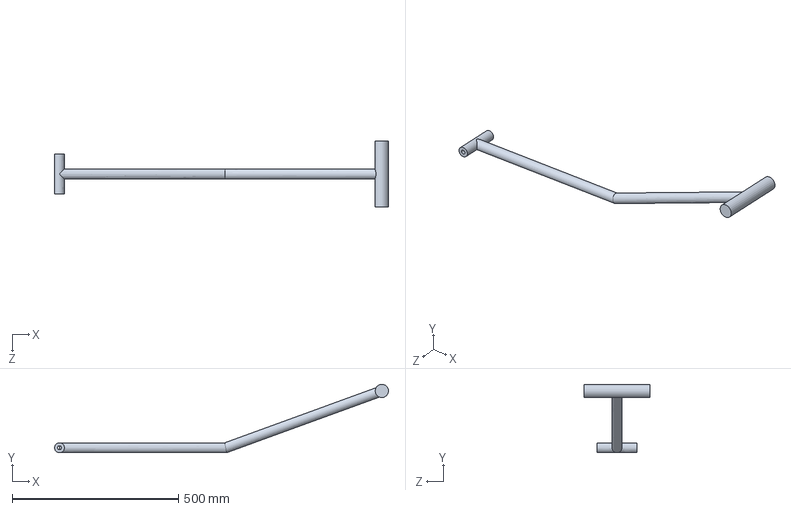
[picture p95: CAD file, 2017-08-02]
Design/Solidworks Scoreboard/Scoreboard - Trolley Handle.SLDPRT
1004.8 x 206.0 x 200.0 mm
