dhskinner/Scoreboard/Design/Solidworks Controller WIFI/Led.SLDPRT

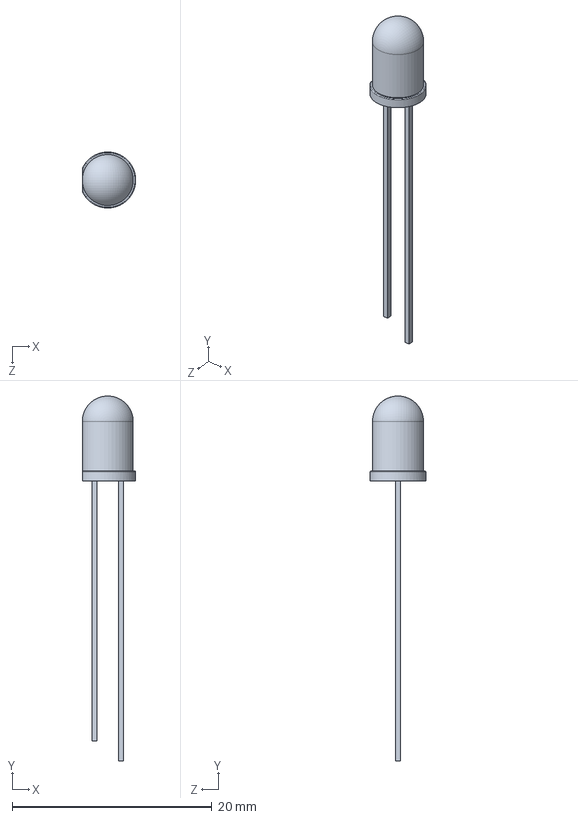
[picture p96: CAD file, 2020-08-17]
Design/Solidworks Controller WIFI/Led.SLDPRT
5.35 x 36.5 x 5.60 mm
