dhskinner/Scoreboard/Design/Solidworks Scoreboard/Power Supply 5V40A.SLDPRT

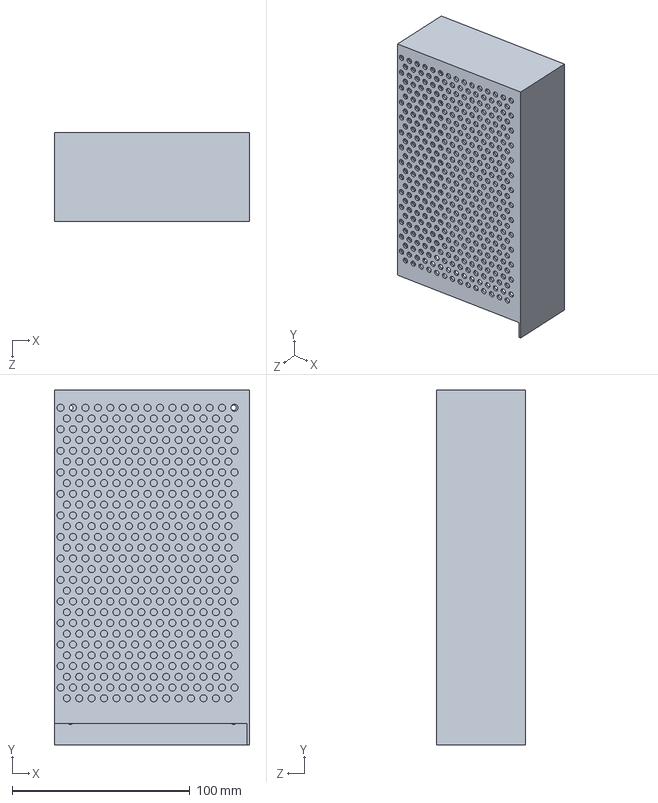
[picture p97: CAD file, 2017-08-02]
Design/Solidworks Scoreboard/Power Supply 5V40A.SLDPRT
110.0 x 200.0 x 50.0 mm
