dhskinner/Scoreboard/Design/Solidworks Scoreboard/Scoreboard 7 x 3 Frame.SLDPRT

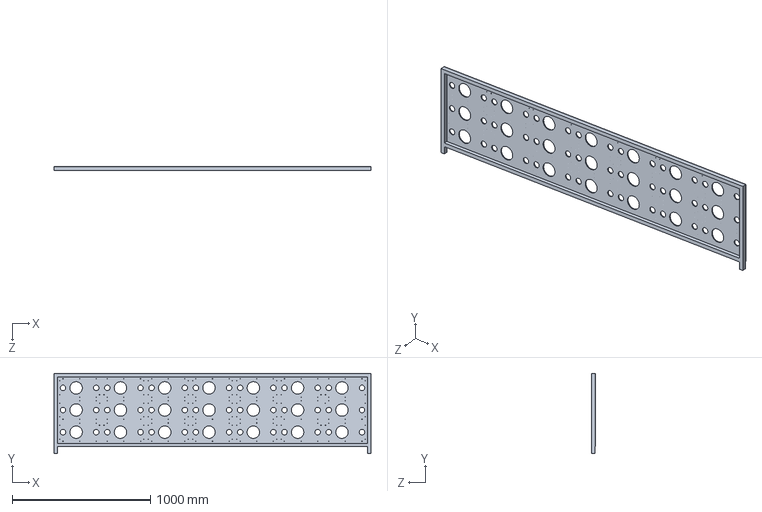
[picture p98: CAD file, 2017-08-02]
Design/Solidworks Scoreboard/Scoreboard 7 x 3 Frame.SLDPRT
2290.0 x 580.0 x 31.0 mm
