dhskinner/Scoreboard/Design/Solidworks Controller ULCD/Scoreboard Controller Base D.SLDPRT

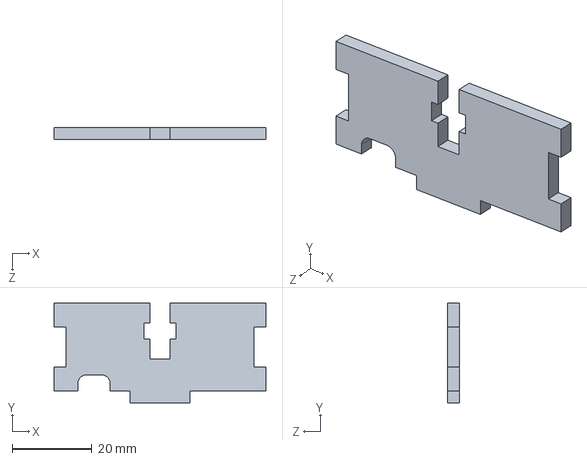
[picture p99: CAD file, 2017-08-02]
Design/Solidworks Controller ULCD/Scoreboard Controller Base D.SLDPRT
53.0 x 25.0 x 3.00 mm
