dhskinner/Scoreboard/Design/Solidworks Scoreboard/Scoreboard - Door Frame.SLDPRT

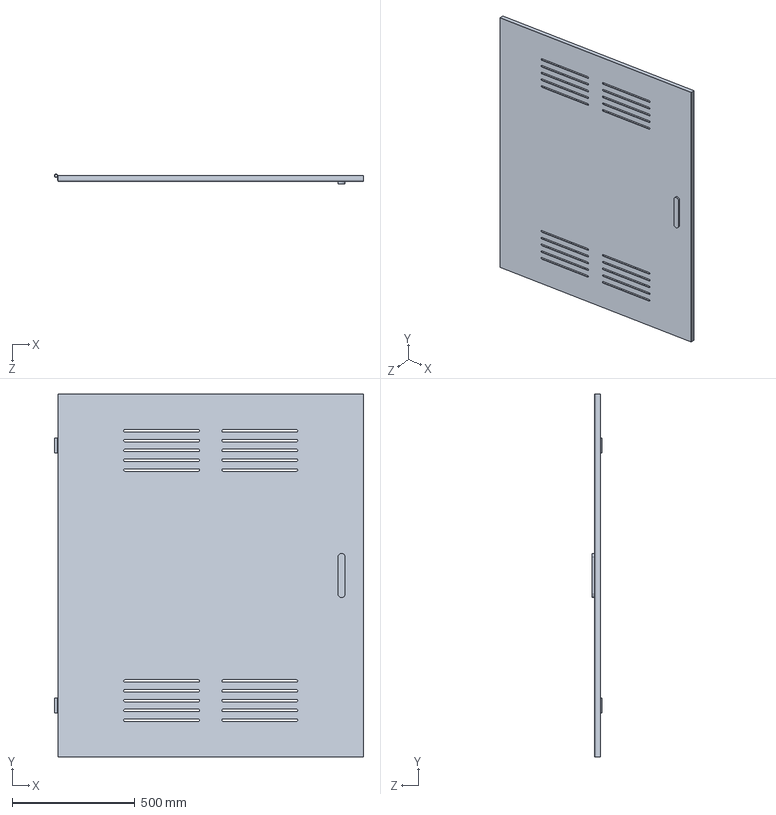
[picture p100: CAD file, 2017-08-02]
Design/Solidworks Scoreboard/Scoreboard - Door Frame.SLDPRT
1261.0 x 1480.0 x 41.0 mm
