dhskinner/Scoreboard/Design/Solidworks Controller ULCD/Scoreboard Controller Base E.SLDPRT

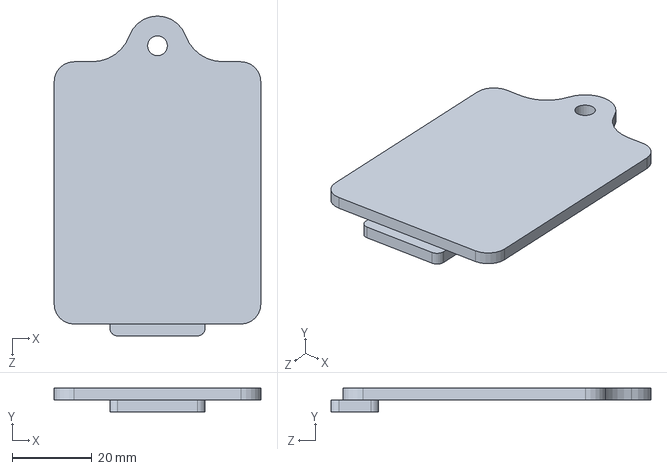
[picture p101: CAD file, 2017-08-02]
Design/Solidworks Controller ULCD/Scoreboard Controller Base E.SLDPRT
52.0 x 6.00 x 80.5 mm
