dhskinner/Scoreboard/Design/Solidworks Scoreboard/Scoreboard - Trolley Steering Tang.SLDPRT

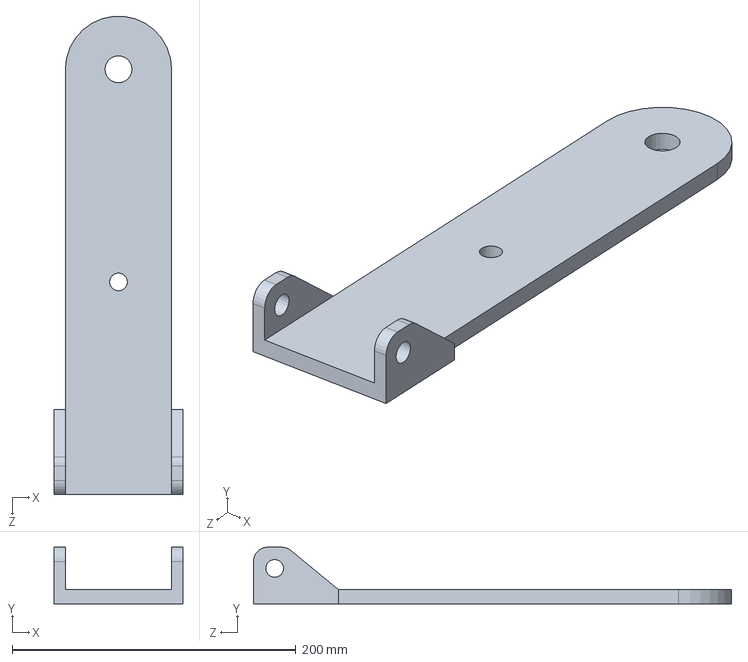
[picture p102: CAD file, 2017-08-02]
Design/Solidworks Scoreboard/Scoreboard - Trolley Steering Tang.SLDPRT
91.0 x 40.0 x 337.3 mm
