dhskinner/Scoreboard/Design/Solidworks Controller ULCD/Stringer.SLDPRT

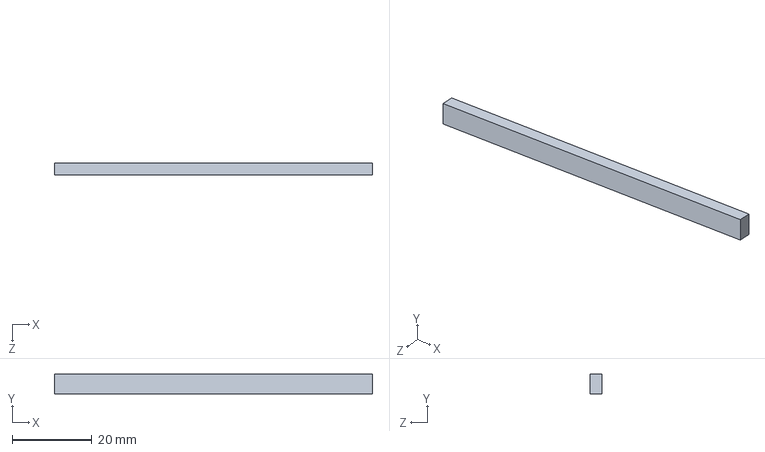
[picture p103: CAD file, 2017-08-02]
Design/Solidworks Controller ULCD/Stringer.SLDPRT
80.0 x 5.00 x 3.00 mm
