dhskinner/Scoreboard/Design/Solidworks Controller WIFI/SMA male.SLDPRT

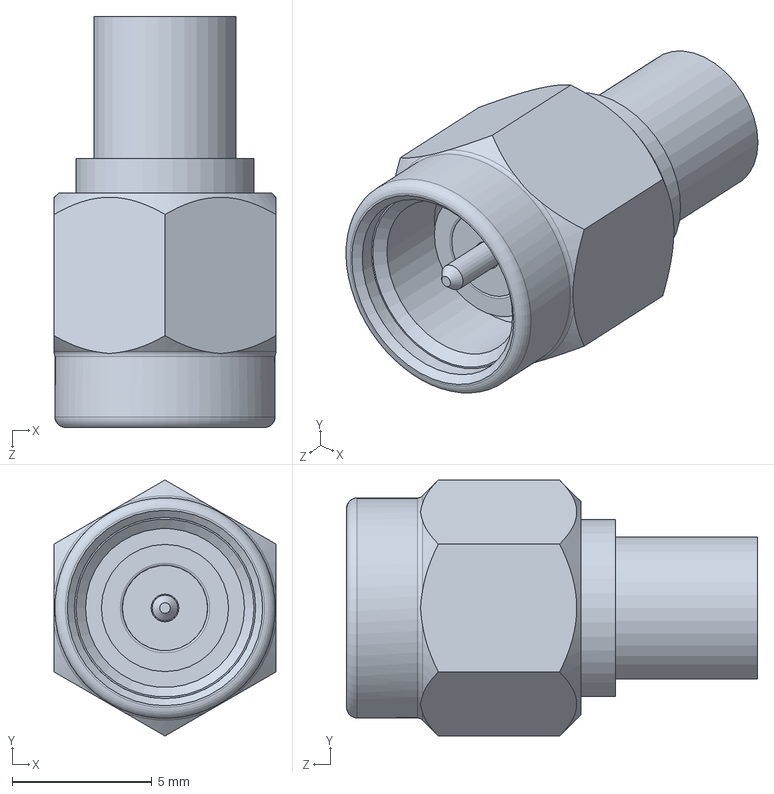
[picture p104: CAD file, 2020-08-17]
Design/Solidworks Controller WIFI/SMA male.SLDPRT
7.92 x 9.15 x 14.7 mm
