dhskinner/Scoreboard/Design/Solidworks Scoreboard/Processor - Shield ABare.sldprt

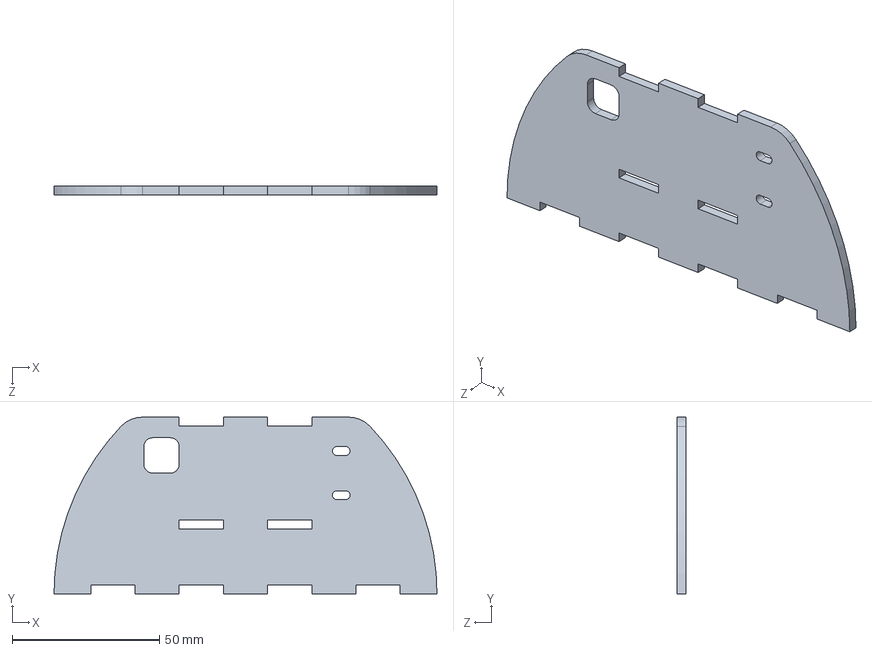
[picture p105: CAD file, 2017-08-02]
Design/Solidworks Scoreboard/Processor - Shield ABare.sldprt
130.0 x 60.0 x 3.00 mm
