dhskinner/Scoreboard/Design/Solidworks Scoreboard/Scoreboard Front.SLDPRT

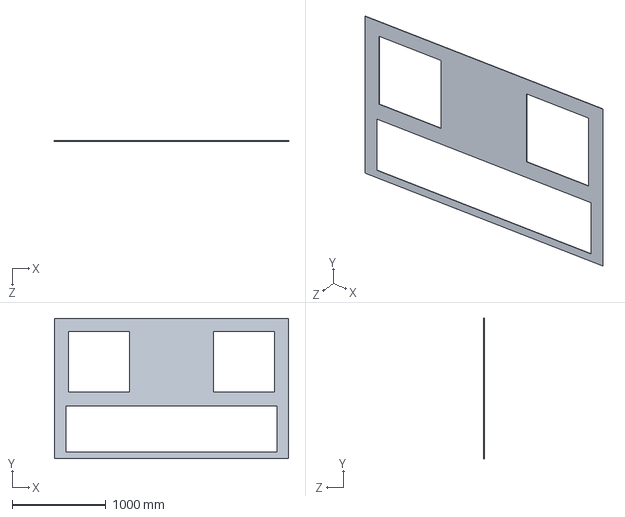
[picture p106: CAD file, 2017-08-02]
Design/Solidworks Scoreboard/Scoreboard Front.SLDPRT
2500.0 x 1500.0 x 4.00 mm
