dhskinner/Scoreboard/Design/Solidworks Scoreboard/Signboard - Side.SLDPRT

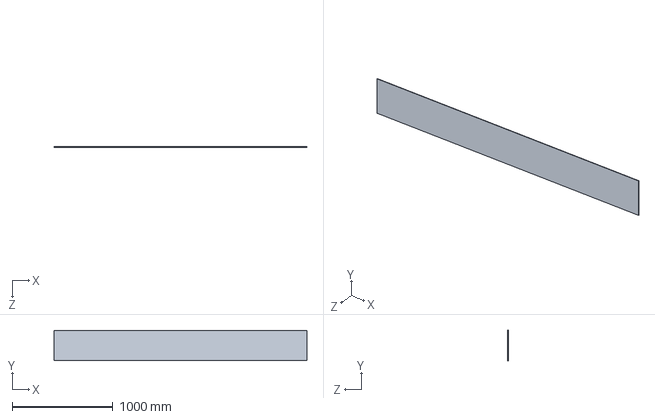
[picture p107: CAD file, 2017-08-02]
Design/Solidworks Scoreboard/Signboard - Side.SLDPRT
2508.0 x 300.0 x 4.00 mm
