dhskinner/Scoreboard/Design/Solidworks Scoreboard/Processor - Shield CBare.sldprt

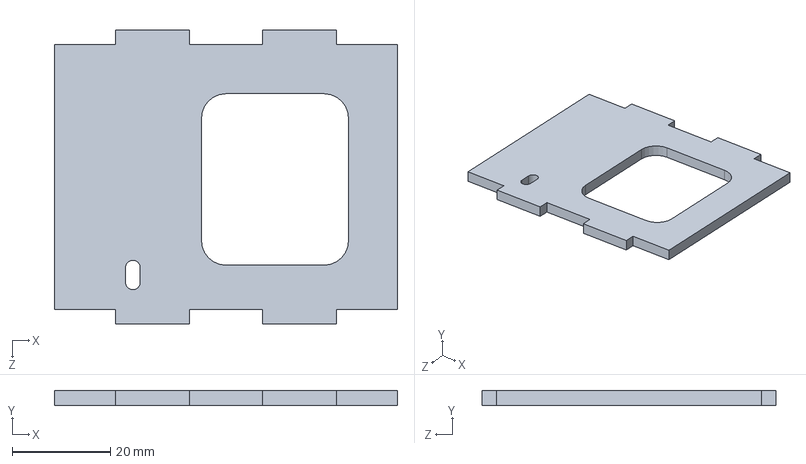
[picture p108: CAD file, 2017-08-02]
Design/Solidworks Scoreboard/Processor - Shield CBare.sldprt
70.0 x 3.00 x 60.0 mm
