dhskinner/Scoreboard/Design/Solidworks Scoreboard/Scoreboard - Trolley Steering Bar.SLDPRT

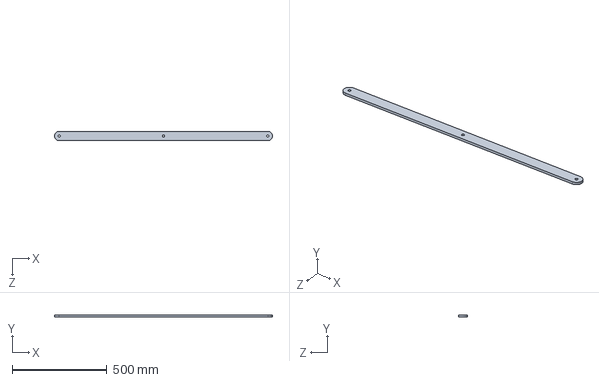
[picture p109: CAD file, 2017-08-02]
Design/Solidworks Scoreboard/Scoreboard - Trolley Steering Bar.SLDPRT
1149.8 x 10.0 x 50.0 mm
