dhskinner/Scoreboard/Design/Solidworks Controller ULCD/Scoreboard Controller Base Bezel.sldprt

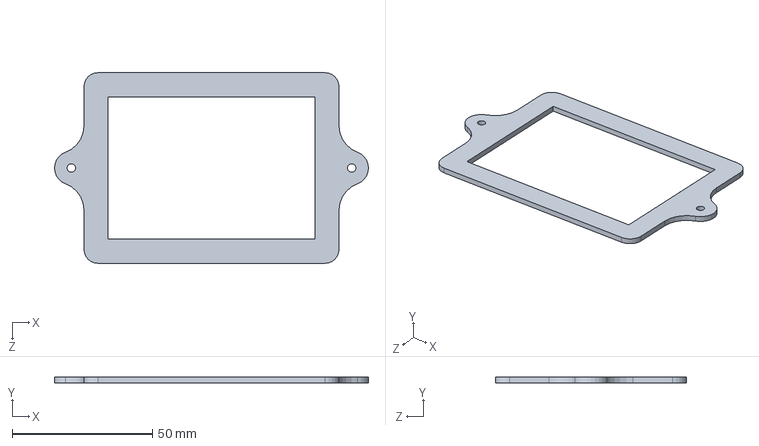
[picture p110: CAD file, 2017-08-02]
Design/Solidworks Controller ULCD/Scoreboard Controller Base Bezel.sldprt
112.0 x 2.00 x 68.0 mm
