dhskinner/Scoreboard/Design/Solidworks Scoreboard/Signboard - Top.SLDPRT

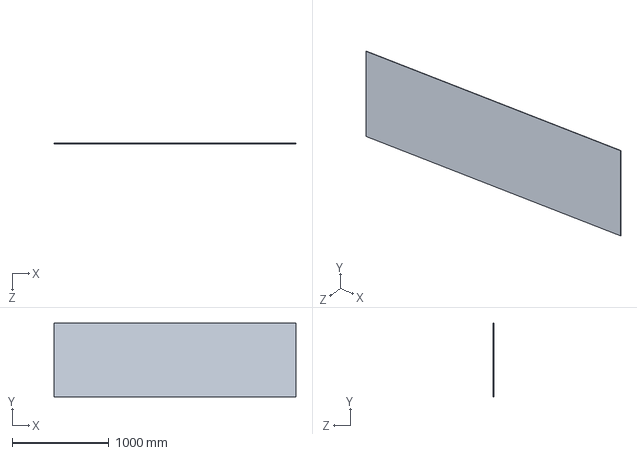
[picture p111: CAD file, 2017-08-02]
Design/Solidworks Scoreboard/Signboard - Top.SLDPRT
2500.0 x 760.0 x 4.00 mm
