dhskinner/Scoreboard/Design/Solidworks Controller ULCD/Duratech Box.SLDPRT

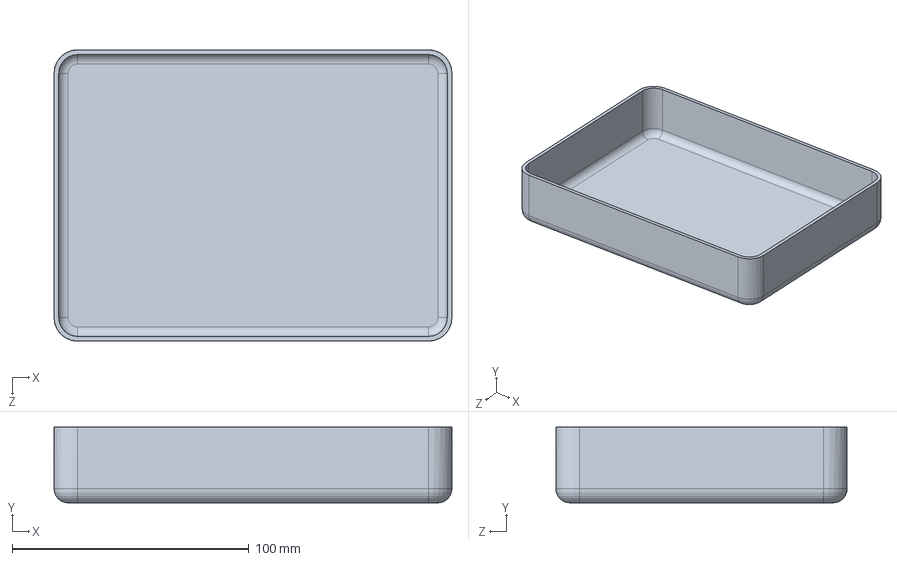
[picture p112: CAD file, 2017-08-02]
Design/Solidworks Controller ULCD/Duratech Box.SLDPRT
168.0 x 32.0 x 123.0 mm
