dhskinner/Scoreboard/(list of files, cad)

Other CAD files:
Design/Solidworks Controller ULCD/Adafruit Powerboost Charger.SLDASM
Design/Solidworks Controller ULCD/2x5Header.sldprt
Design/Solidworks Controller WIFI/Base PCB16.sldprt
Design/Solidworks Controller WIFI/Base PCB9.sldprt
Design/Solidworks Controller WIFI/Base PCB29.sldprt
Design/Solidworks Controller WIFI/Base PCB13.sldprt
Design/Solidworks Mini Timer/Scoreboard Timer Frame Front.SLDPRT
Design/Solidworks Controller ULCD/4DLCD-35T-HVGA-BASE.sldprt
Design/Solidworks Controller WIFI/Base PCB30.sldprt
Design/Solidworks Controller ULCD/Scoreboard Controller Base G.SLDPRT
Design/Solidworks Controller WIFI/Base PCB6.sldprt
Design/Solidworks Controller WIFI/Base PCB11.sldprt
Design/Solidworks Controller ULCD/User_Library-TQFP64.sldprt
Design/Solidworks Controller WIFI/Base PCB1.sldprt
Design/Solidworks Controller ULCD/4DLCD-35T-HVGA-FRAME.sldprt
Design/Solidworks Controller WIFI/Base PCB12.sldprt
Design/Solidworks Controller ULCD/112A-TAAR-R02_C_1.sldprt
Design/Solidworks Controller WIFI/Base PCB38.sldprt
Design/Solidworks Controller WIFI/Base PCB34.sldprt
Design/Solidworks Controller ULCD/User_Library-SOIC-8-150_SOIC_150_SOIC_5X4_1.sldprt
Design/Solidworks Controller WIFI/Base PCB28.sldprt
Design/Solidworks Controller ULCD/Header3x2.sldprt
Design/Solidworks Controller ULCD/4DLCD-35T-HVGA-METAL.sldprt
Design/Solidworks Controller WIFI/Base PCB26.sldprt
Design/Solidworks Controller WIFI/Base PCB23.sldprt
Design/Solidworks Controller WIFI/Base PCB7.sldprt
Design/Solidworks Controller ULCD/Corner1-Trimmed.sldprt
Design/Solidworks Controller ULCD/Speaker_Shell.sldprt
Design/Solidworks Controller WIFI/Base PCB18.sldprt
Design/Solidworks Controller ULCD/K3D-WH1S040WA1-R5_JAE_Connector_Division_Proprietary.sldprt
Design/Solidworks Controller WIFI/Base PCB24.sldprt
Design/Solidworks Controller ULCD/2x15Header.sldprt
Design/Solidworks Scoreboard/Processor - Shield FBare.sldprt
Design/Solidworks Controller ULCD/K3D-WH1P040WA1-R5 JAE Connector Division Proprietary.sldprt
Design/Solidworks Controller WIFI/Base PCB4.sldprt
Design/Solidworks Controller ULCD/Speaker_Magnet.sldprt
Design/Solidworks Controller WIFI/Base PCB27.sldprt
Design/Solidworks Controller ULCD/4DLCD-35T-HVGA-LCDGLASS.sldprt
Design/Solidworks Controller WIFI/Base PCB22.sldprt
Design/Solidworks Controller ULCD/uLCD-35DT-REV1.03_Outline.sldprt
Design/Solidworks Controller WIFI/Base PCB33.sldprt
Design/Solidworks Scoreboard/Scoreboard - Trolley Signboard Frame - Front.SLDPRT
Design/Solidworks Controller WIFI/Base PCB10.sldprt
Design/Solidworks Controller ULCD/SMA-angled.STEP
Design/Solidworks Controller WIFI/Base PCB36.sldprt
Design/Solidworks Controller WIFI/Base PCB21.sldprt
Design/Solidworks Controller ULCD/Flex.sldprt
Design/Solidworks Controller ULCD/User_Library-SOIC-8-150_pin_SOIC_SO-150_1.sldprt
Design/Solidworks Controller WIFI/Base PCB3.sldprt
Design/Solidworks Controller WIFI/Base PCB2.sldprt
Design/Solidworks Controller ULCD/Samtec-TSM-102-01-L-DH-A.sldprt
Design/Solidworks Controller WIFI/Base PCB5.sldprt
Design/Solidworks Controller WIFI/LIPO Fuel Gauge.SLDPRT
Design/Solidworks Controller WIFI/Base PCB31.sldprt
Design/Solidworks Controller WIFI/Base PCB15.sldprt
Design/Solidworks Controller ULCD/900590009.sldprt
Design/Solidworks Controller ULCD/901-9209a_Rev-k1-new.SLDPRT
Design/Solidworks Controller WIFI/92844-005 USB CABLE B MALE TO B FEMALE PANEL MOUNT2.SLDPRT
Design/Solidworks Controller WIFI/Base PCB14.sldprt
Design/Solidworks Controller WIFI/Base PCB17.sldprt
Design/Solidworks Controller WIFI/Base PCB19.sldprt
Design/Solidworks Controller WIFI/Base PCB20.sldprt
Design/Solidworks Controller WIFI/Base PCB25.sldprt
Design/Solidworks Controller WIFI/Base PCB32.sldprt
Design/Solidworks Controller WIFI/Base PCB35.sldprt
Design/Solidworks Controller WIFI/Base PCB37.sldprt
Design/Solidworks Controller WIFI/Base PCB8.sldprt
Design/Solidworks Controller WIFI/SMA Antenna.SLDPRT
Design/Solidworks Controller WIFI/Spacer 14mm.SLDPRT
Design/Solidworks Controller WIFI/Spacer 17.5mm.SLDPRT
Design/Solidworks Controller WIFI/User Library-SMA_AntennaR.SLDPRT
Design/Solidworks Controller WIFI/micro_usb_plug.SLDPRT
Design/Solidworks Drawings/Scoreboard Board.SLDDRW
Design/Solidworks Drawings/Scoreboard Front Panel.SLDDRW
Design/Solidworks Drawings/Scoreboard Overview.SLDDRW
Design/Solidworks Drawings/Scoreboard Panel Fixings.SLDDRW
Design/Solidworks Drawings/Scoreboard Trolley.SLDDRW
Design/Solidworks Scoreboard/Electronics Sled Triple.SLDPRT
Design/Solidworks Scoreboard/Electronics Sled.SLDPRT
Design/Solidworks Scoreboard/Freetronics DMD Simplified.SLDPRT
Design/Solidworks Scoreboard/Scoreboard - Flashing.SLDPRT
Design/Solidworks Scoreboard/Scoreboard - Trolley 2.SLDPRT
Design/Solidworks Scoreboard/Scoreboard - Trolley Wheel.SLDPRT
Design/Solidworks Scoreboard/Scoreboard 4 x 2 Frame.SLDPRT
Design/Solidworks Scoreboard/Washer 19x50x3.SLDPRT
