dhskinner/Scoreboard/Manual/Scoreboard Block Diagram.pptx

Logical Block Diagram

Left Panel

Panel 7

Panel 8

Panel 5

Panel 6

Panel 3

Panel 4

Panel 1

Panel 2

Panel Control Microprocessor

16 Pin (2x8) Ribbon Cable

Master Controller

NRF24L01+PA Radio

Master Control Microprocessor
(Arduino Nano)

DS3231 Real Time Clock

Right Panel

Panel 7

Panel 8

Panel 5

Panel 6

Panel 3

Panel 4

Panel 1

Panel 2

Panel Control Microprocessor

2.4GHz Coax

I2C Serial Bus

I2C Serial Bus

8 Pin (2x4) Cable

## Slide 2

Power Block Diagram

Left Panel

Panel 7

Panel 8

Panel 5

Panel 6

Panel 3

Panel 4

Panel 1

Panel 2

Panel Control Microprocessor

240V AC - 5V 40A DC POWER

3V DC

5V DC

240V AC

Master Controller

NRF24L01+PA Radio

Master Control Microprocessor

DS3231 Real Time Clock

Right Panel

Panel 7

Panel 8

Panel 5

Panel 6

Panel 3

Panel 4

Panel 1

Panel 2

Panel Control Microprocessor

240V AC - 5V 40A DC POWER

LM117 3V3 Regulator

## Slide 3

Sponsors Board

Sponsor Panel

Panel A1

Panel A2

Panel A3

Panel A4

Panel A5

Panel A6

Panel A7

Panel B1

Panel B2

Panel B3

Panel B4

Panel B5

Panel B6

Panel B7

Panel C1

Panel C2

Panel C3

Panel C4

Panel C5

Panel C6

Panel C7

Huidu HD-W6B LED Controller

240V AC - 5V 40A DC POWER

240V AC - 5V 40A DC POWER

240V AC - 5V 40A DC POWER

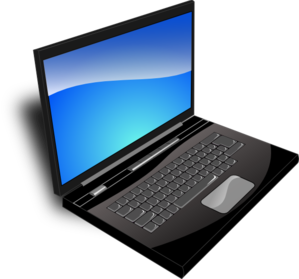
[picture p113: figure]

HD2020 Software

16 Pin Ribbon

5V DC

Ethernet
