dhskinner/Scoreboard/Manual/Controller Instruction Card.pptx

PLEASE TURN OFF THE CONTROLLER & RETURN IT TO THE BAR AFTER USE
WIFI SSID Scoreboard
Password MightyBugs
Webpage http://scoreboard
CHARGING
Use the USB charger from the bar. Allow 4 hours. Do not leave on permanent charge.
The power switch must be ‘On’ to charge
LOST AND FOUND
If found please contact: http://wynnumrugby.com.au/contact-us/

| Long flash every 2 secs | Low battery – charge immediately
| Short flash per second | Error – no signal or out of range – move closer
| Short flash per second | Normal – sending or receiving score data
| Short flash occasionally | Normal – sending or receiving WiFi data
