dhskinner/Scoreboard/Design/PDF Drawings/Scoreboard LED 4x2 Panel.pdf

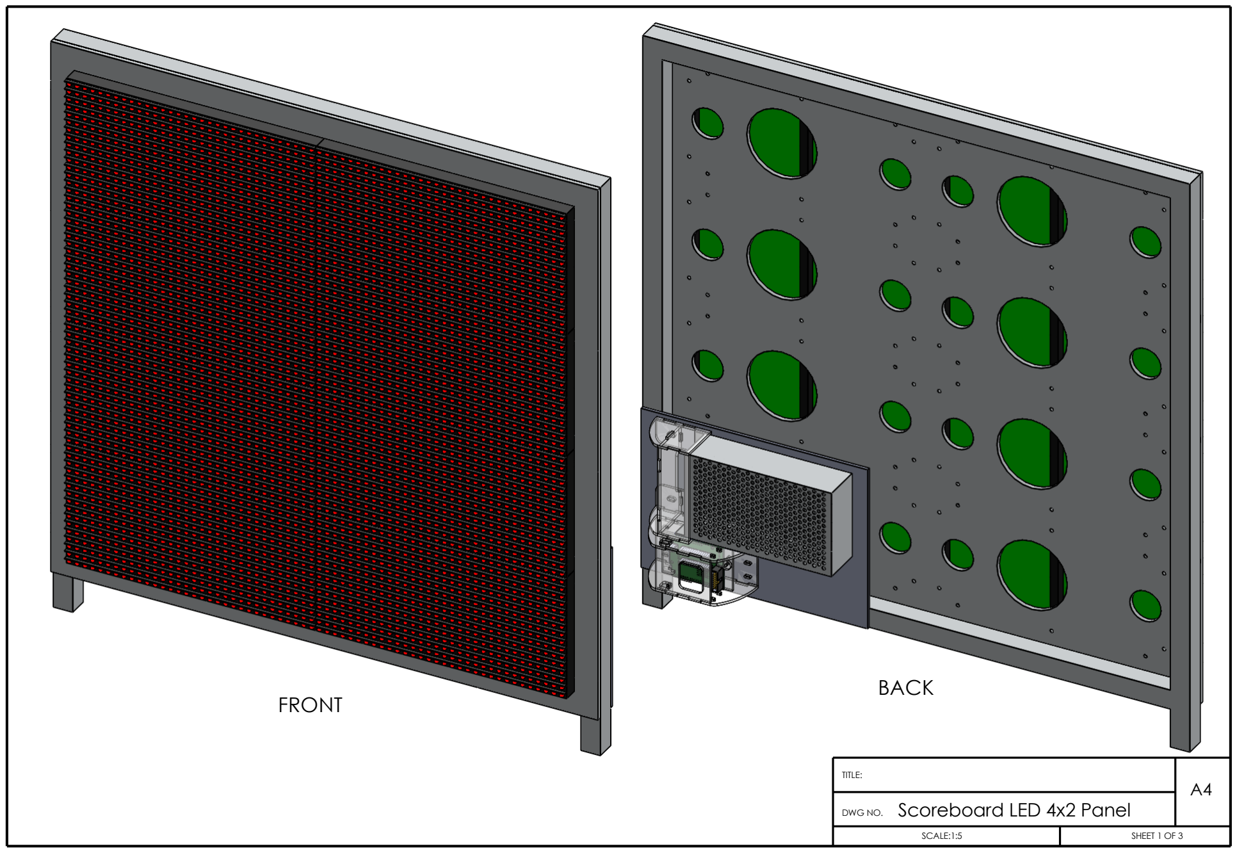
[picture p162: page 1]

SHEET 1 OF 3

TITLE:

DWG NO.

A4

SCALE:1:5

Scoreboard LED 4x2 Panel

FRONT

BACK

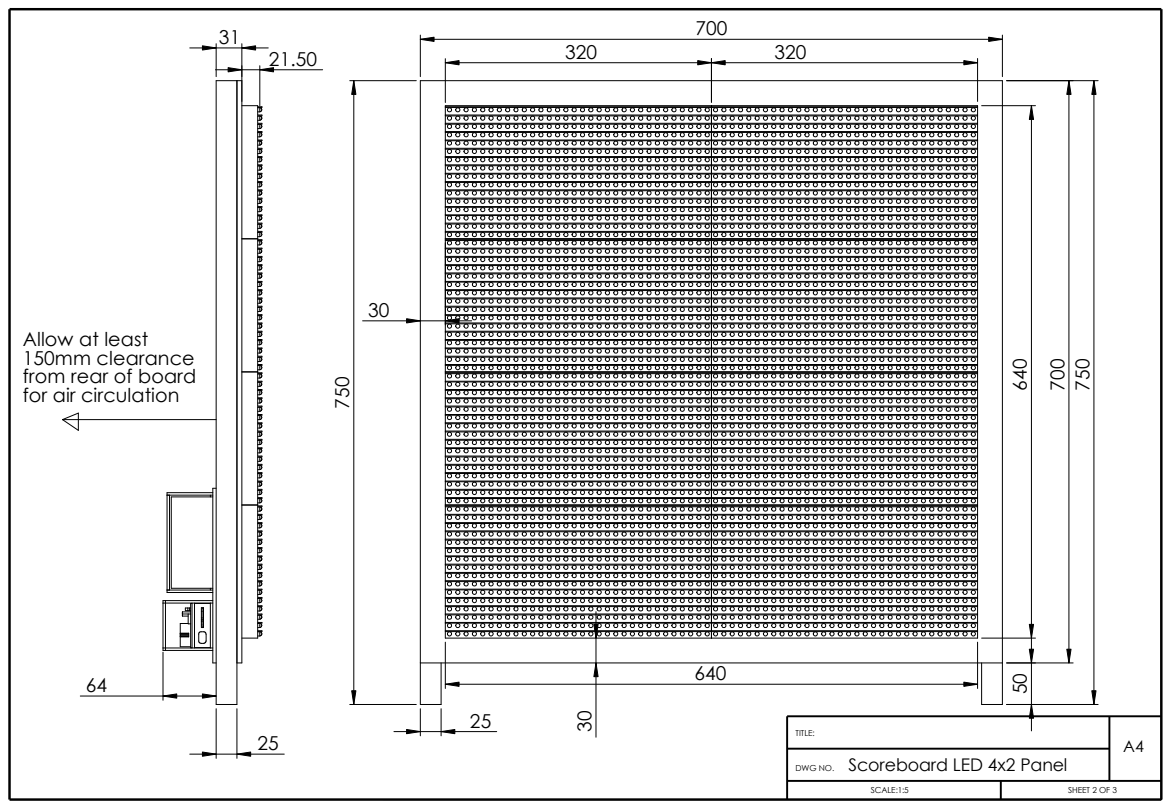
[picture p163: page 2]
TITLE:; SHEET 2 OF 3; DWG NO.; Scoreboard LED 4x2 Panel

Allow at least
150mm clearance
from rear of board
for air circulation

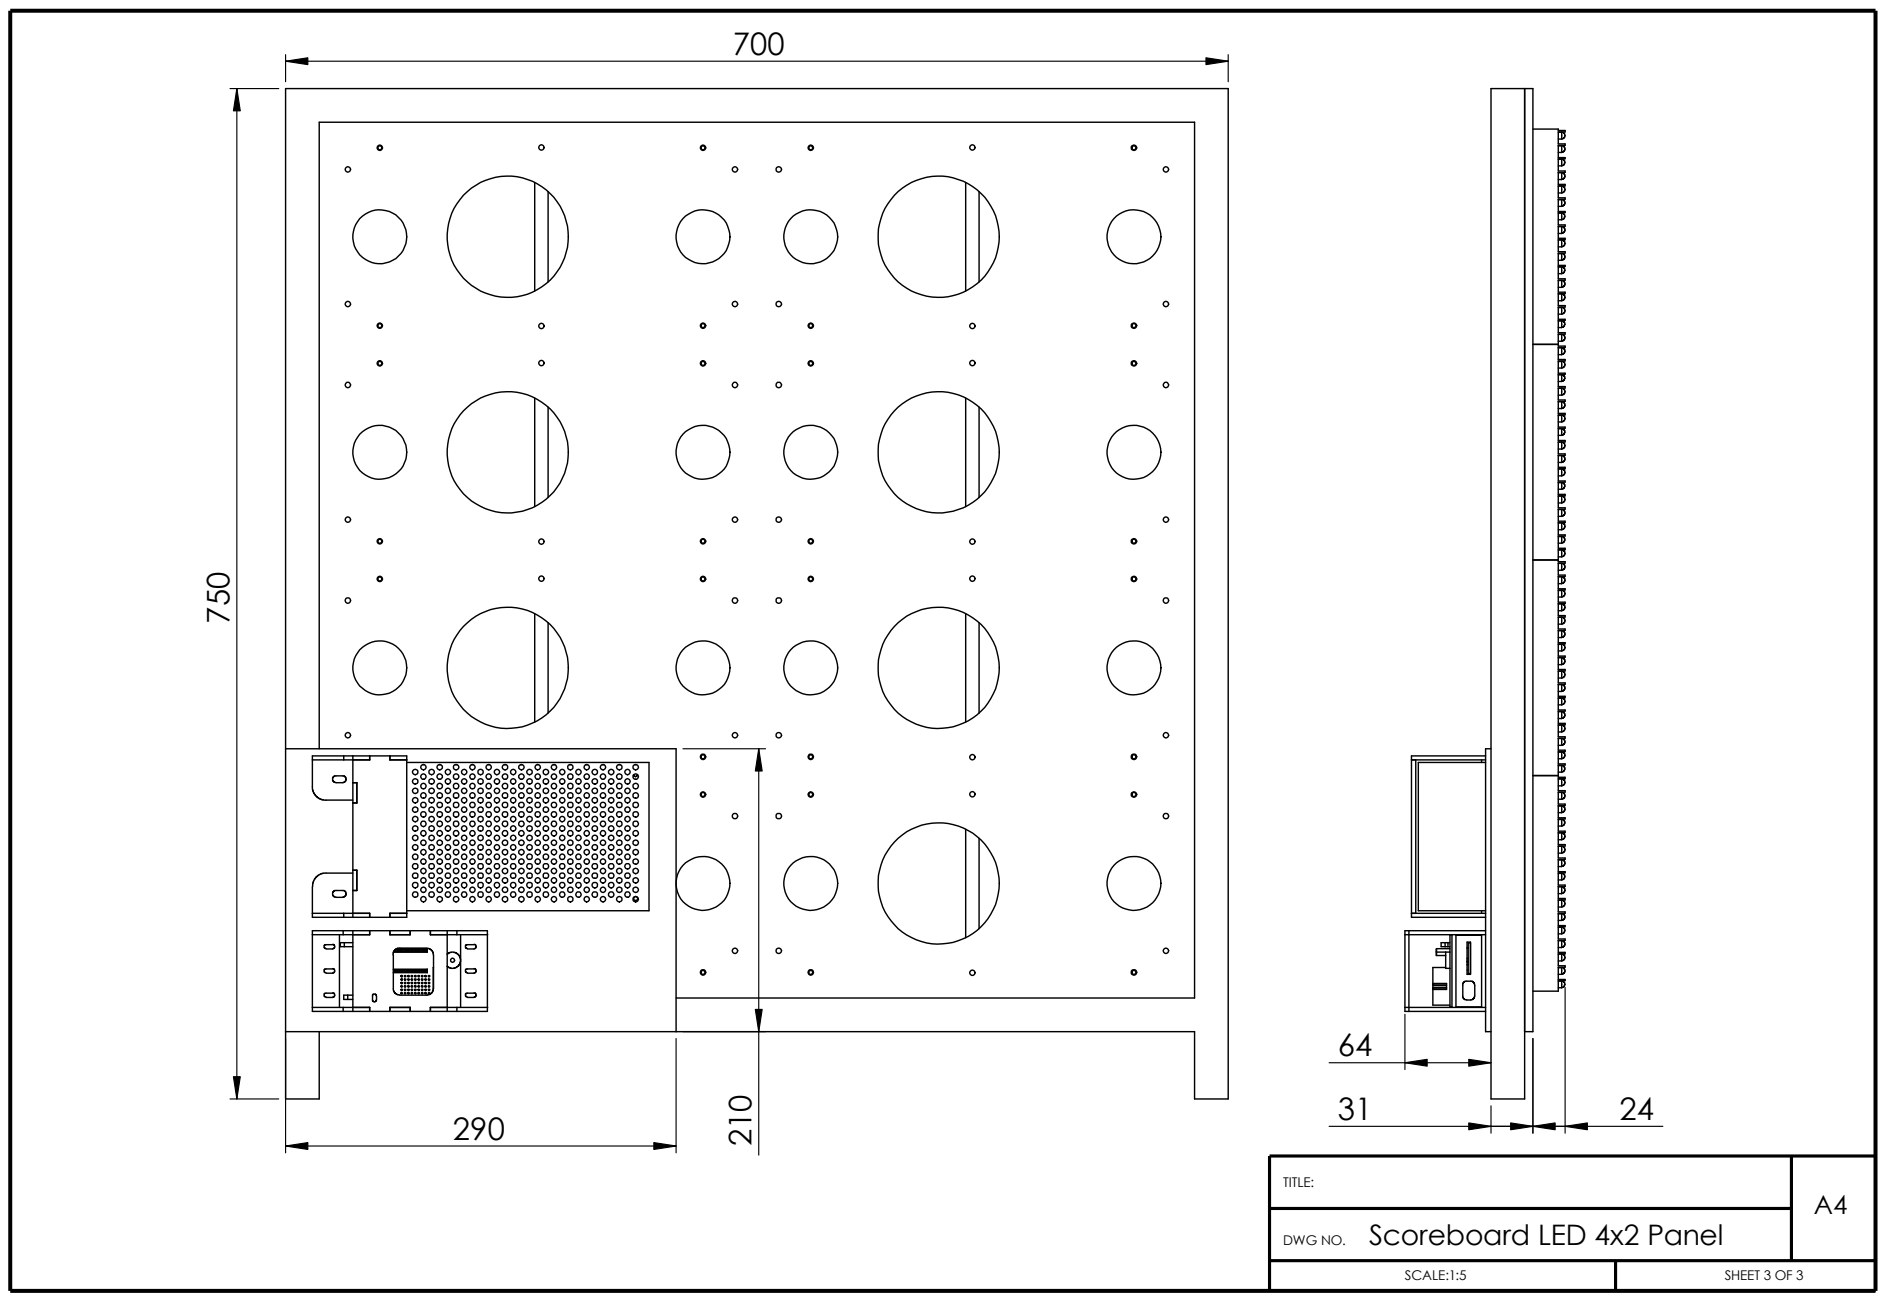
[picture p164: page 3]
DWG NO.; SHEET 3 OF 3; TITLE:

Scoreboard LED 4x2 Panel
