dhskinner/Scoreboard/Design/PDF Drawings/Scoreboard LED 7x3 Panel.pdf

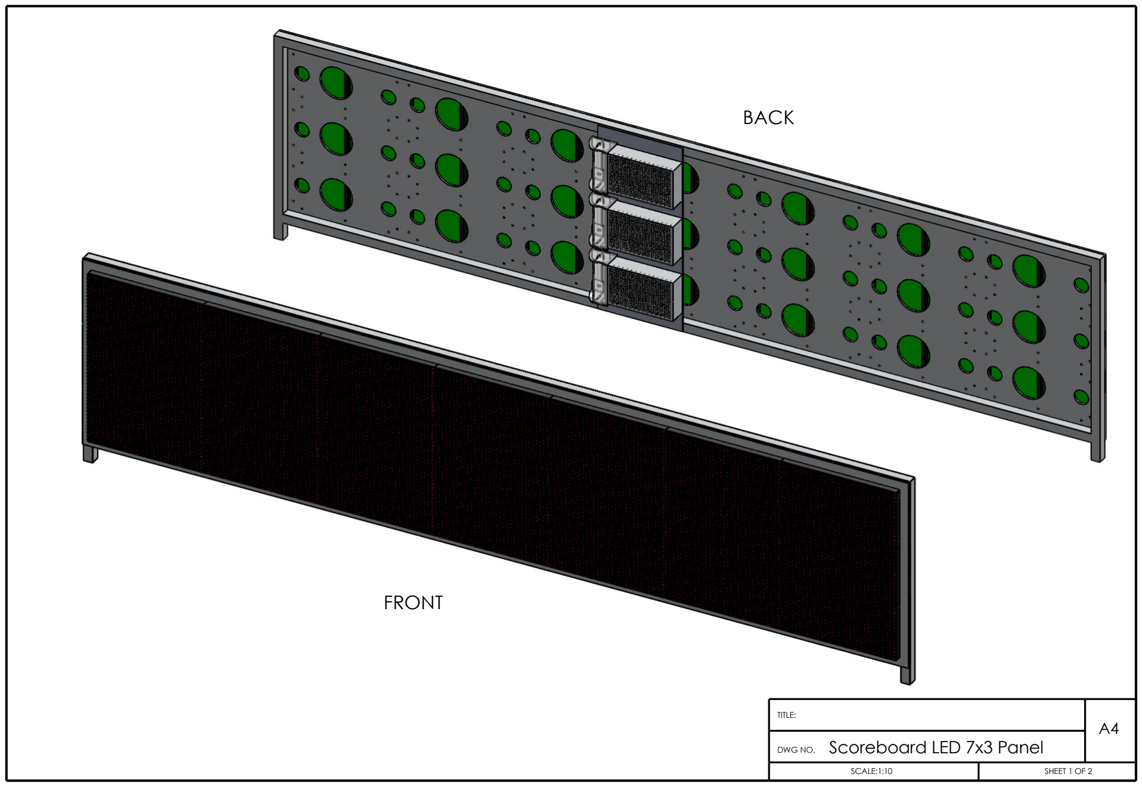
[picture p165: page 1]

SHEET 1 OF 2

A4

TITLE:

DWG NO.

SCALE:1:10

Scoreboard LED 7x3 Panel

FRONT

BACK

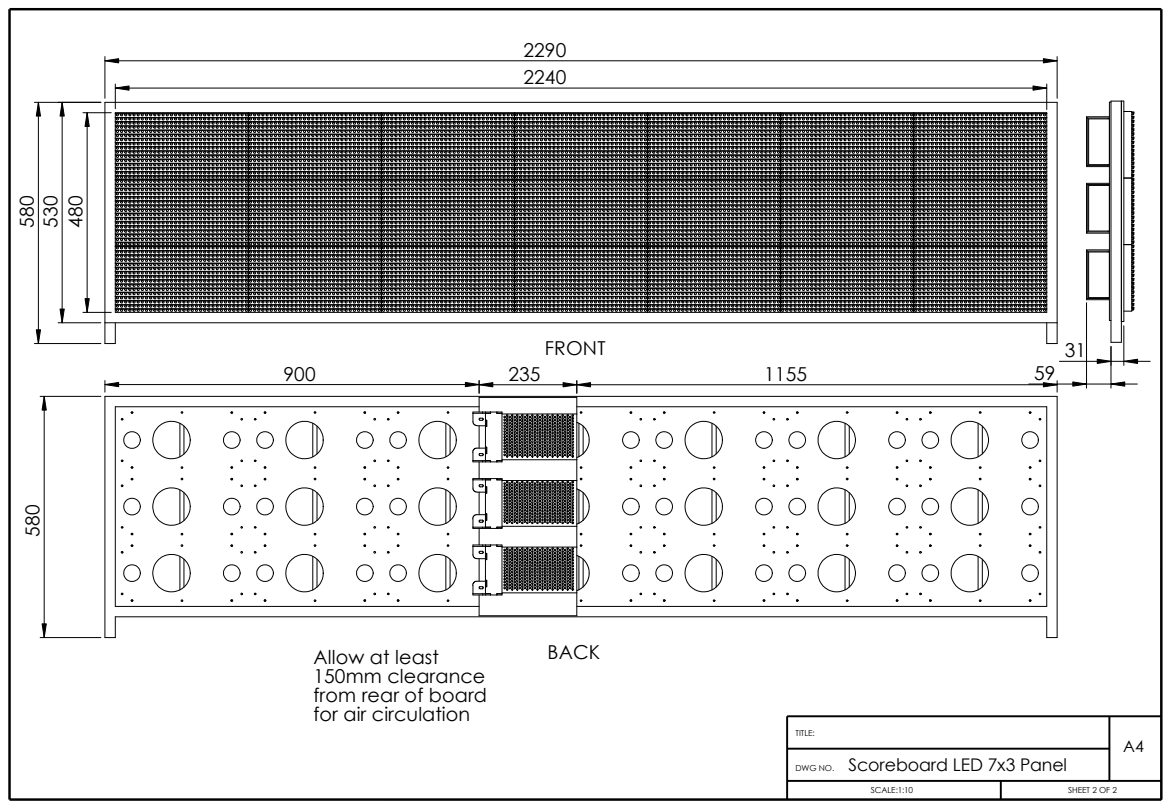
[picture p166: page 2]
TITLE:; DWG NO.; SCALE:1:10; SHEET 2 OF 2; FRONT; BACK

Allow at least
150mm clearance
from rear of board
for air circulation

Scoreboard LED 7x3 Panel
