dhskinner/Scoreboard/Design/PDF Drawings/Scoreboard Panels.pdf

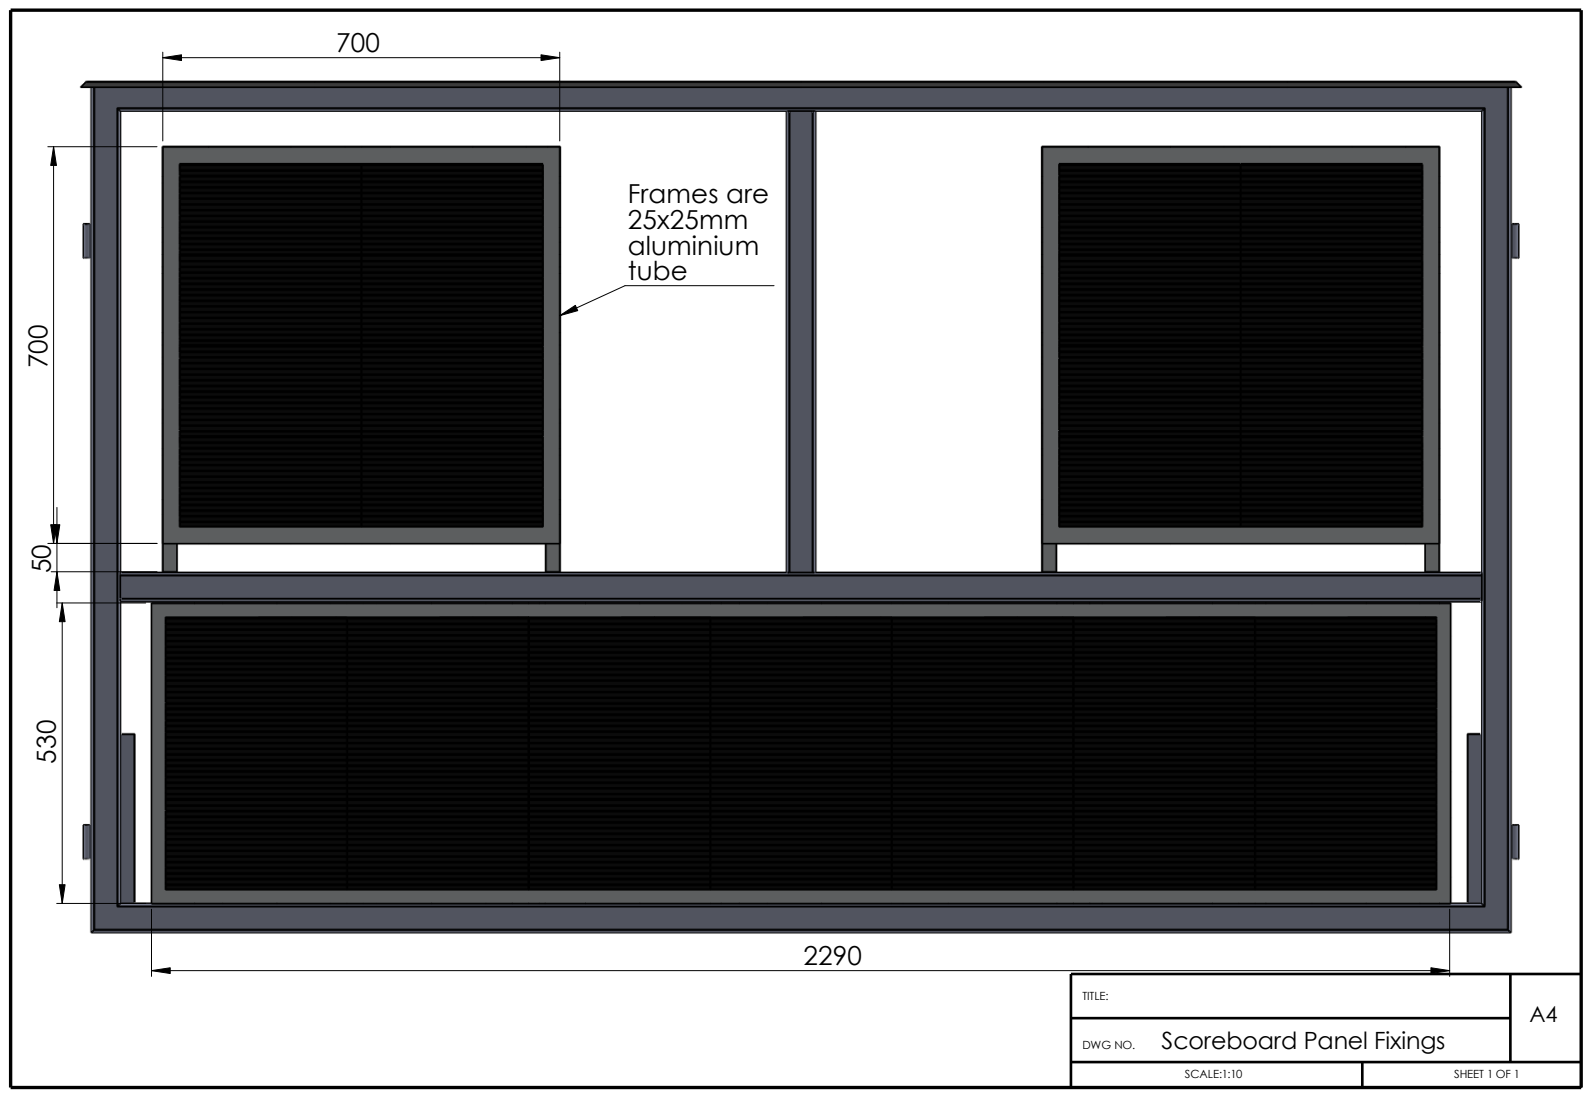
[picture p167: page 1]
DWG NO.; SCALE:1:10; TITLE:; SHEET 1 OF 1; Frames are 25x25mm aluminium tube

Scoreboard Panel Fixings
