dhskinner/Scoreboard/Design/PDF Drawings/Scoreboard Trolley.pdf

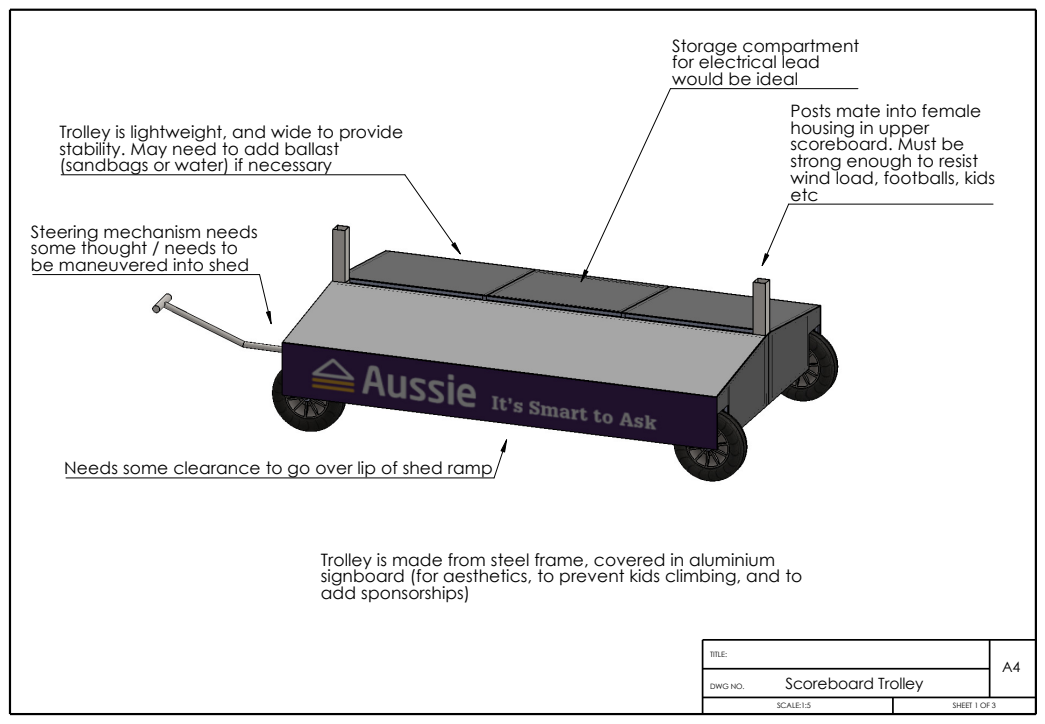
[picture p168: page 1]
SHEET 1 OF 3; TITLE:; DWG NO.; SCALE:1:5; Scoreboard Trolley

Storage compartment
for electrical lead
would be ideal

Posts mate into female
housing in upper
scoreboard. Must be
strong enough to resist
wind load, footballs, kids
etc

Trolley is lightweight, and wide to provide
stability. May need to add ballast
(sandbags or water) if necessary

Steering mechanism needs
some thought / needs to
be maneuvered into shed

Needs some clearance to go over lip of shed ramp

Trolley is made from steel frame, covered in aluminium
signboard (for aesthetics, to prevent kids climbing, and to
add sponsorships)

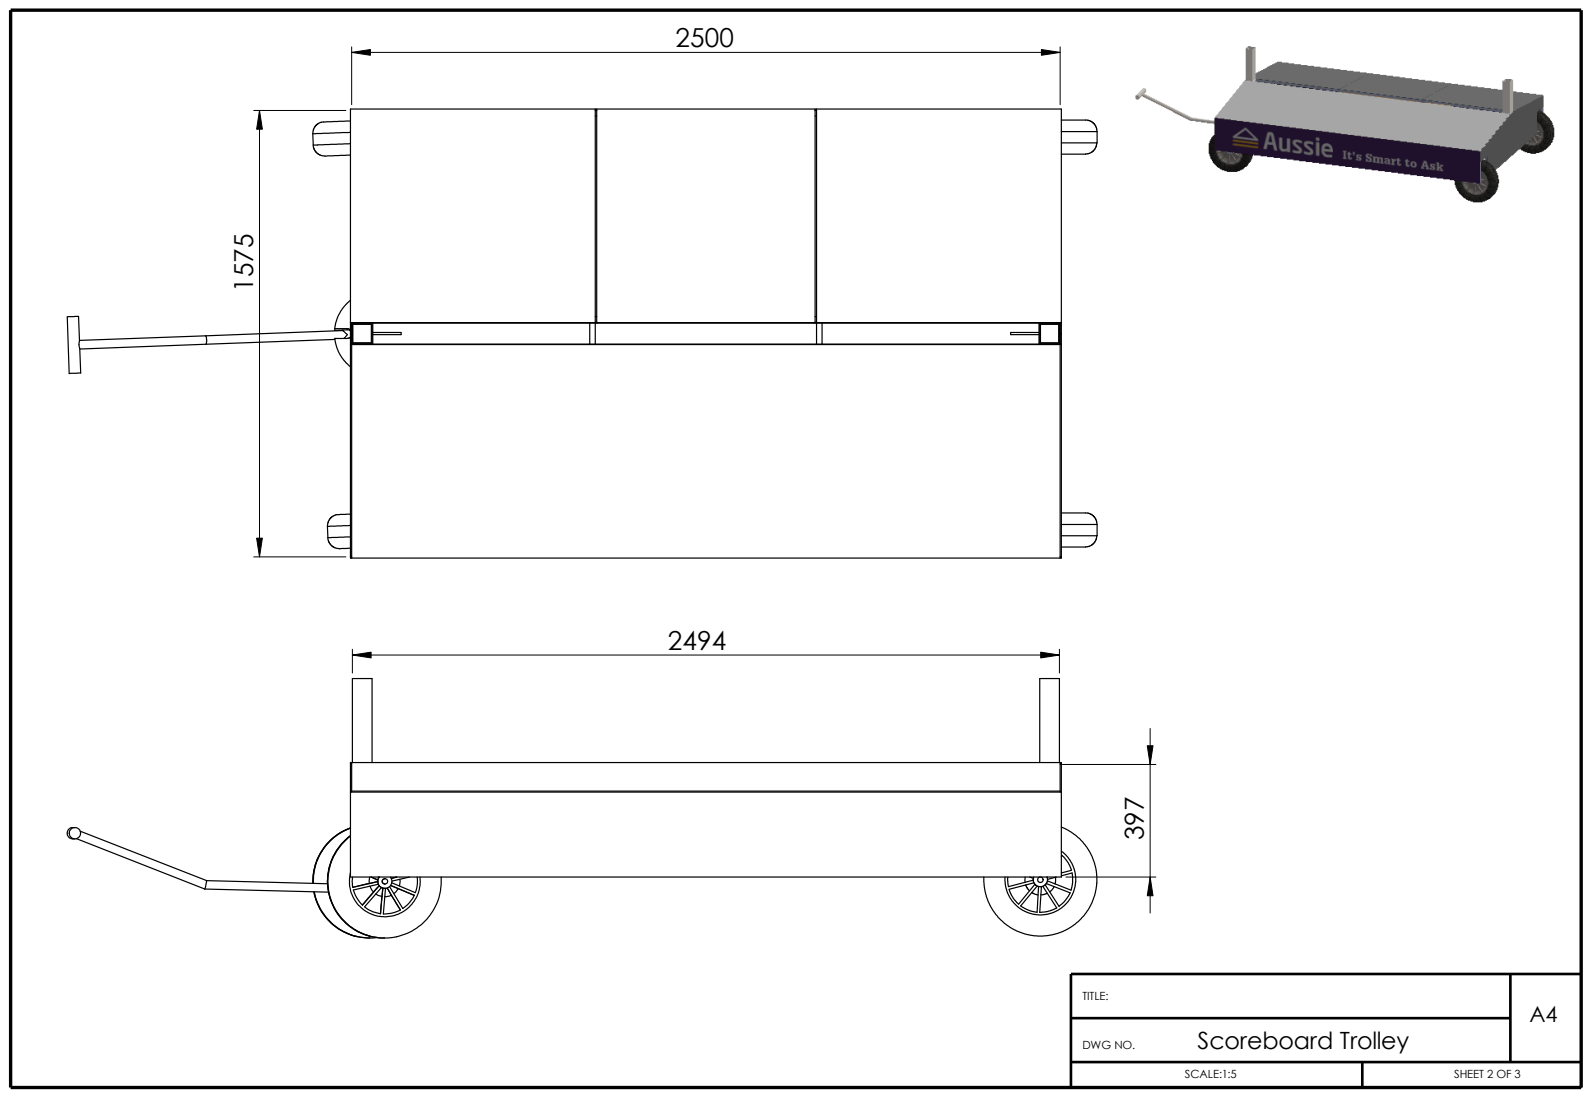
[picture p169: page 2]
TITLE:; SCALE:1:5; SHEET 2 OF 3; Scoreboard Trolley

TITLE:

SCALE:1:5 | SHEET 3 OF 3

A4
Scoreboard Trolley

CONCEPT
