dhskinner/Scoreboard/Design/PDF Drawings/Scoreboard Front .pdf

2500

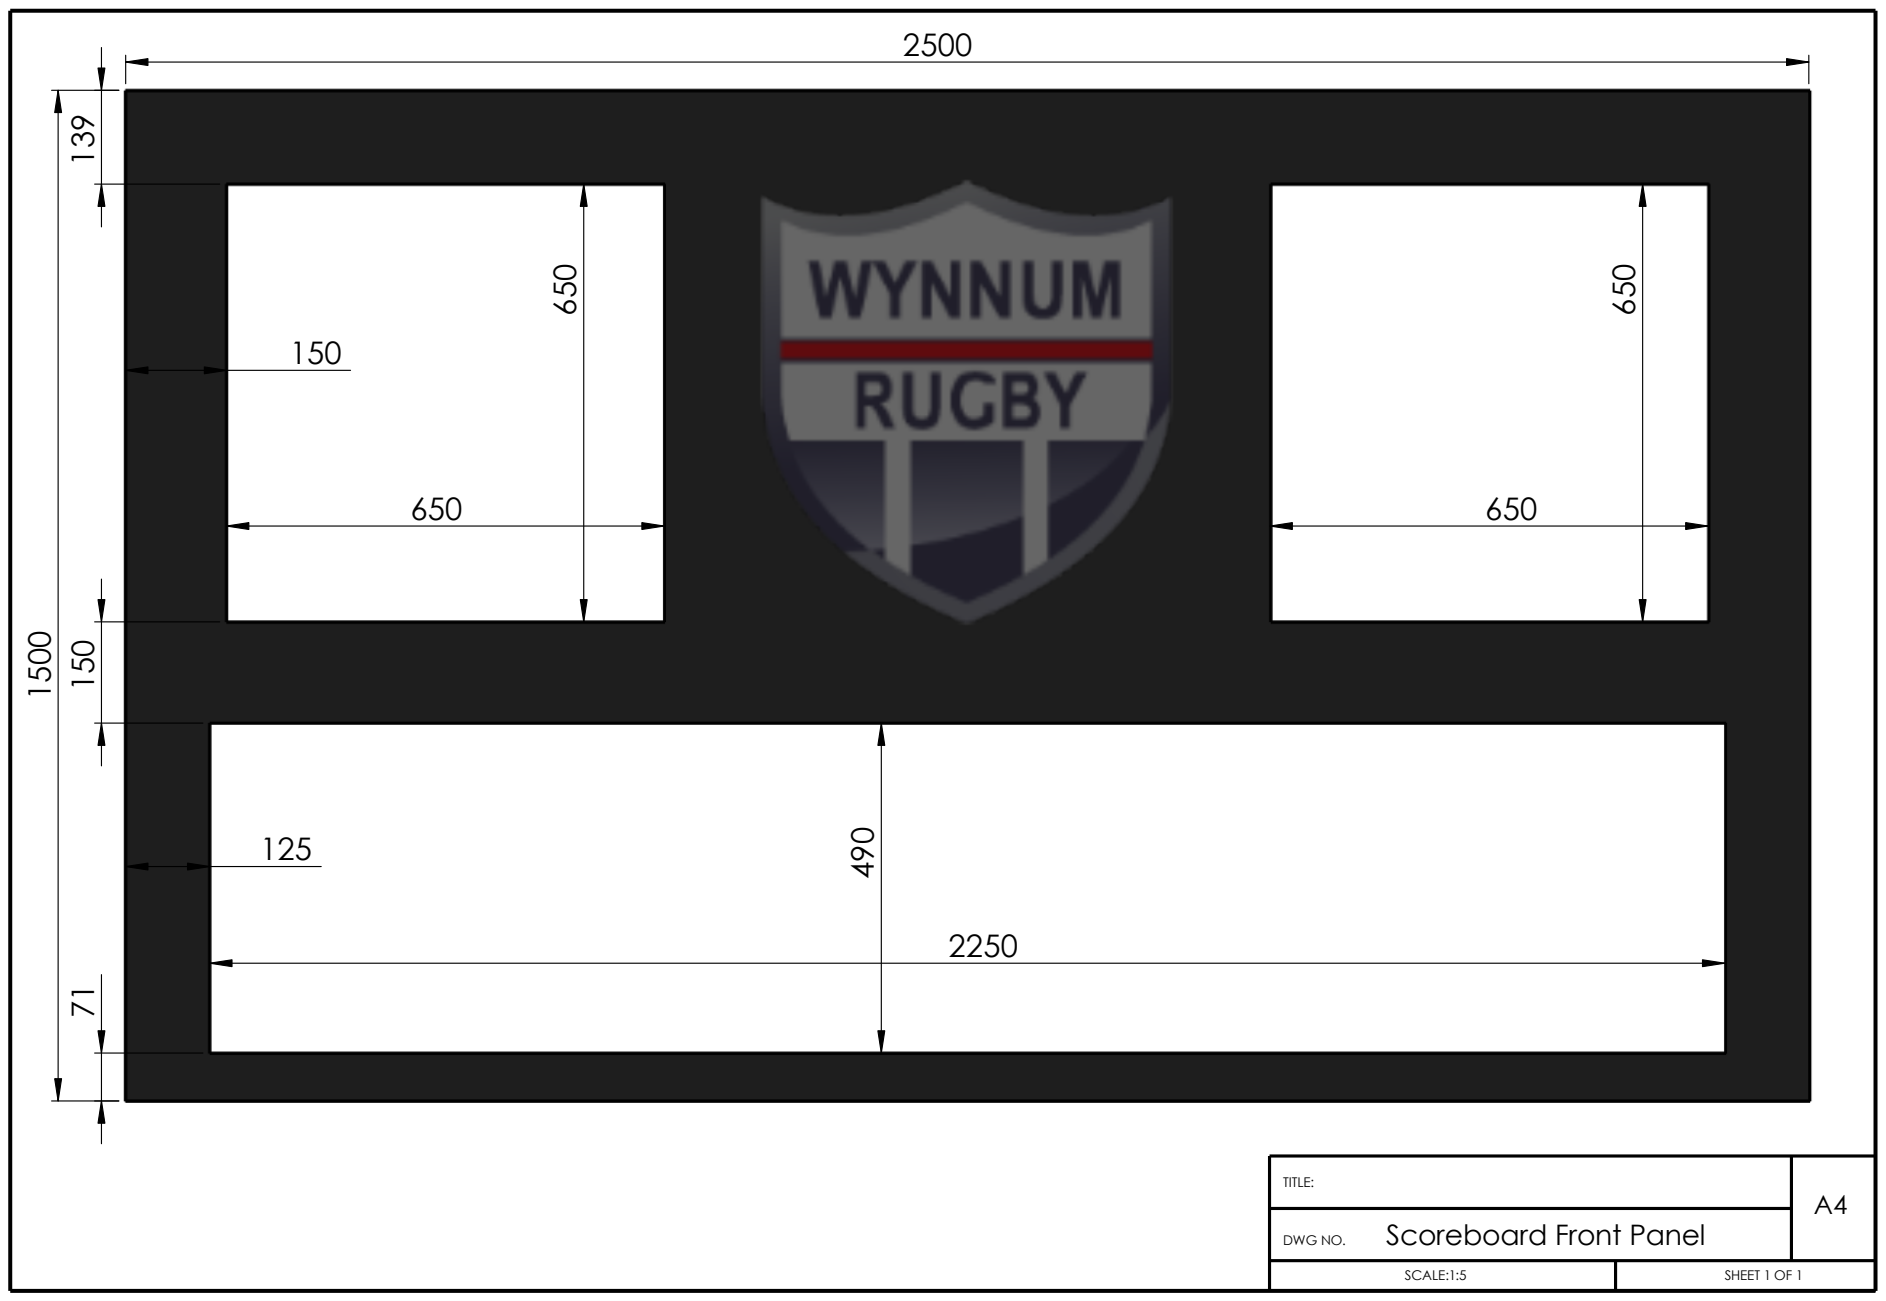
[picture p170: page 1]
TITLE:; SHEET 1 OF 1; DWG NO.; SCALE:1:5

Scoreboard Front Panel
