dhskinner/Scoreboard/Design/PDF Drawings/Scoreboard Overview.pdf

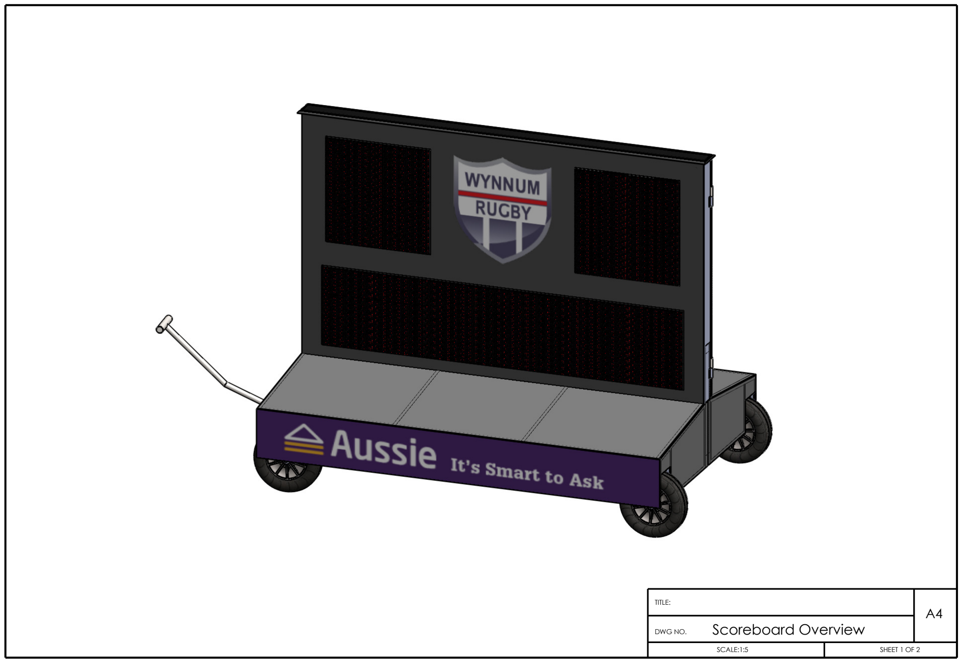
[picture p171: page 1]

TITLE:

DWG NO.

A4

SCALE:1:5 | SHEET 1 OF 2

# Scoreboard Overview

2500

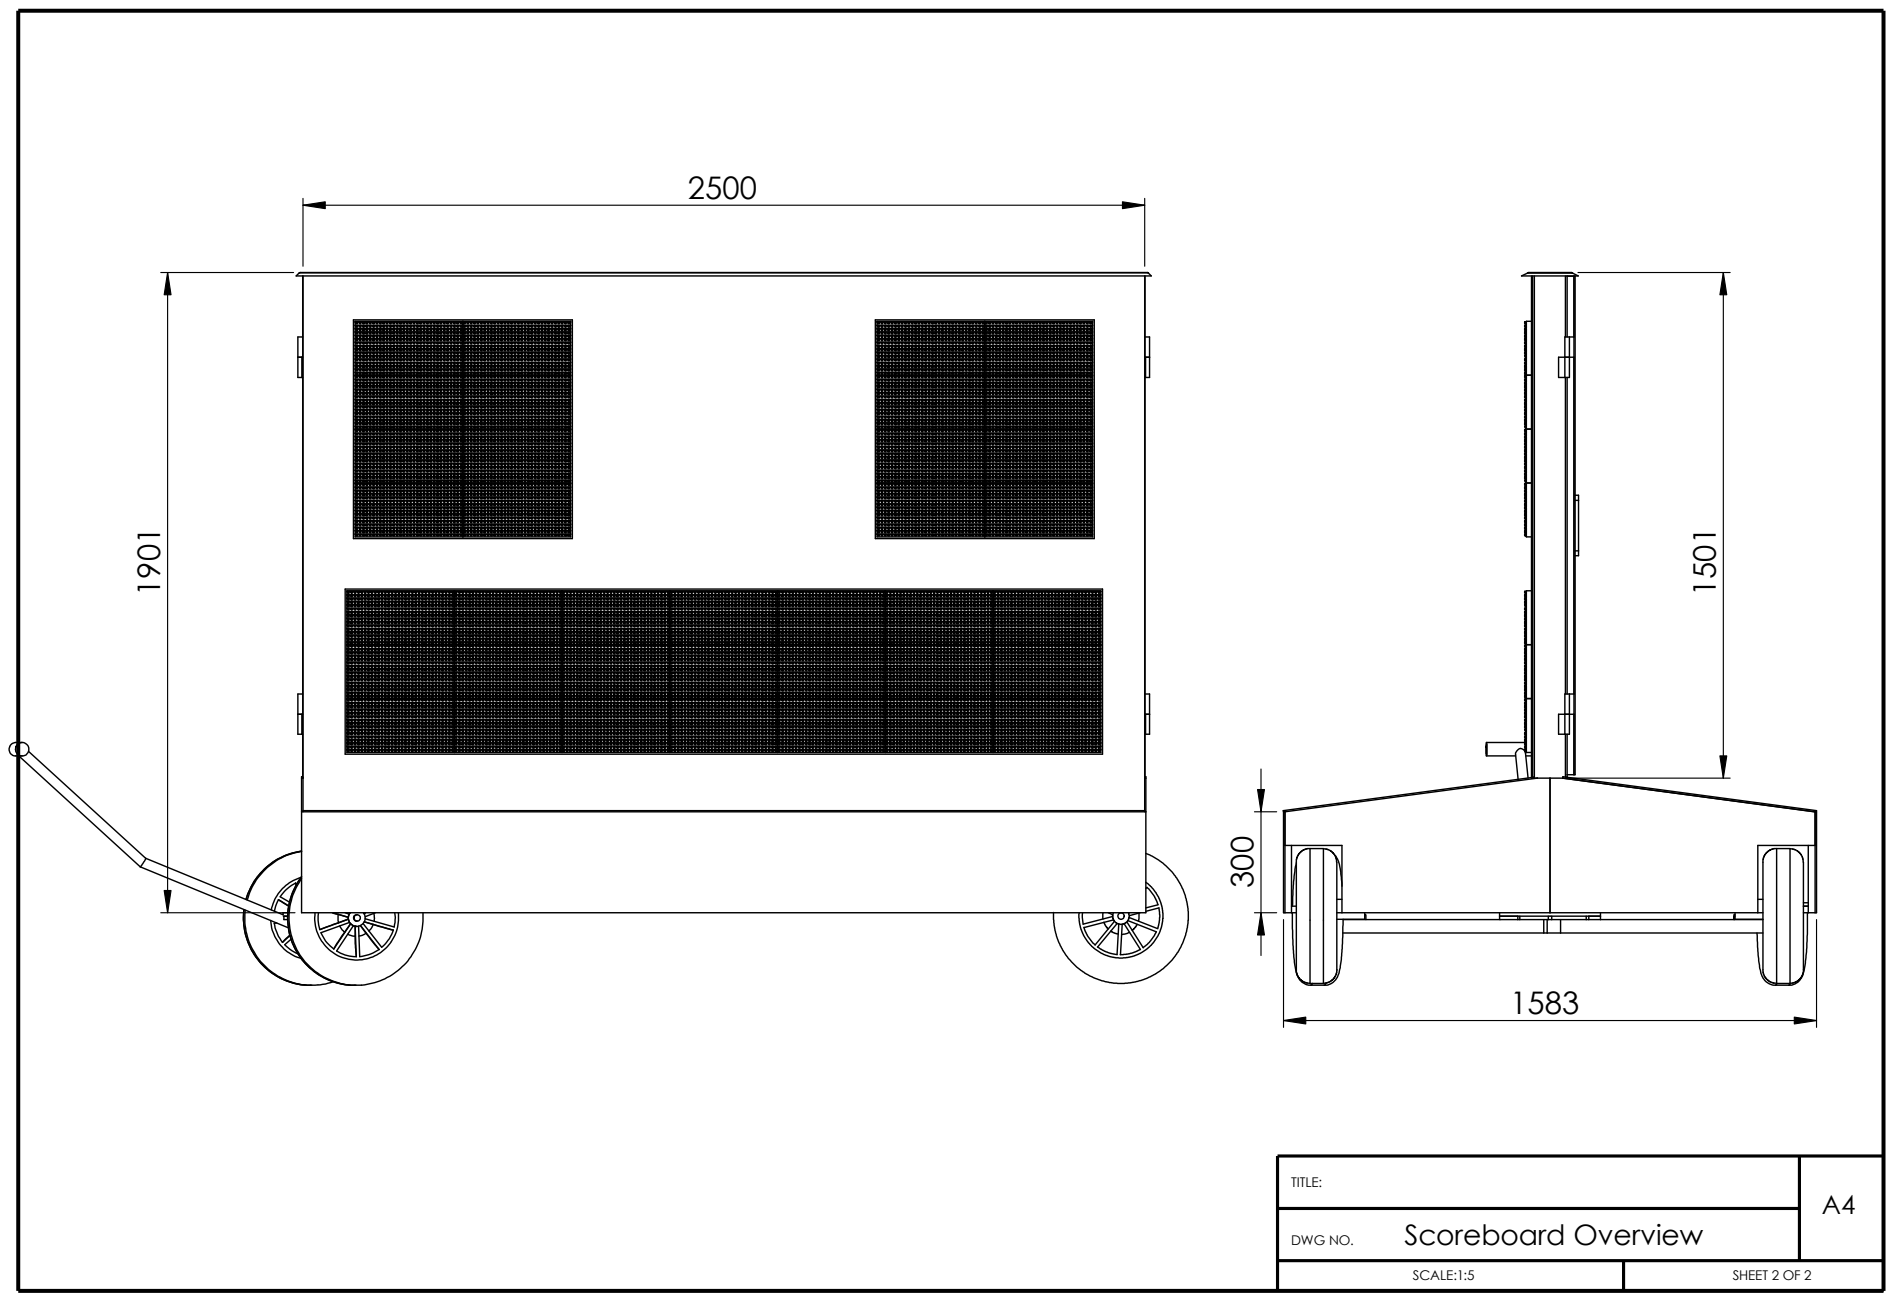
[picture p172: page 2]
DWG NO.; SHEET 2 OF 2; SCALE:1:5; TITLE:; Scoreboard Overview
