dhskinner/Scoreboard/Sponsors/2018_Season/Logos/joy construction new logo4.pdf

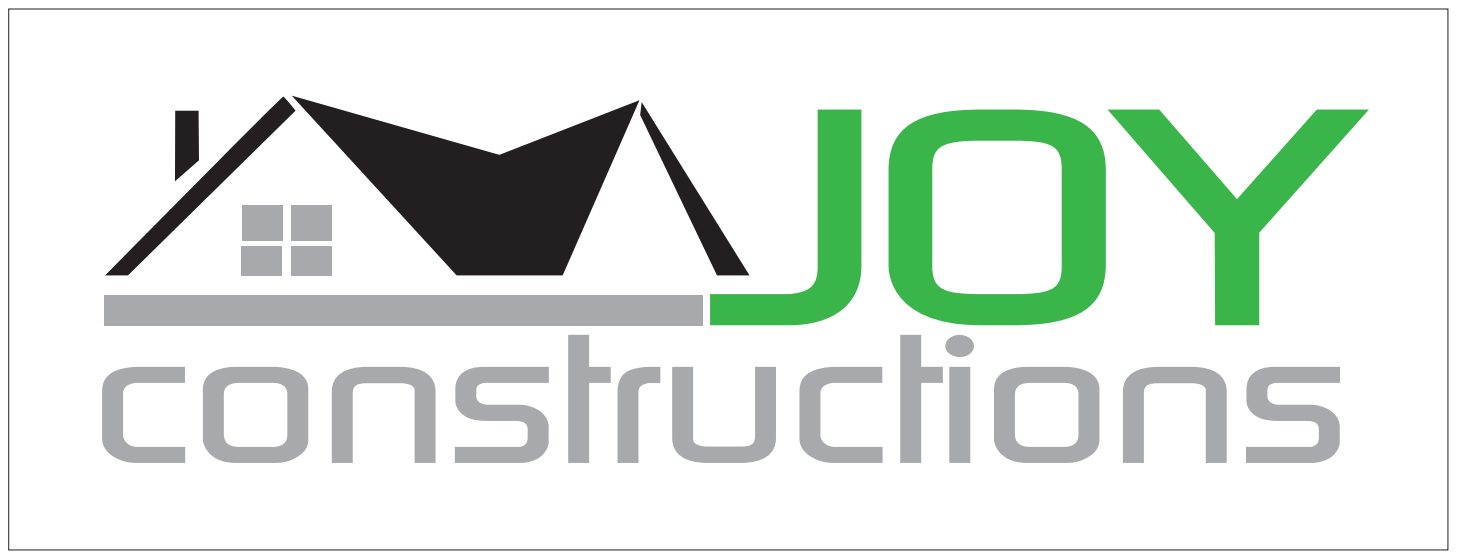
[picture p173: page 1]
