dhskinner/Scoreboard/Sponsors/2023_Season/2023 Sponsors.pdf

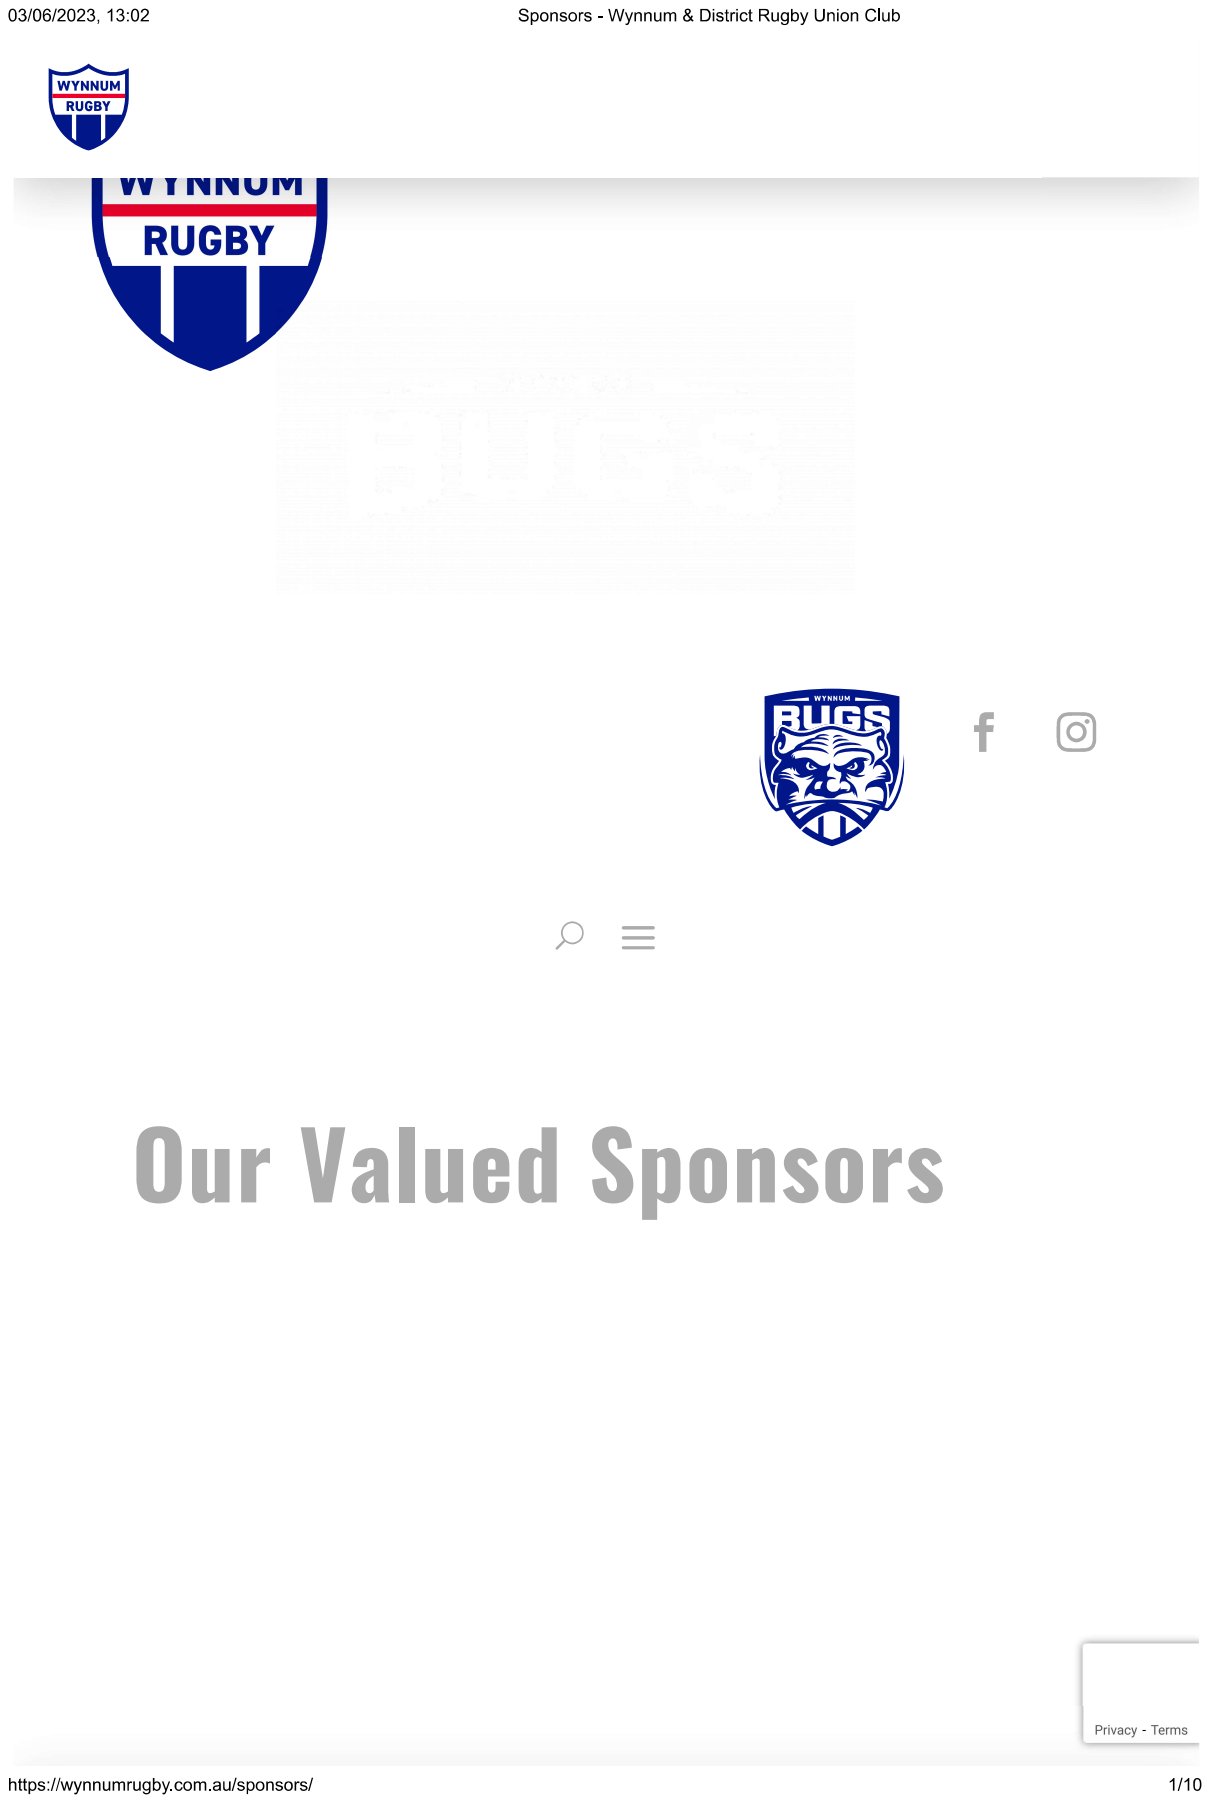
[picture p174: page 1]

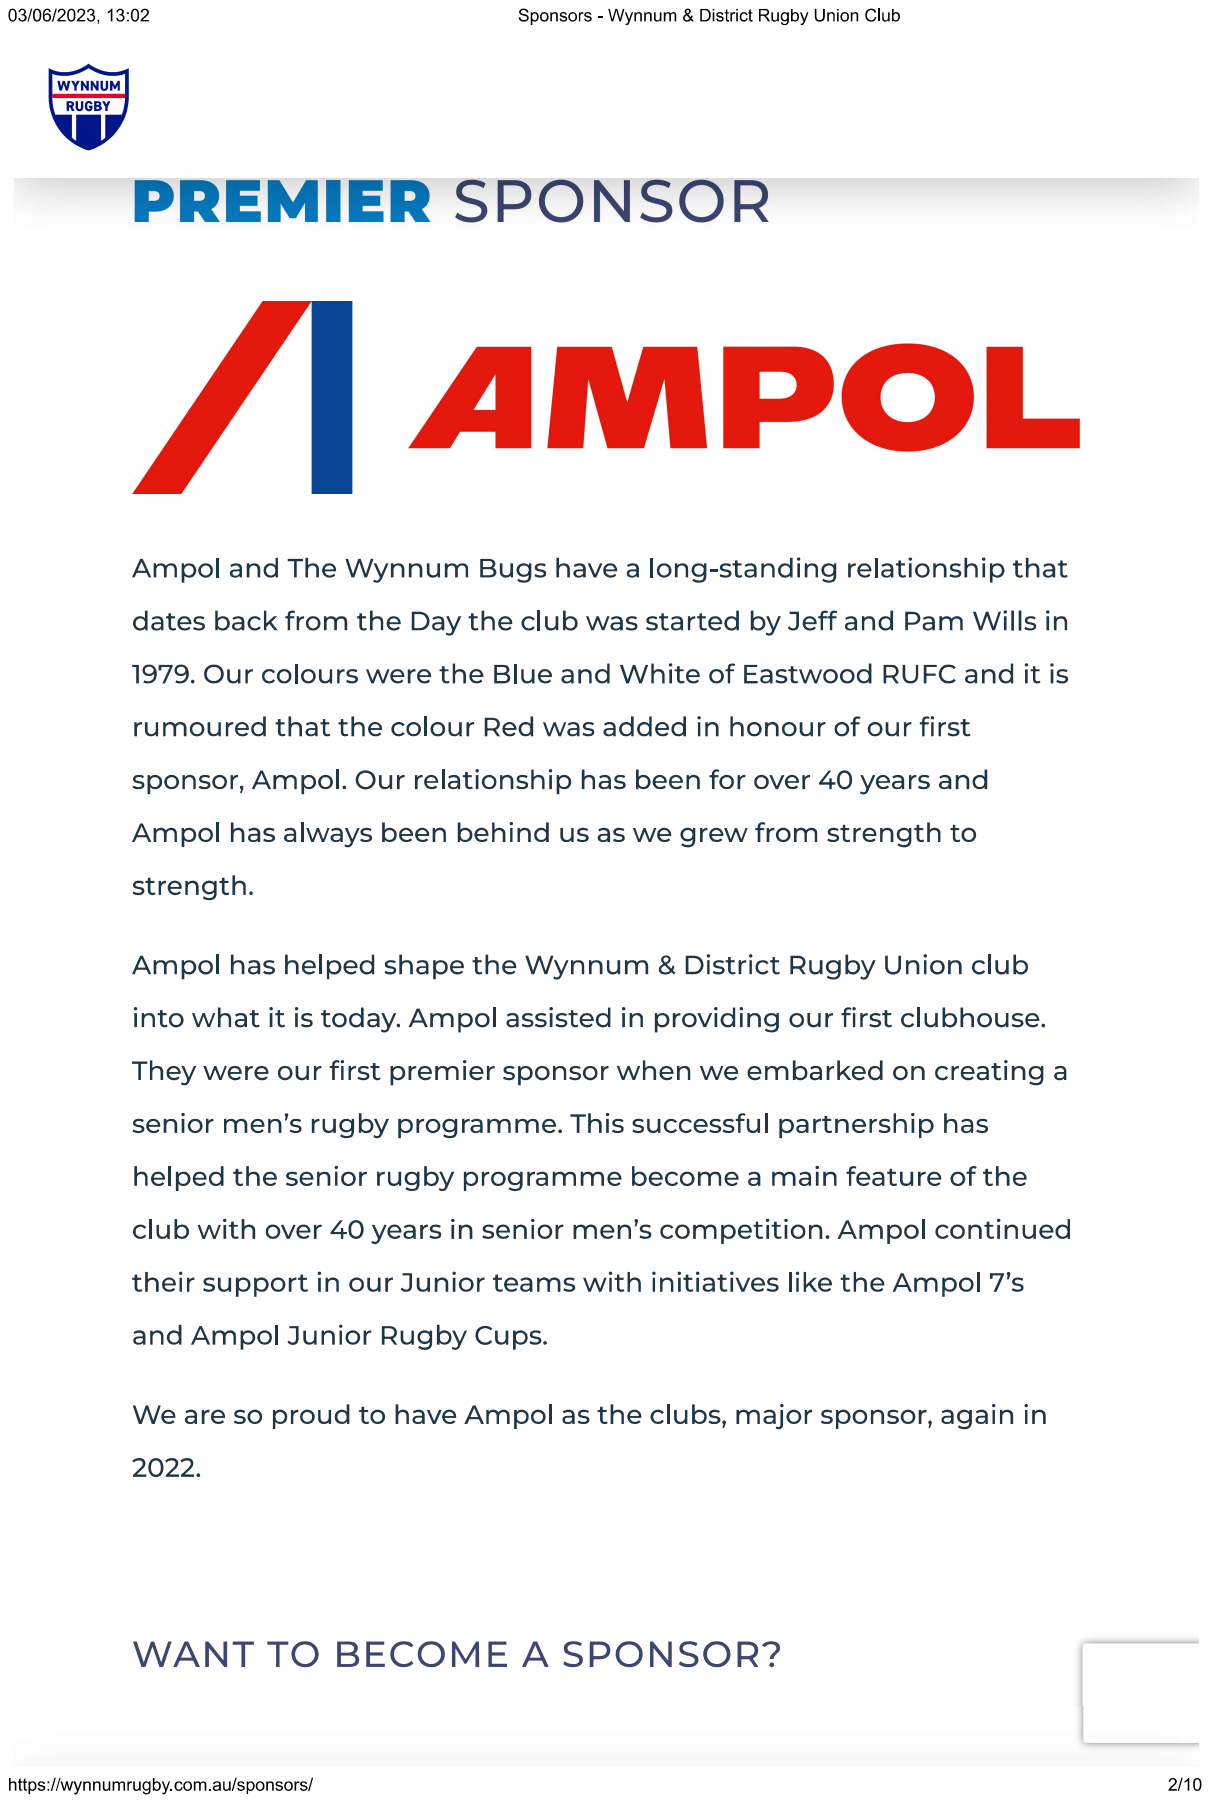
[picture p175: page 2]

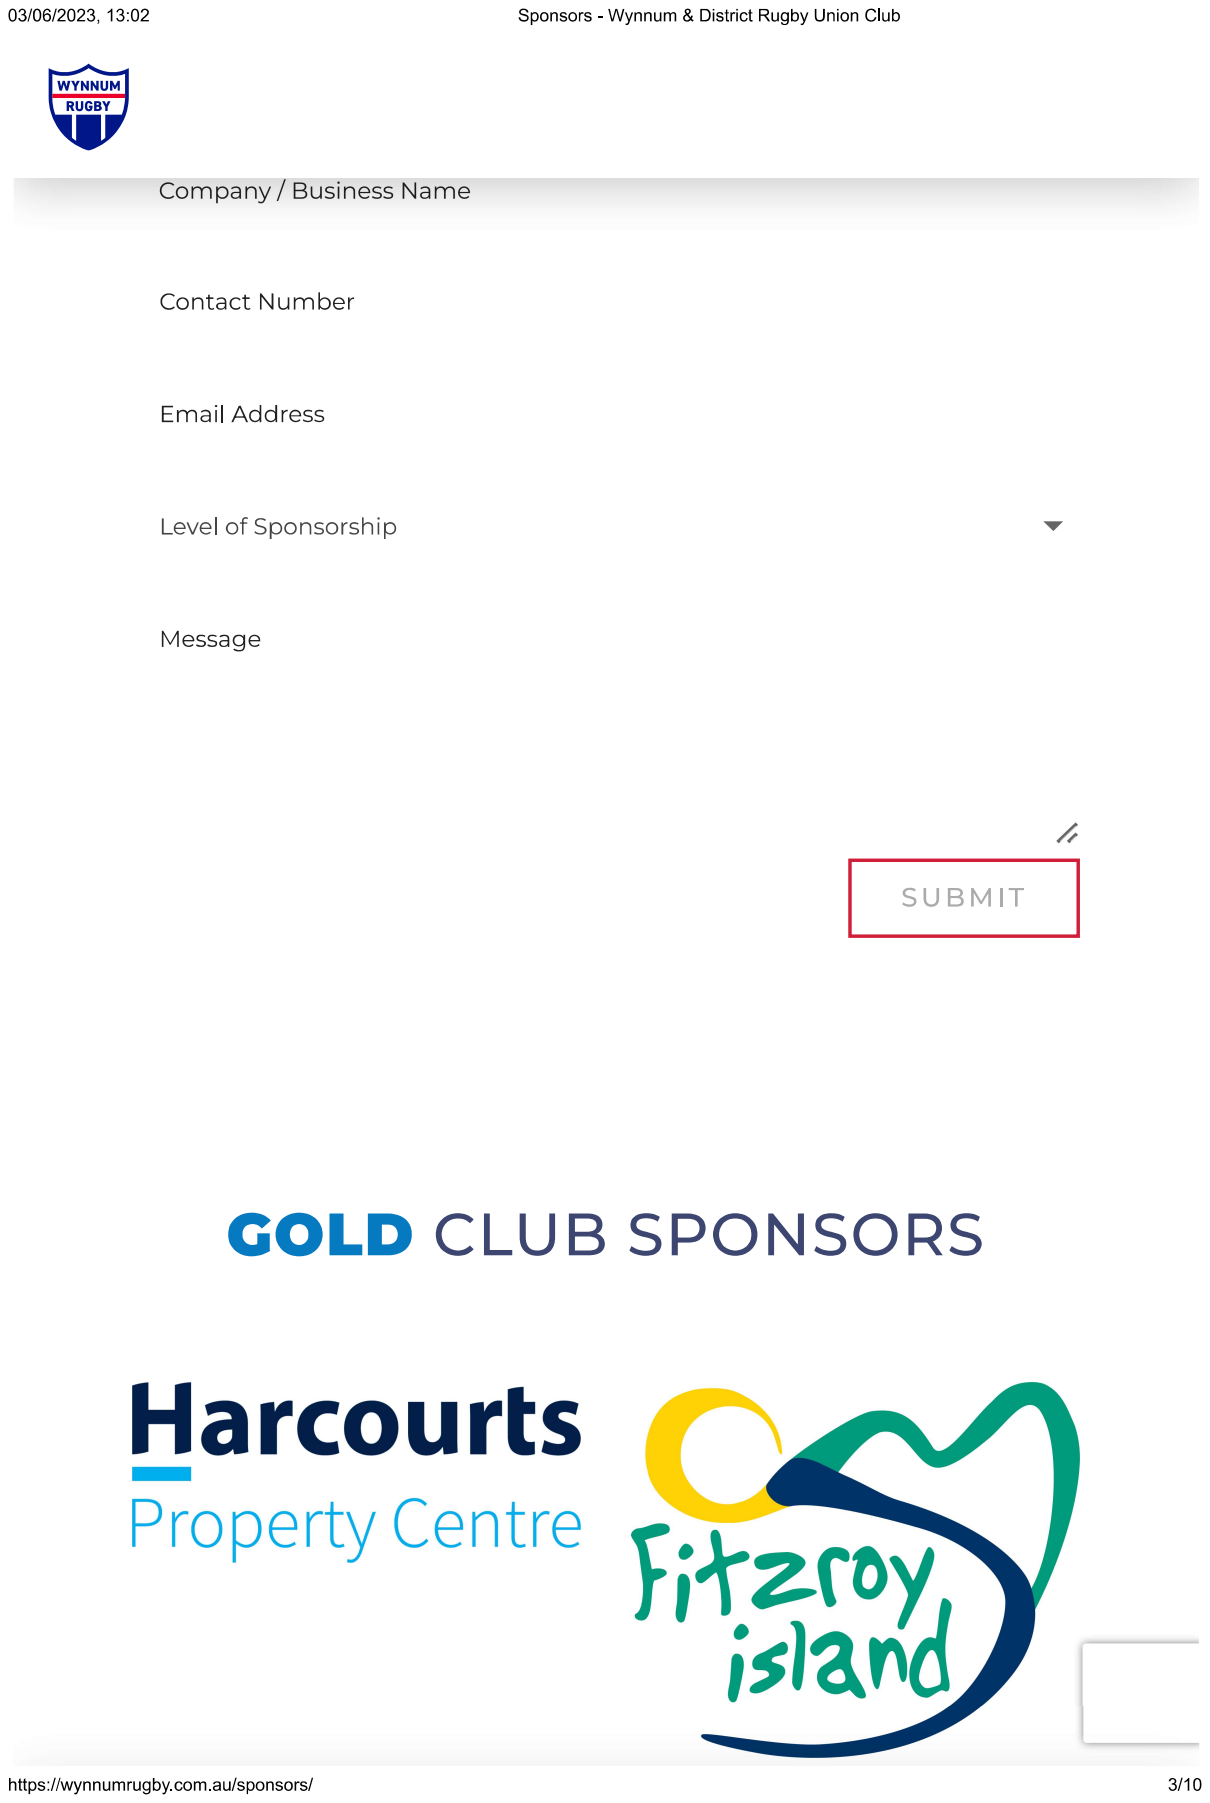
[picture p176: page 3]

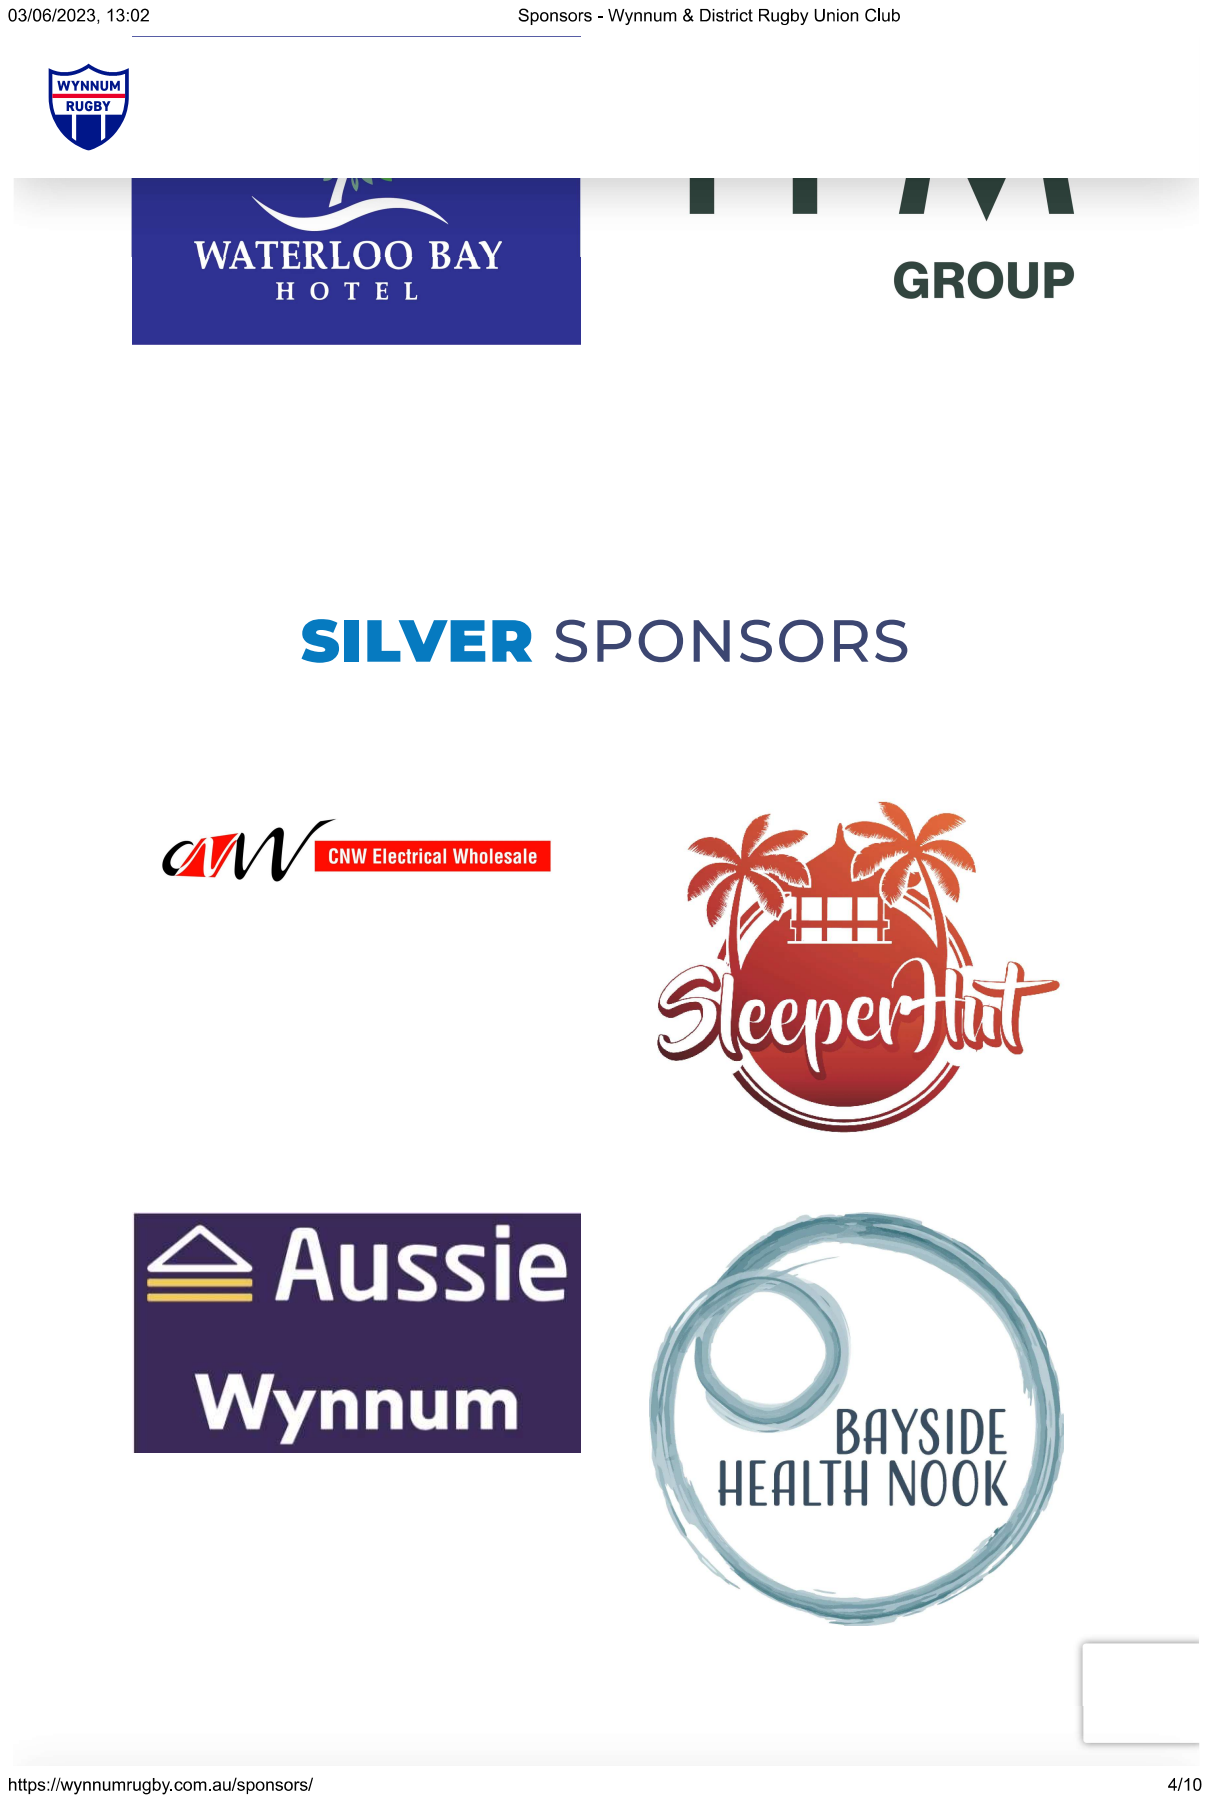
[picture p177: page 4]

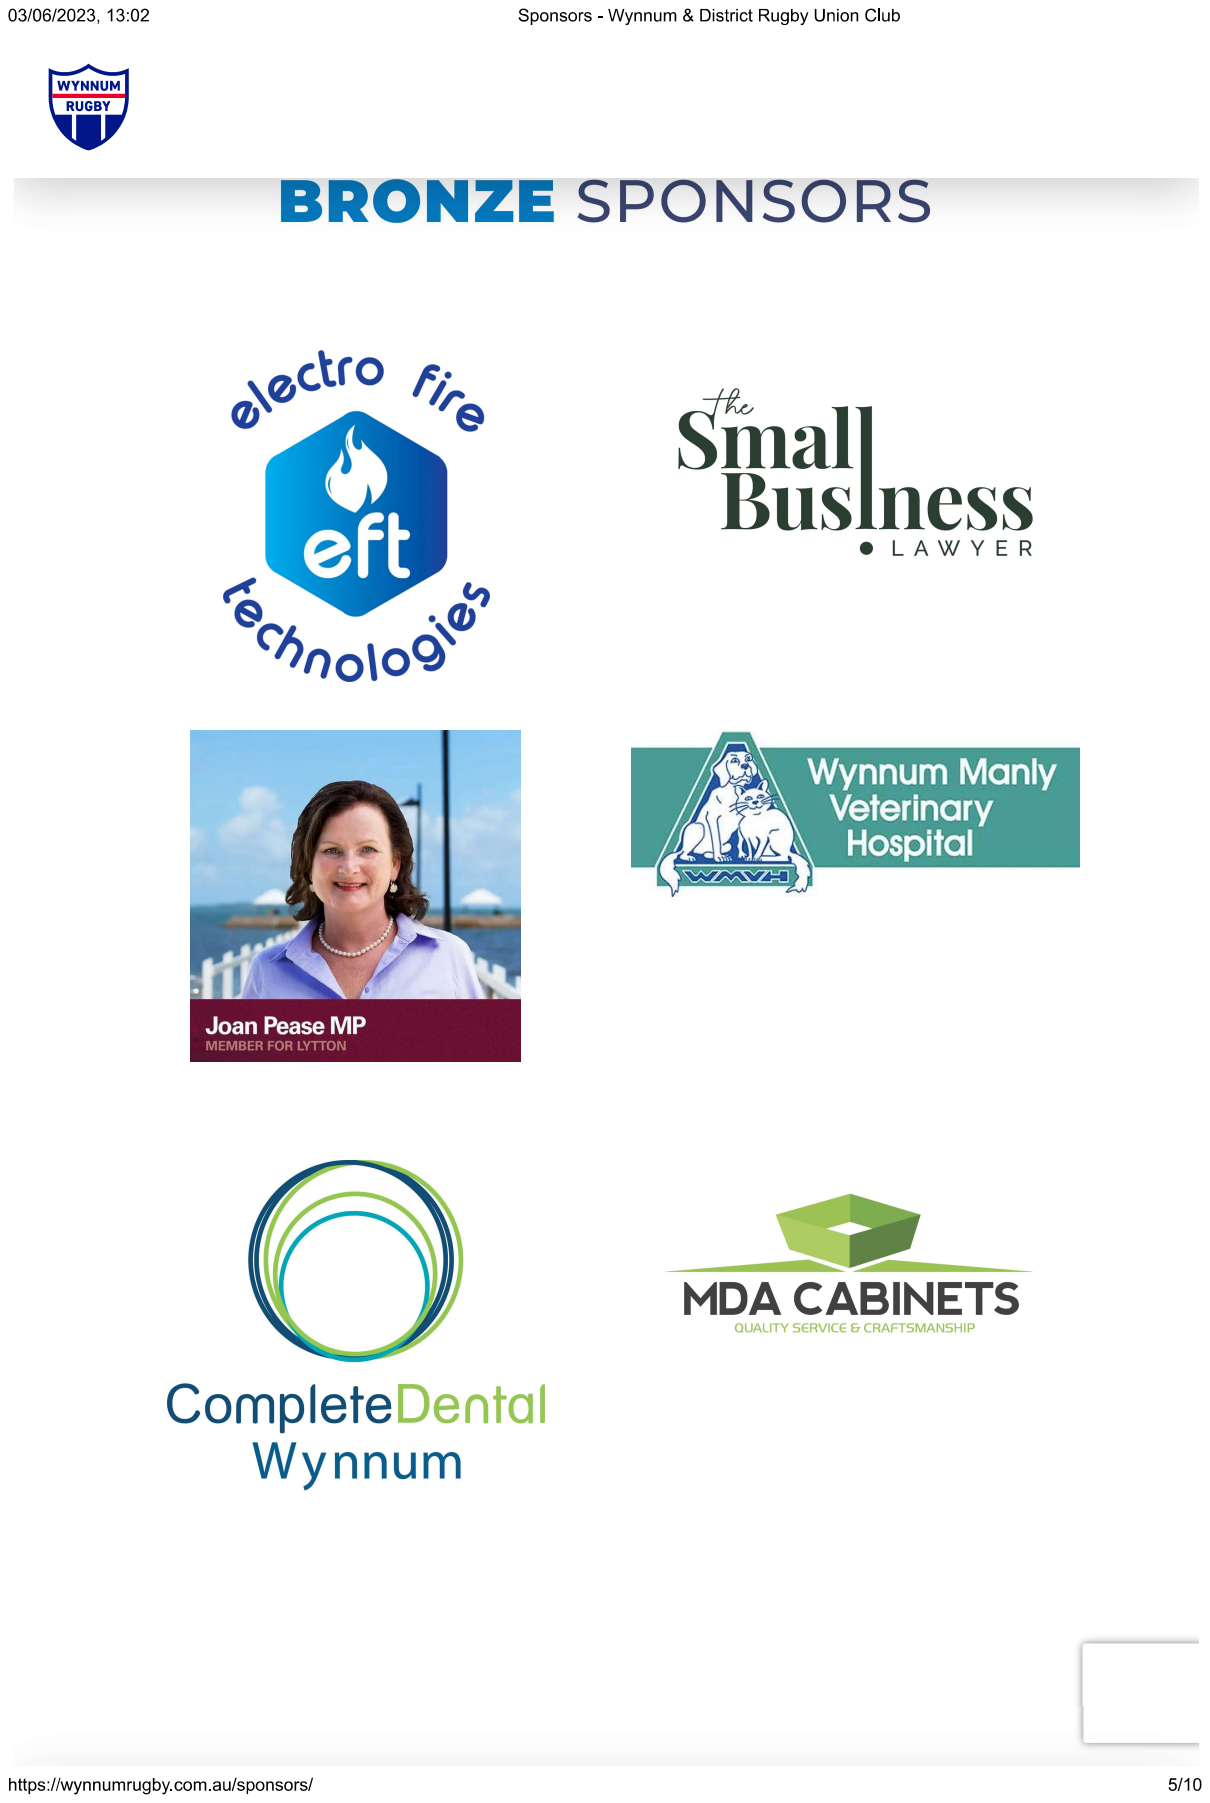
[picture p178: page 5]

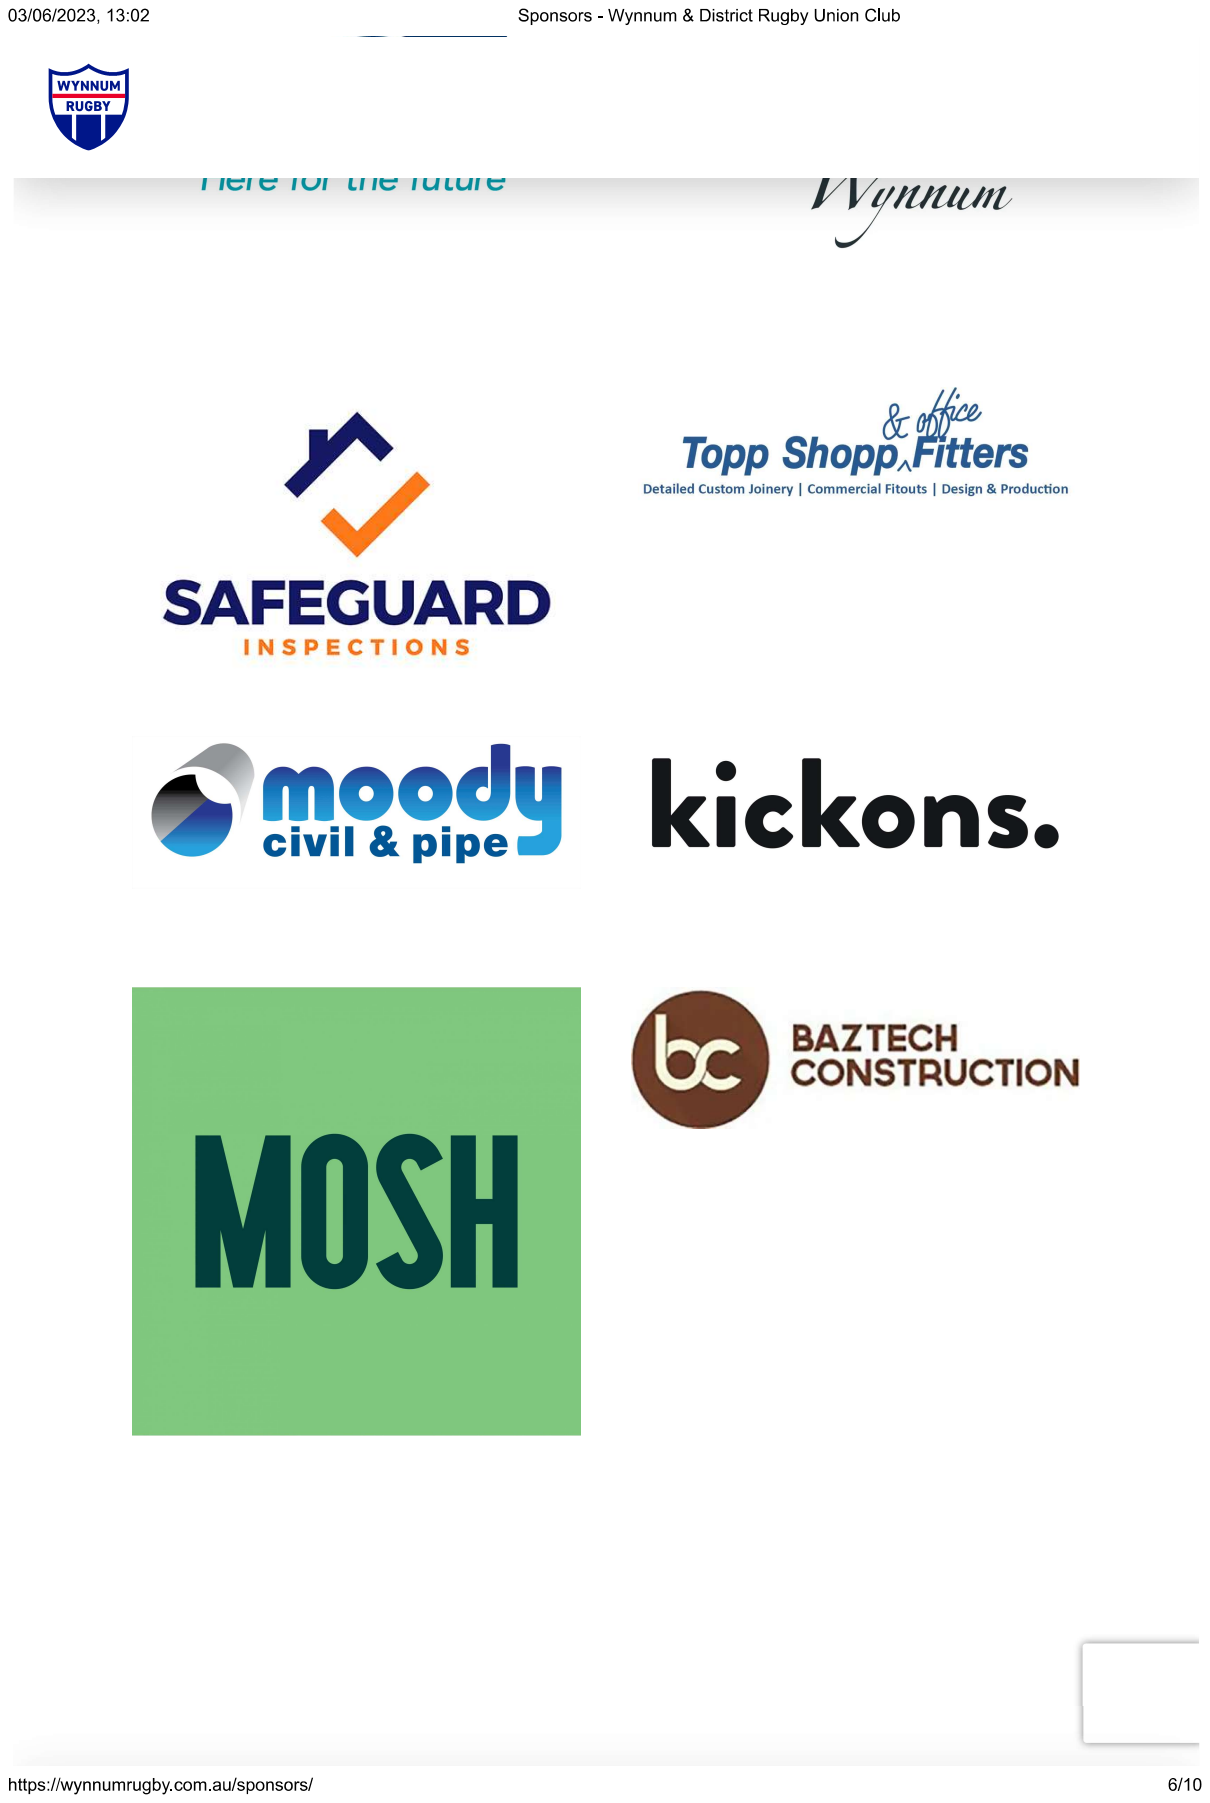
[picture p179: page 6]

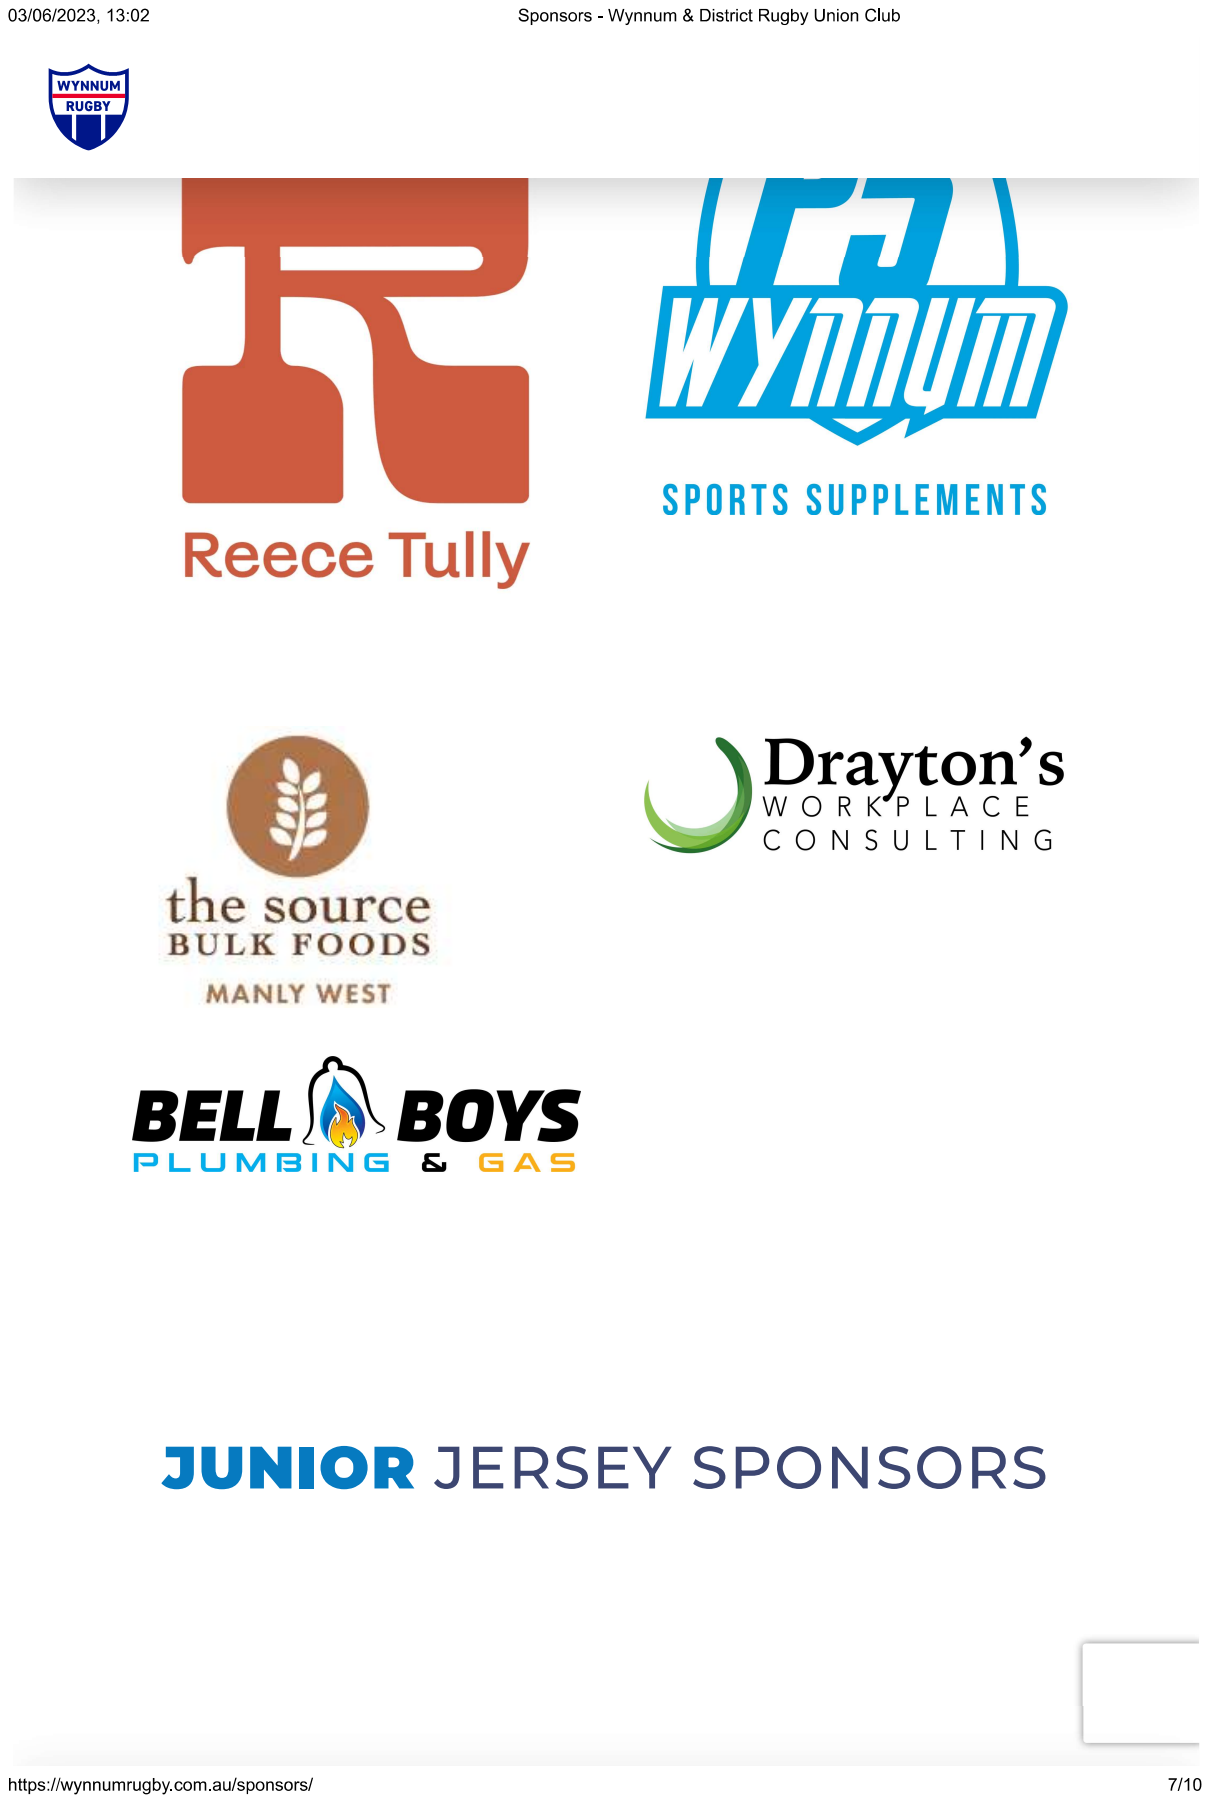
[picture p180: page 7]

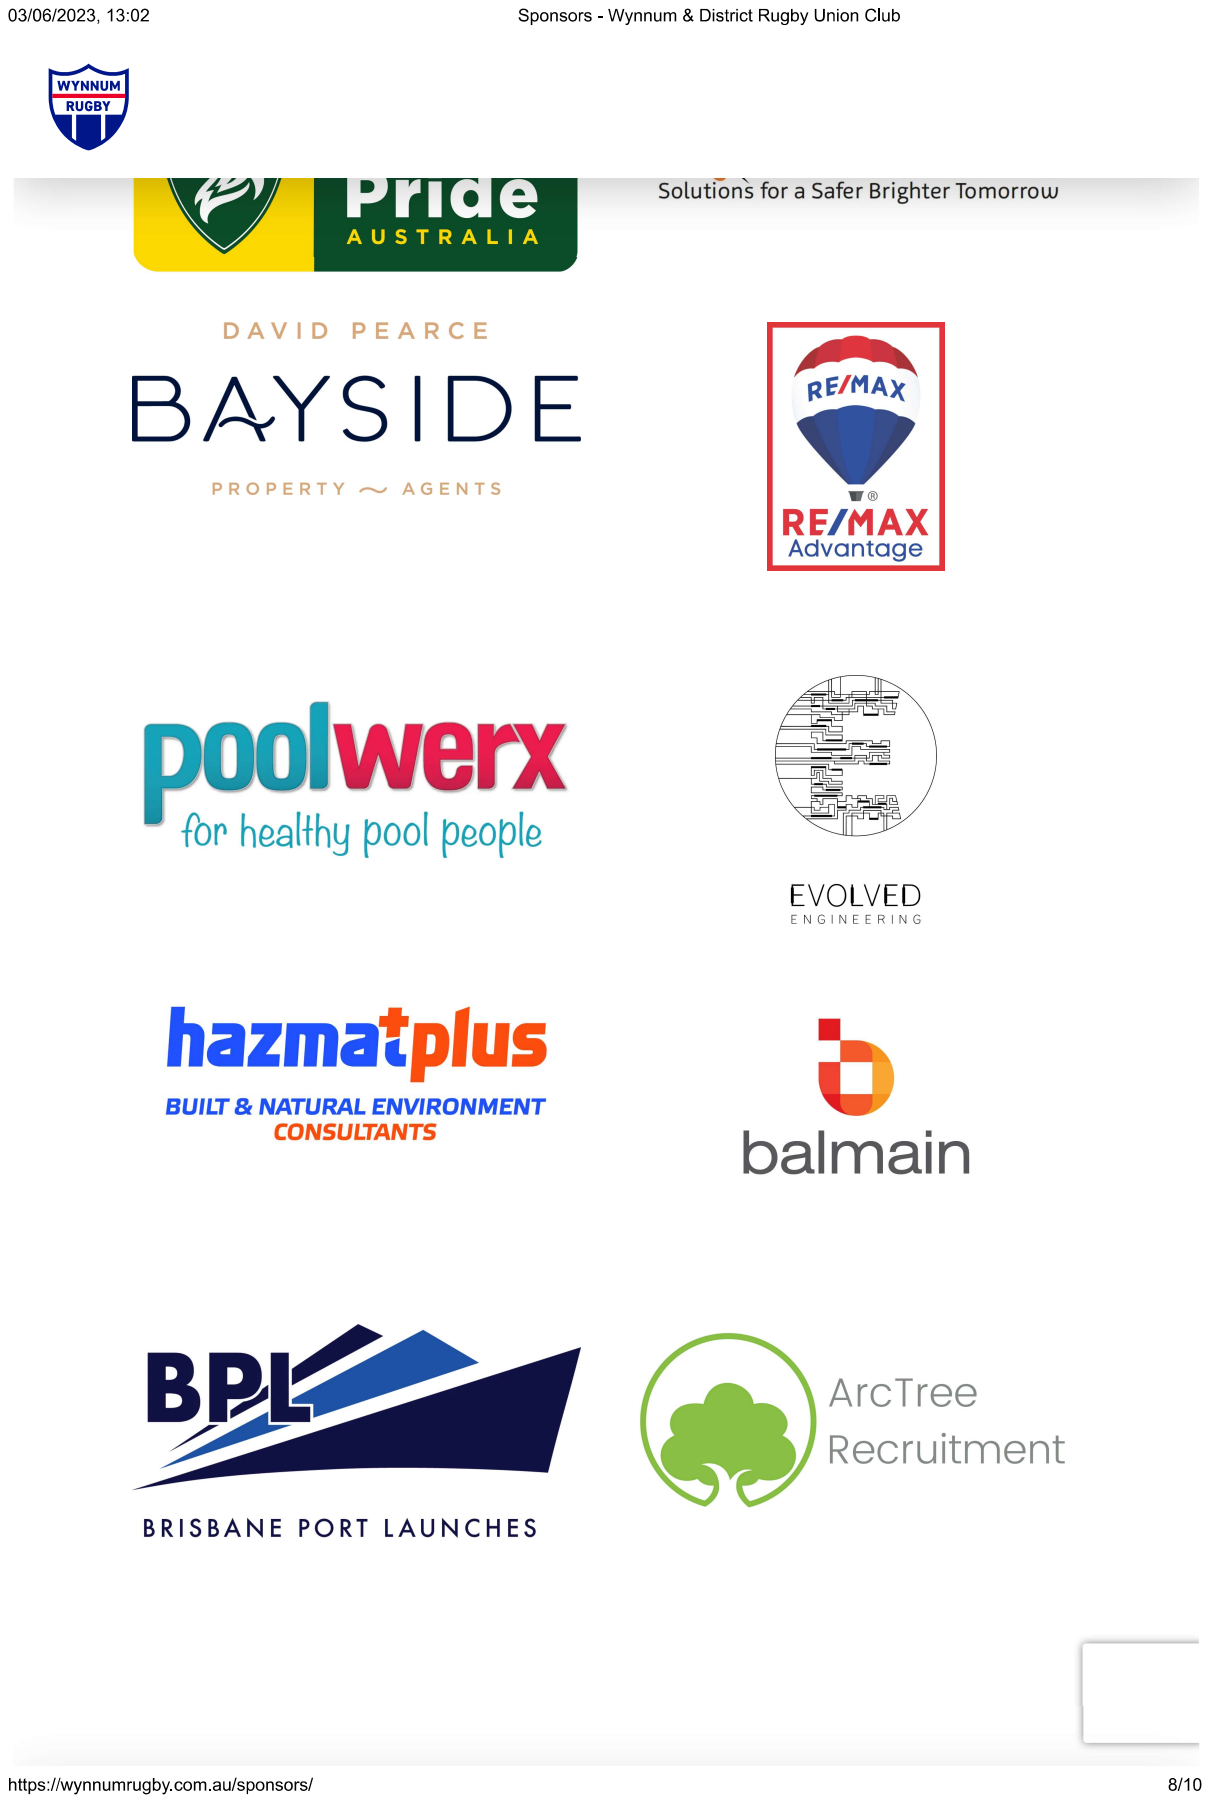
[picture p181: page 8]

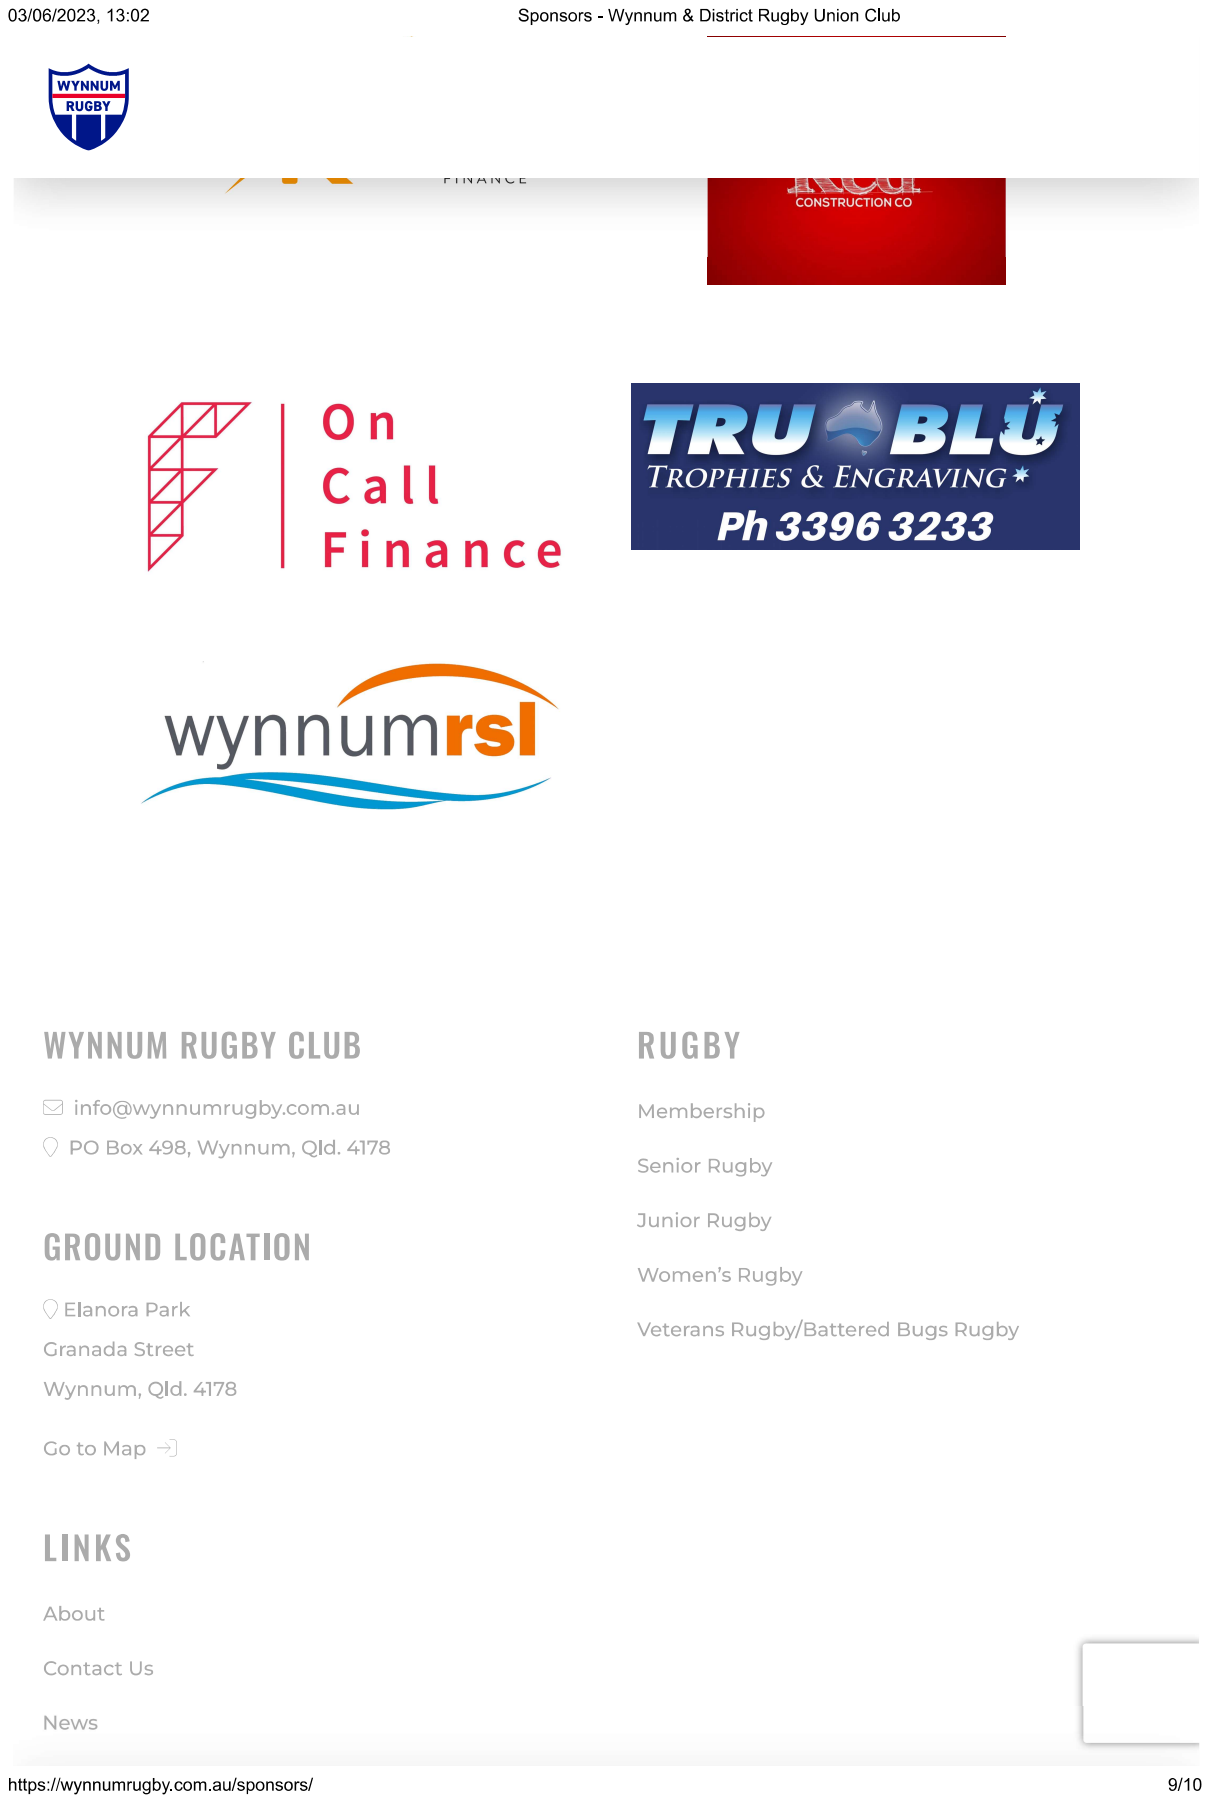
[picture p182: page 9]

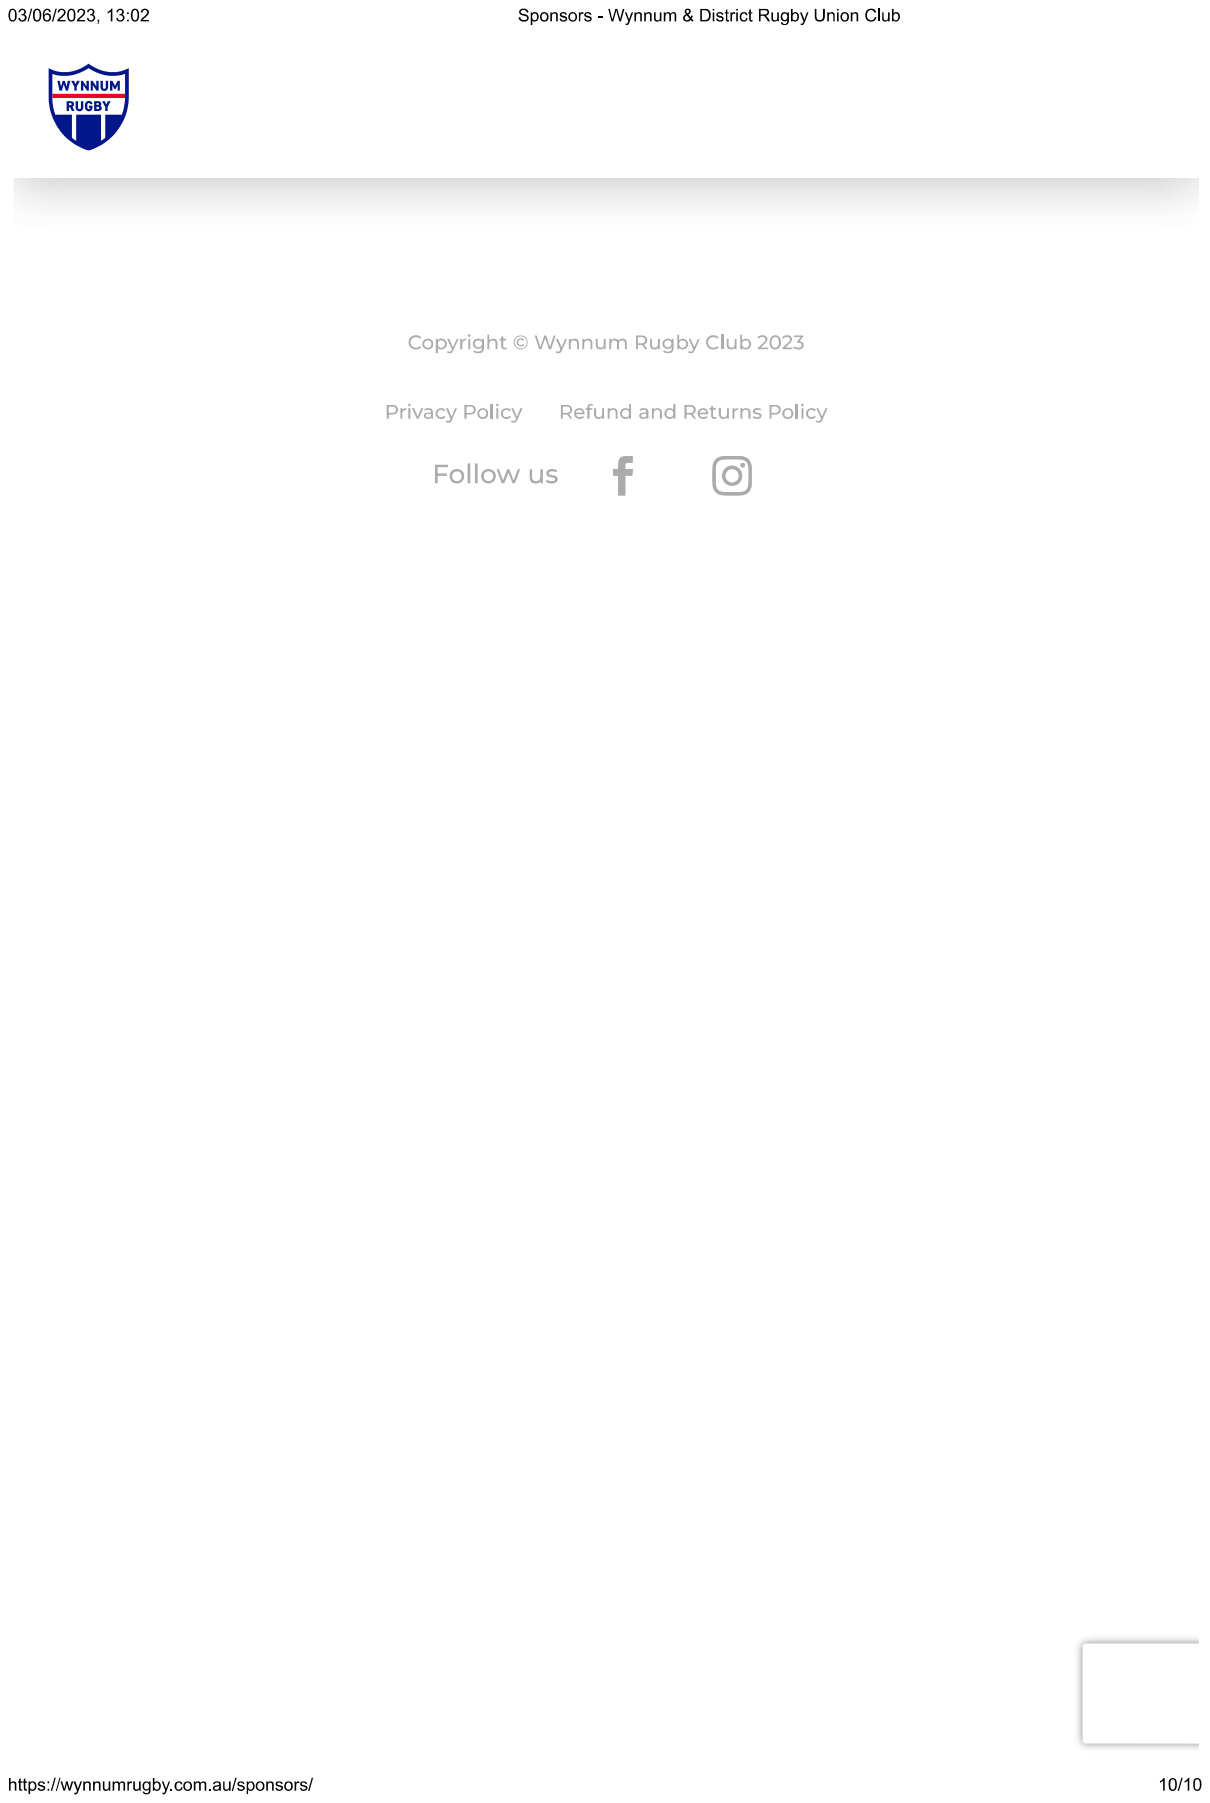
[picture p183: page 10]
