dhskinner/Scoreboard/Sponsors/2018_Season/Logos/AHL_Wynnum_33968000_2017_Inline_Purple_WSY.pdf

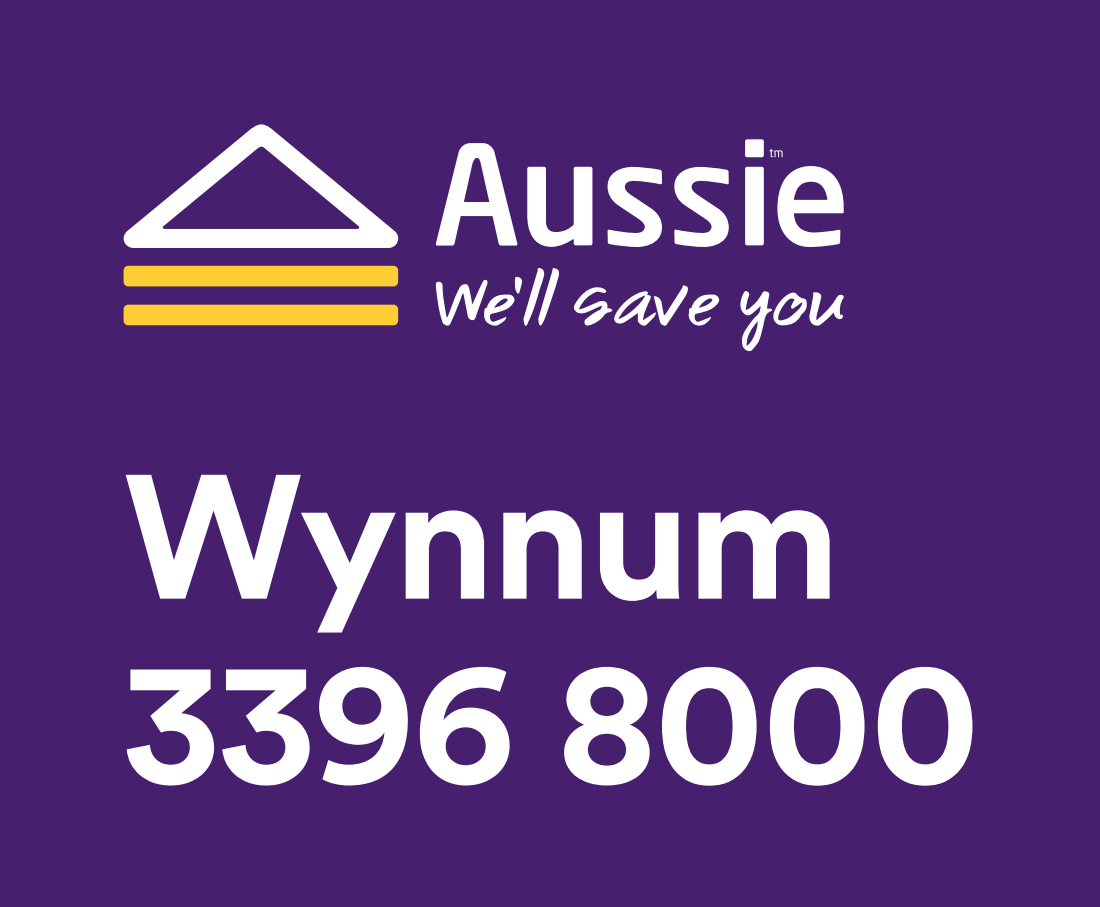
[picture p184: page 1]
Wynnum 3396 8000
