dhskinner/Scoreboard/Sponsors/2018_Season/Logos/Baywest Logo Recreate v2 (002).pdf

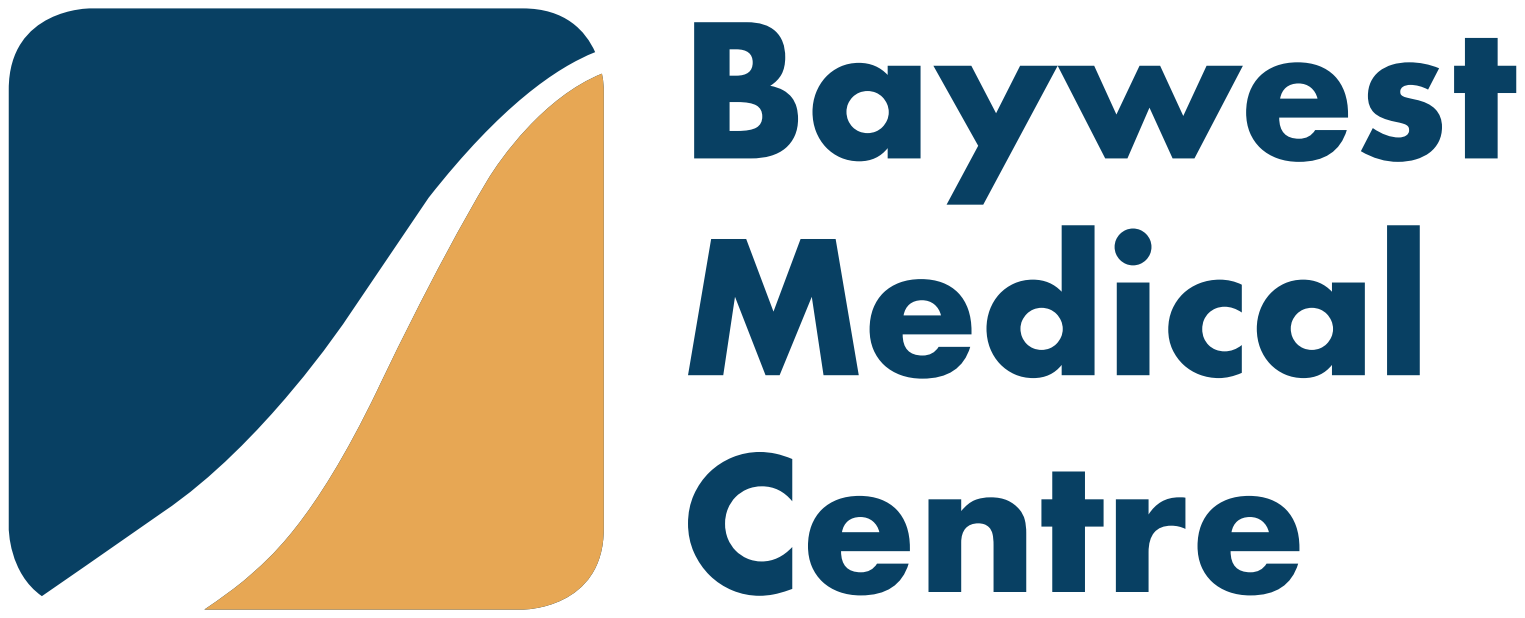
[picture p185: page 1]
