dhskinner/Scoreboard/Sponsors/2018_Season/Logos/fitzroyIslandLogo-spot.pdf

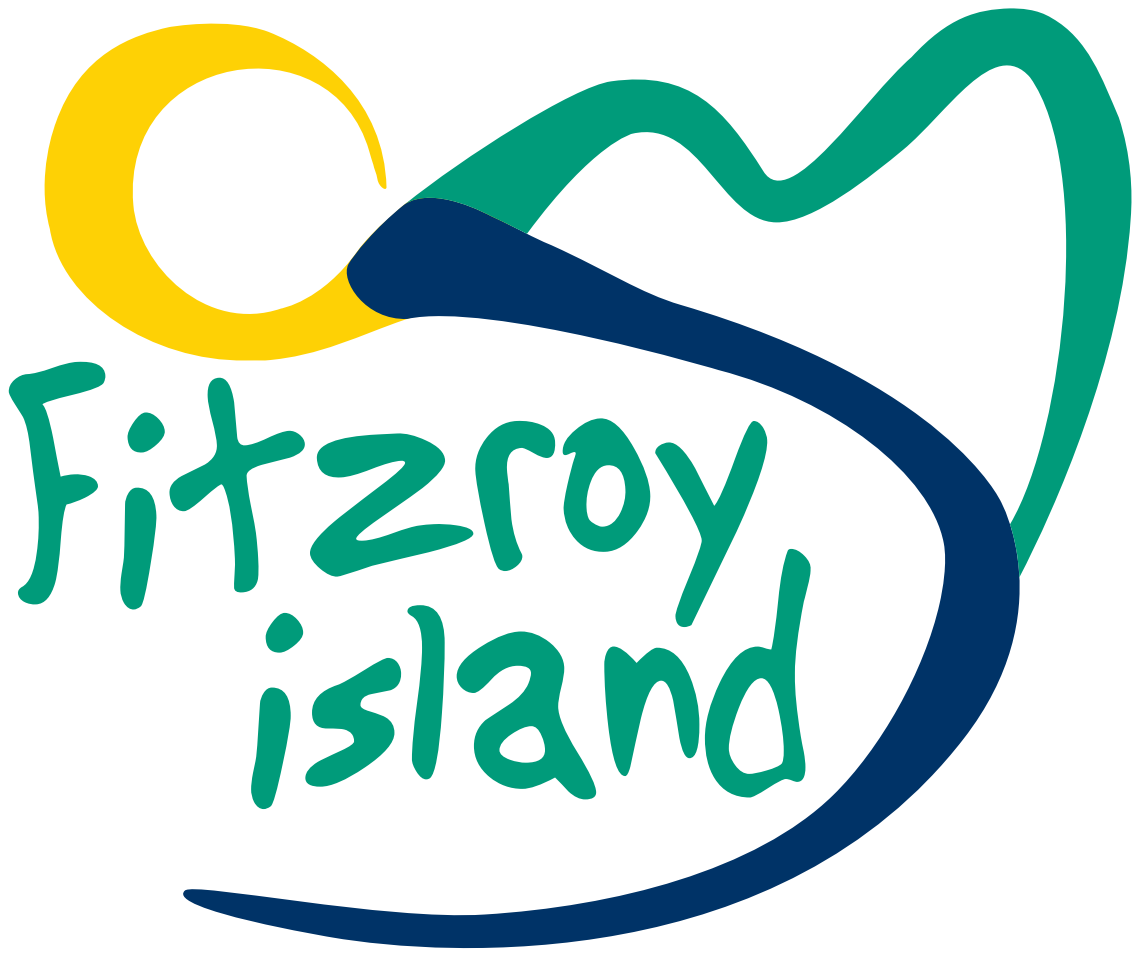
[picture p186: page 1]
