dhskinner/Scoreboard/Sponsors/2018_Season/Logos/Mini Pump.pdf

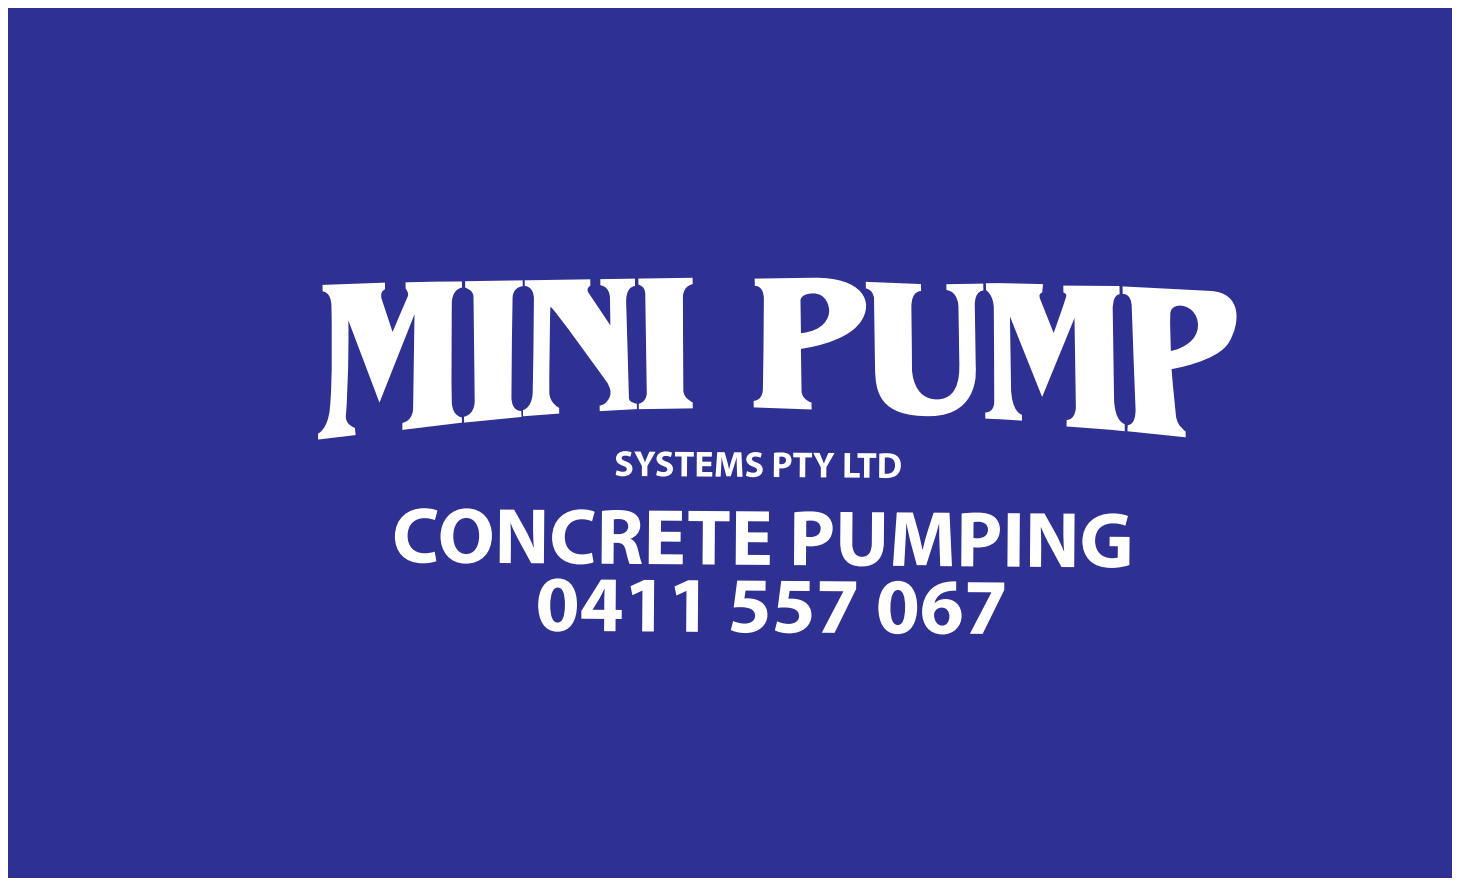
[picture p187: page 1]
