dhskinner/Scoreboard/Sponsors/2018_Season/Logos/SSSigns-SignageSolutions.pdf

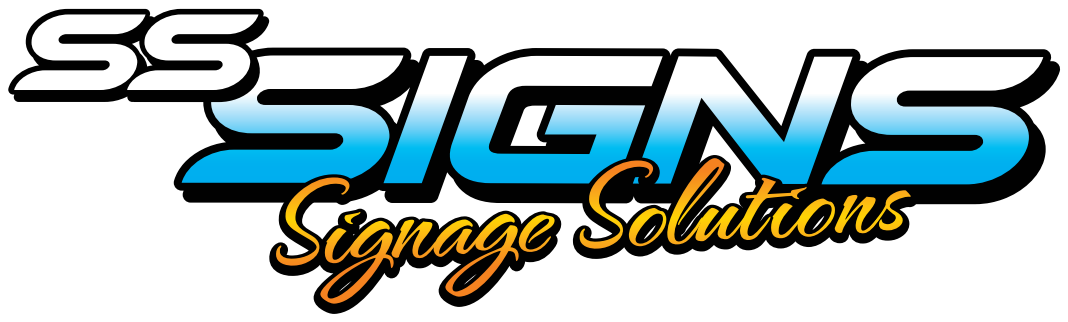
[picture p188: page 1]
