dhskinner/Scoreboard/Design/Eagle/Scoreboard Wifi Controller 20170514.brd

## EAGLE design Design/Eagle/Scoreboard Wifi Controller 20170514.brd (2017-08-03)

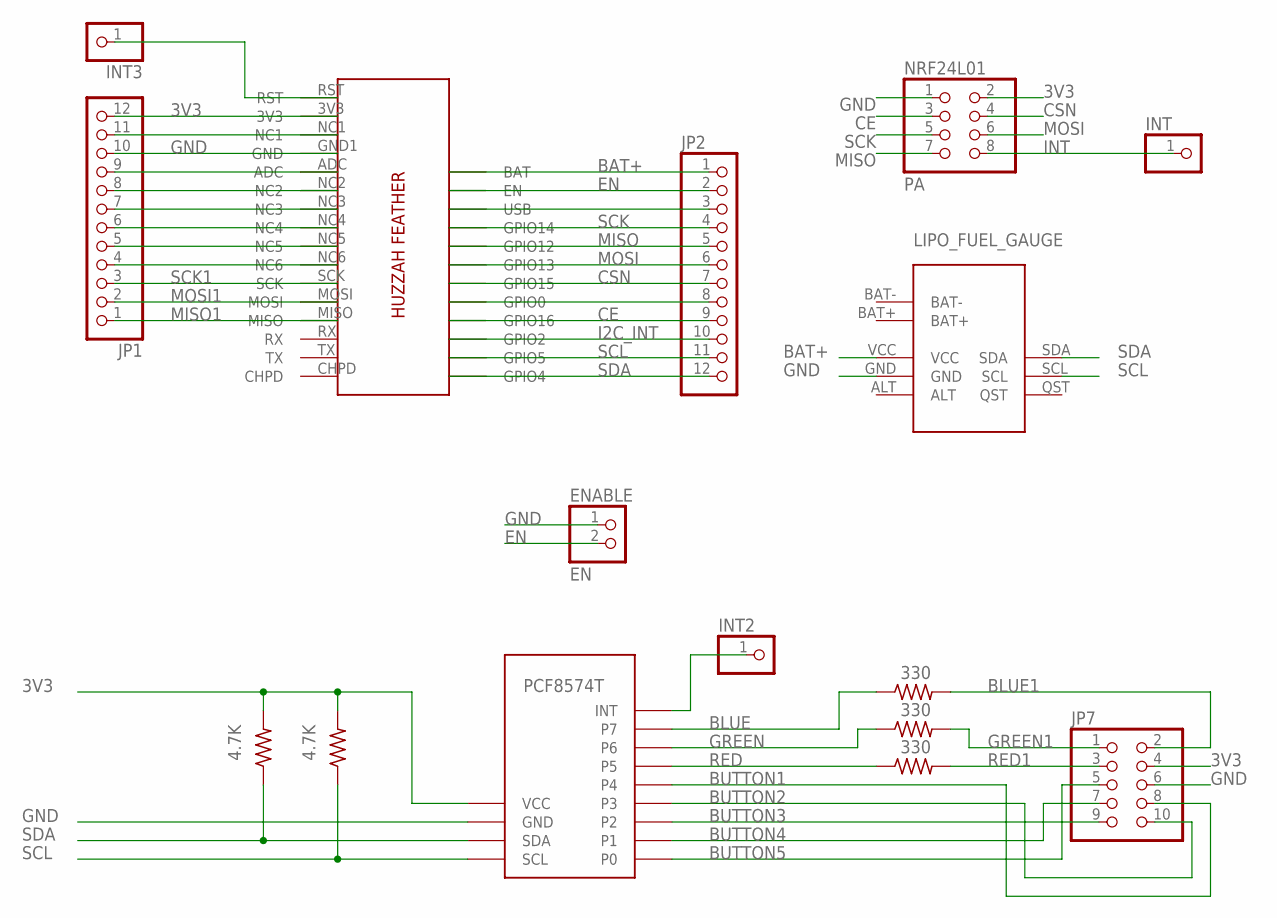
[picture p189: schematic Scoreboard Wifi Controller 20170514.sch]

Parts:
ENABLE: EN; 1X02/90
INT, INT2, INT3: PINHD-1X1CB; 1X01-CLEANBIG
JP1, JP2: PINHD-1X12-CB; 1X12-CB
JP7: PINHD-2X5/90; 2X05/90
LIPO_FUEL_GAUGE: LIPO_FUEL_GAUGE
NRF24L01: PA; 2X04/90
R2, R3, R4: 330; 0207/10
R5, R6: 4.7K; 0207/10
U$1: ADAFRUIT-FEATHER-ESP8266-HUZZAHALT; ADAFRUIT-FEATHER-ESP8266-HUZZAH-ALT
U$3: PCF8574T_IO_EXPANDER

Connections:
3V3: JP1.12, JP7.4, NRF24L01.2, R5.2, R6.2, U$1.3V3, U$3.VCC
BAT+: JP2.1, LIPO_FUEL_GAUGE.VCC, U$1.BAT
BLUE: R2.1, U$3.P$7 (P7)
BLUE1: JP7.2, R2.2
BUTTON1: JP7.8, U$3.P$4 (P4)
BUTTON2: JP7.10, U$3.P$3 (P3)
BUTTON3: JP7.9, U$3.P$2 (P2)
BUTTON4: JP7.7, U$3.P$1 (P1)
BUTTON5: JP7.5, U$3.P$0 (P0)
CE: JP2.9, NRF24L01.3, U$1.GPIO16
CSN: JP2.7, NRF24L01.4, U$1.GPIO15
EN: ENABLE.2, JP2.2, U$1.EN
GND: ENABLE.1, JP1.10, JP7.6, LIPO_FUEL_GAUGE.GND, NRF24L01.1, U$1.GND1 (GND), U$3.GND
GREEN: R3.1, U$3.P$6 (P6)
GREEN1: JP7.1, R3.2
I2C_INT: INT2.1, JP2.10, U$1.GPIO2, U$3.INT
INT: INT.1, NRF24L01.8
MISO: JP2.5, NRF24L01.7, U$1.GPIO12
MISO1: JP1.1, U$1.MISO
MOSI: JP2.6, NRF24L01.6, U$1.GPIO13
MOSI1: JP1.2, U$1.MOSI
unnamed: JP1.9, U$1.ADC
unnamed: JP2.8, U$1.GPIO0
unnamed: JP2.3, U$1.USB
unnamed: JP1.8, U$1.NC2
unnamed: JP1.7, U$1.NC3
unnamed: JP1.6, U$1.NC4
unnamed: JP1.5, U$1.NC5
unnamed: JP1.4, U$1.NC6
unnamed: JP1.11, U$1.NC1
RED: R4.1, U$3.P$5 (P5)
RED1: JP7.3, R4.2
RST: INT3.1, U$1.RST
SCK: JP2.4, NRF24L01.5, U$1.GPIO14
SCK1: JP1.3, U$1.SCK
SCL: JP2.11, LIPO_FUEL_GAUGE.SCL, R5.1, U$1.GPIO5, U$3.SCL
SDA: JP2.12, LIPO_FUEL_GAUGE.SDA, R6.1, U$1.GPIO4, U$3.SDA

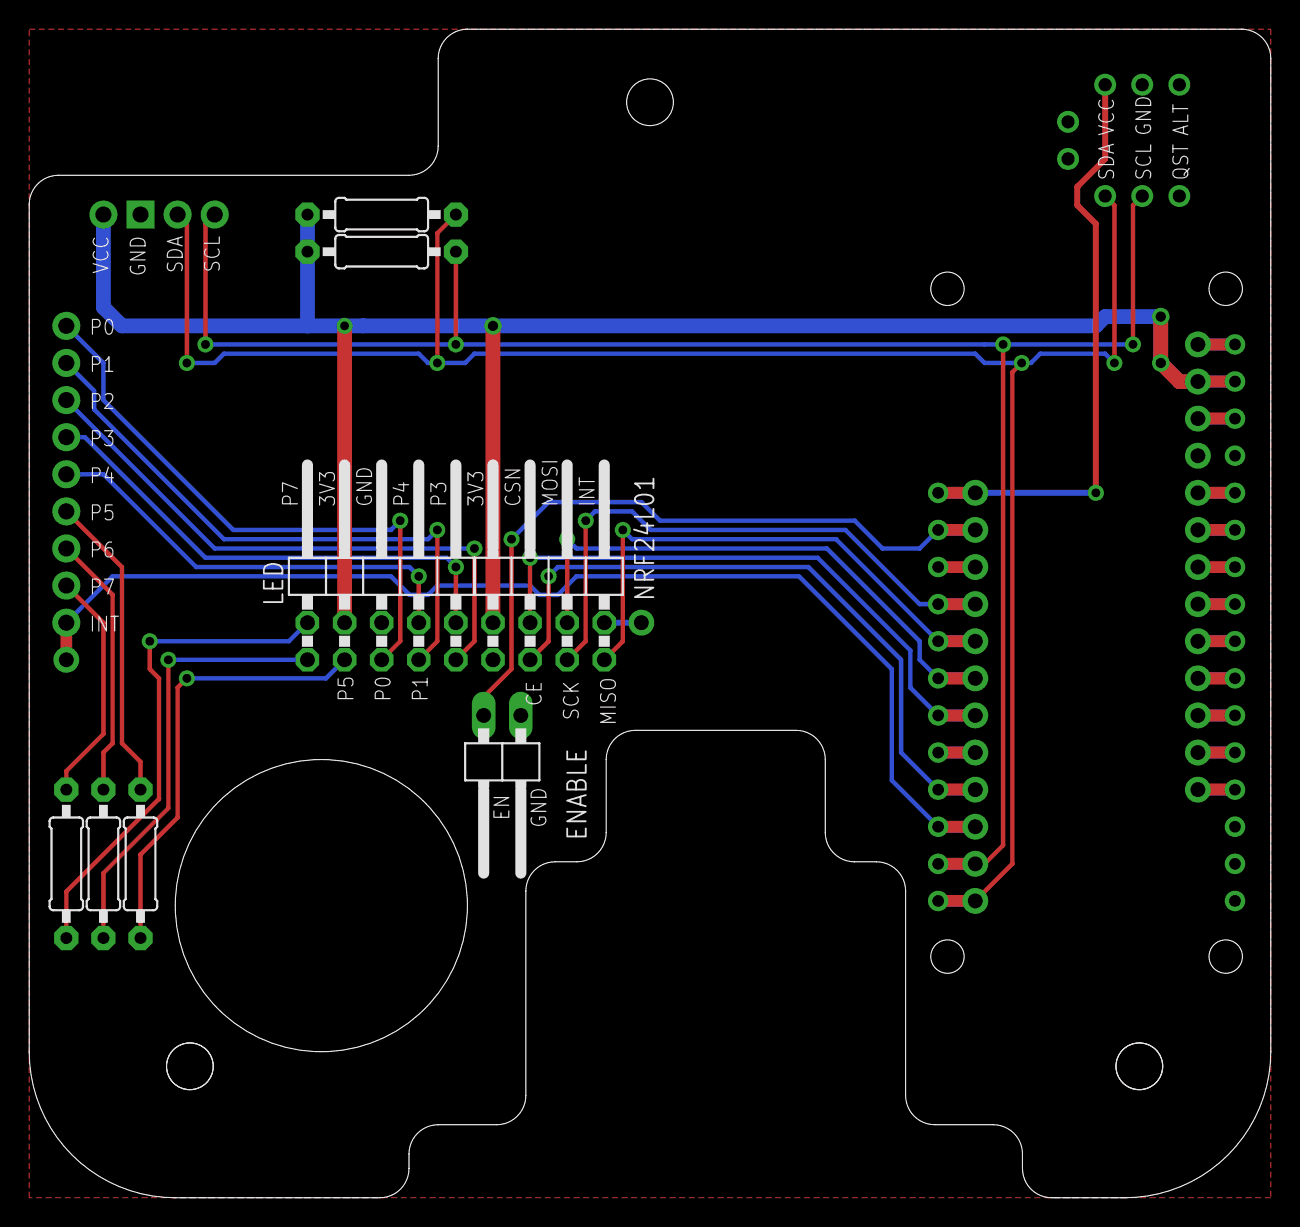
[picture p190: board Scoreboard Wifi Controller 20170514.brd from above]

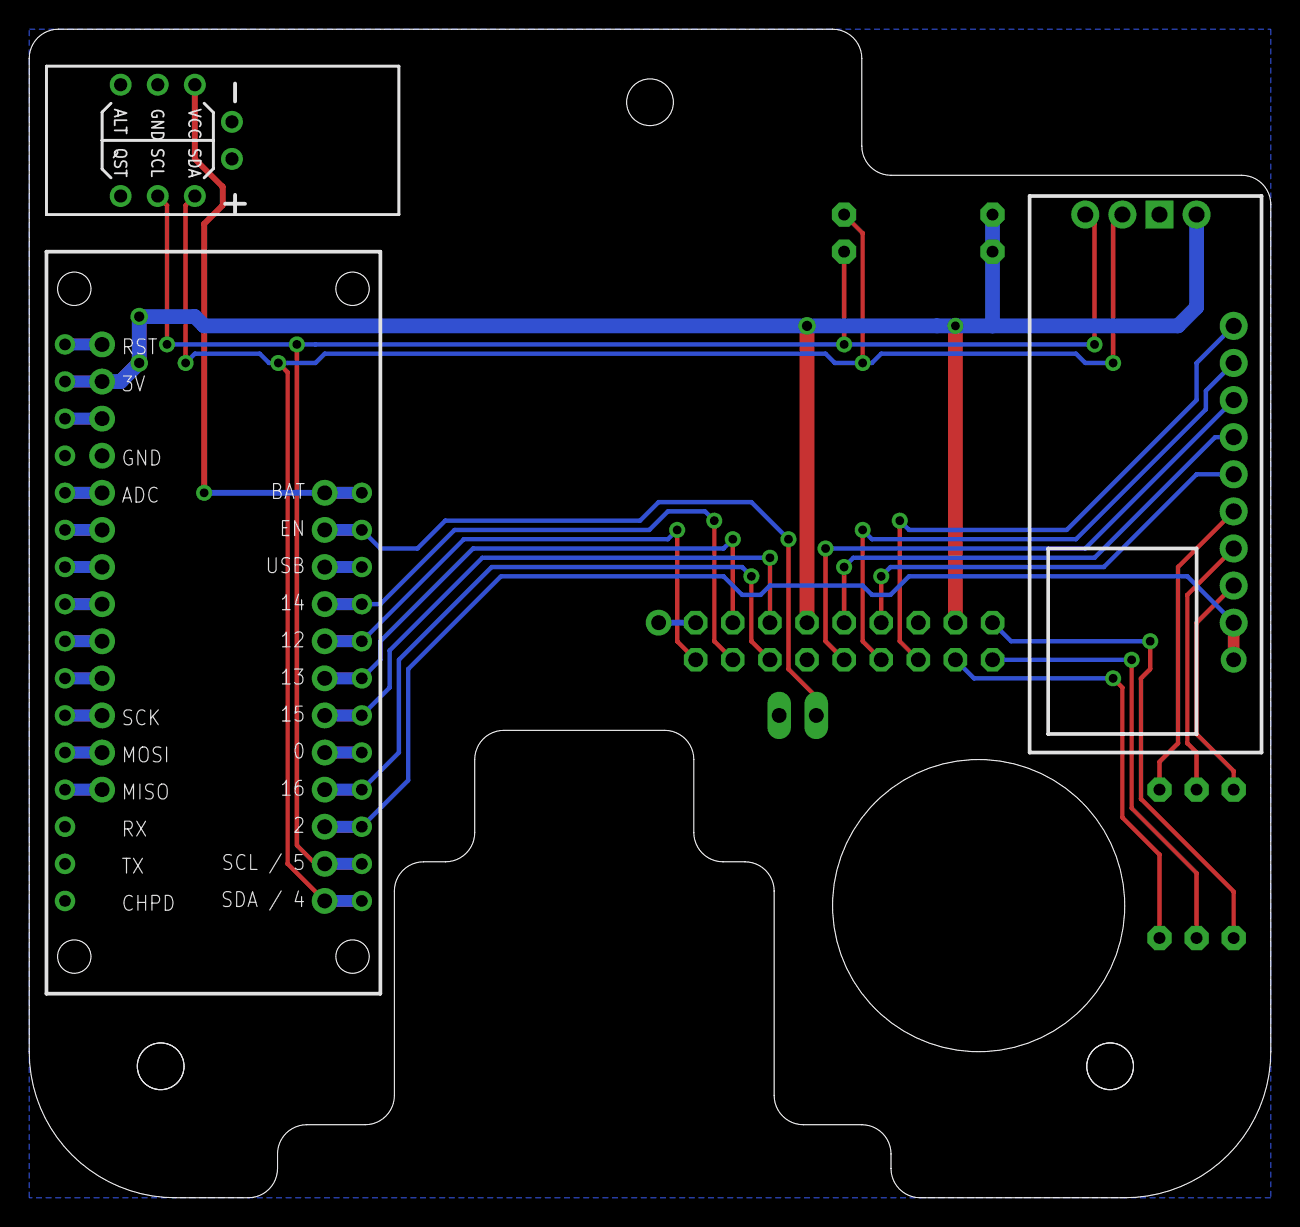
[picture p191: board Scoreboard Wifi Controller 20170514.brd from below]

Board: 2 copper layers, 85.0 x 80.0 mm, 16 parts (3 on the bottom side), 37 nets.
