dhskinner/Scoreboard/Design/Eagle/Scoreboard Module 20150702.brd

## EAGLE design Design/Eagle/Scoreboard Module 20150702.brd (2017-05-01)

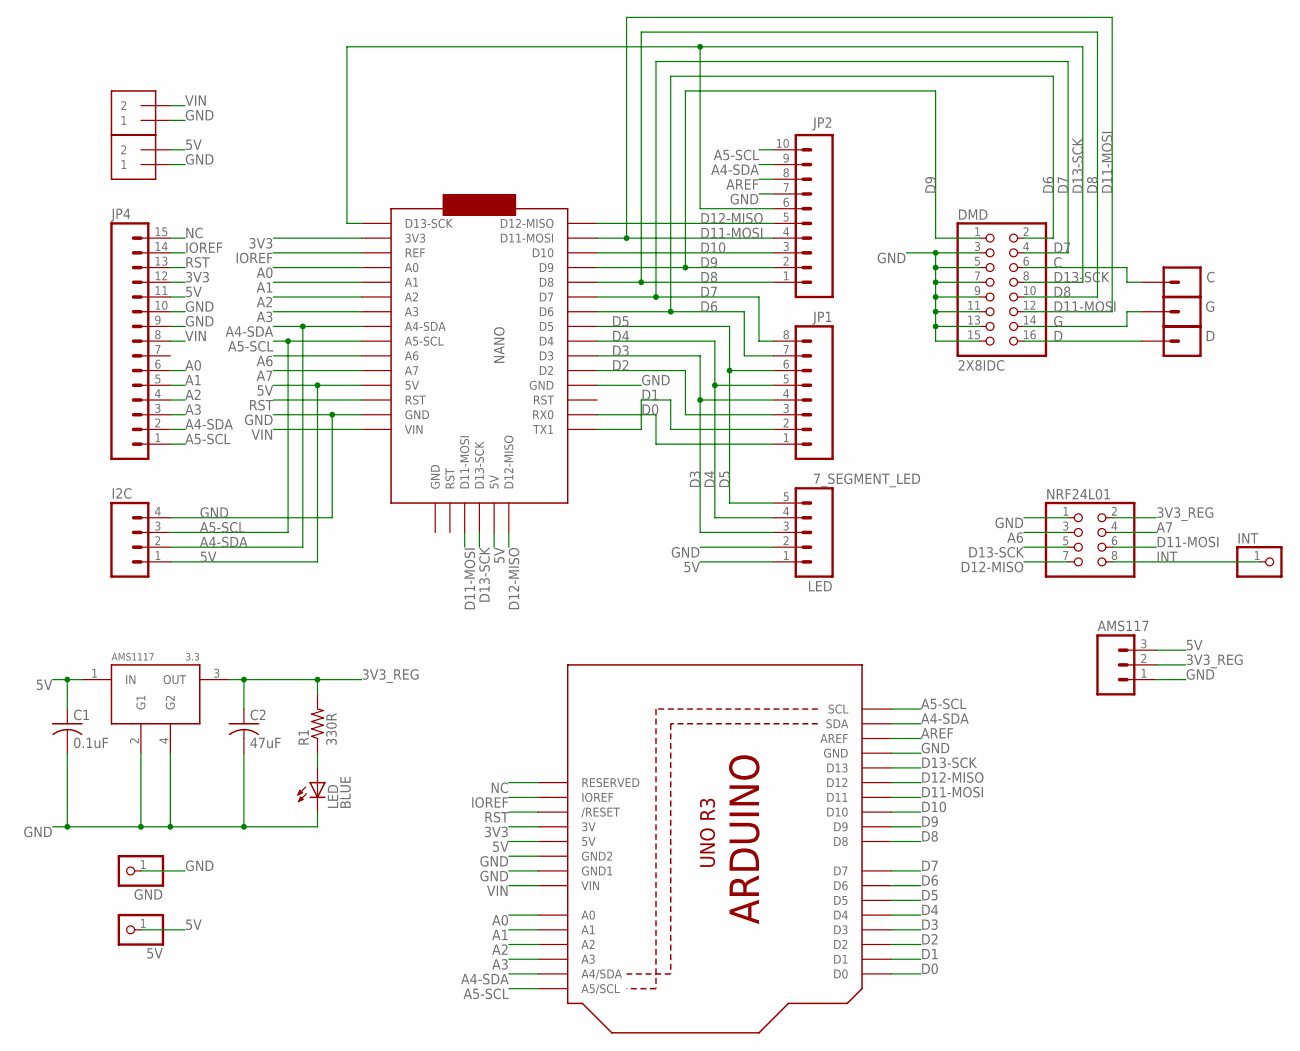
[picture p192: schematic Scoreboard Module 20150702.sch]

Parts:
5V: PINHD-1X1; 1X01
7_SEGMENT_LED: LED; 1X05
AMS117: M03PTH; 1X03
AMS1117: 3.3; SOT223
C: M01PTH; 1X01
C1: 0.1uF; C050-035X075
C2: 47uF; C050-035X075
D: M01PTH; 1X01
DMD: 2X8IDC; 2X08-IDC
G: M01PTH; 1X01
GND: PINHD-1X1; 1X01
I2C: M04PTH; 1X04
INT: PINHD-1X1; 1X01
J1, J2: 1X2-3.5MM
JP1: M08SILK_FEMALE_PTH; 1X08
JP2: M10SILK_FEMALE_PTH; 1X10
JP4: M15; 1X15
LED: BLUE; LED3MM
NANO: ARDUINO_NANOICSP; ARDUINO_NANO
NRF24L01: PINHD-2X4; 2X04
R1: 330R; 0204/7
U2: ARDUINOR3-MOVEDTEXT

Connections:
3V3: JP4.12, NANO.P$17 (3V3), U2.3V
3V3_REG: AMS117.2, AMS1117.3 (OUT), C2.1, NRF24L01.2, R1.2
5V: 5V.1, 7_SEGMENT_LED.1, AMS117.3, AMS1117.1 (IN), C1.1, I2C.1, J1.2, JP4.11, NANO.ICSP$2 (5V), NANO.P$27 (5V), U2.5V
A0: JP4.6, NANO.P$19 (A0), U2.A0
A1: JP4.5, NANO.P$20 (A1), U2.A1
A2: JP4.4, NANO.P$21 (A2), U2.A2
A3: JP4.3, NANO.P$22 (A3), U2.A3
A4-SDA: I2C.2, JP2.9, JP4.2, NANO.P$23 (A4-SDA), U2.A4 (A4/SDA), U2.SDA
A5-SCL: I2C.3, JP2.10, JP4.1, NANO.P$24 (A5-SCL), U2.A5 (A5/SCL), U2.SCL
A6: NANO.P$25 (A6), NRF24L01.3
A7: NANO.P$26 (A7), NRF24L01.4
AREF: JP2.8, U2.AREF
C: C.1, DMD.6
D: D.1, DMD.16
D0: JP1.1, NANO.P$2 (RX0), U2.D0
D1: JP1.2, NANO.P$1 (TX1), U2.D1
D2: JP1.3, NANO.P$5 (D2), U2.D2
D3: 7_SEGMENT_LED.3, JP1.4, NANO.P$6 (D3), U2.D3
D4: 7_SEGMENT_LED.4, JP1.5, NANO.P$7 (D4), U2.D4
D5: 7_SEGMENT_LED.5, JP1.6, NANO.P$8 (D5), U2.D5
D6: DMD.2, JP1.7, NANO.P$9 (D6), U2.D6
D7: DMD.4, JP1.8, NANO.P$10 (D7), U2.D7
D8: DMD.10, JP2.1, NANO.P$11 (D8), U2.D8
D9: DMD.1, JP2.2, NANO.P$12 (D9), U2.D9
D10: JP2.3, NANO.P$13 (D10), U2.D10
D11-MOSI: DMD.12, JP2.4, NANO.ICSP$4 (D11-MOSI), NANO.P$14 (D11-MOSI), NRF24L01.6, U2.D11
D12-MISO: JP2.5, NANO.ICSP$1 (D12-MISO), NANO.P$15 (D12-MISO), NRF24L01.7, U2.D12
D13-SCK: DMD.8, JP2.6, NANO.ICSP$3 (D13-SCK), NANO.P$16 (D13-SCK), NRF24L01.5, U2.D13
G: DMD.14, G.1
GND: 7_SEGMENT_LED.2, AMS117.1, AMS1117.2 (G1), AMS1117.4 (G2), C1.2, C2.2, DMD.3, DMD.5, DMD.7, DMD.9, DMD.11, DMD.13, DMD.15, GND.1, I2C.4, J1.1, J2.1, JP2.7, JP4.9, JP4.10, LED.K (C), NANO.P$4 (GND), NANO.P$29 (GND), NRF24L01.1, U2.GND, U2.GND1, U2.GND2
INT: INT.1, NRF24L01.8
IOREF: JP4.14, NANO.P$18 (REF), U2.IOREF
LED: LED.A, R1.1
NC: JP4.15, U2.RESERVED
RST: JP4.13, NANO.P$28 (RST), U2.RESET (/RESET)
VIN: J2.2, JP4.8, NANO.P$30 (VIN), U2.VIN

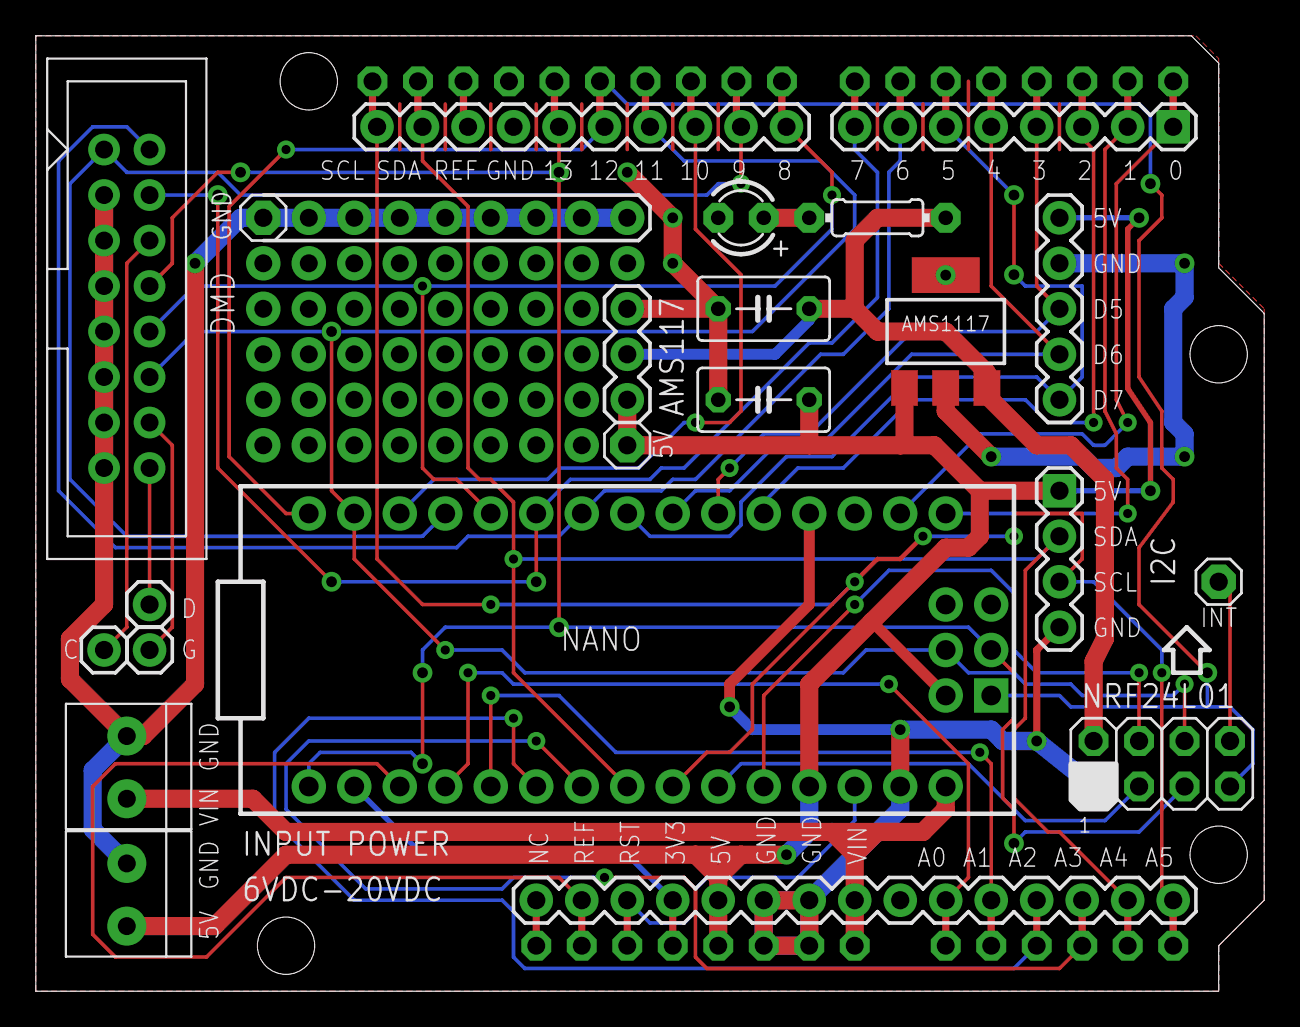
[picture p193: board Scoreboard Module 20150702.brd from above]

Board: 2 copper layers, 68.6 x 53.3 mm, 23 parts (0 on the bottom side), 36 nets.
