dhskinner/Scoreboard/Design/Firmware/Scoreboard_Firmware/ScoreboardLibrary/ScoreboardLibrary.ino

/*
 Name:		ScoreboardLibrary.ino
 Created:	7/31/2016 10:52:12 AM
 Author:	Dave
 Editor:	http://www.visualmicro.com
*/
// Set the scoreboard mode - refer to ScoreboardConfigs.h for options

#define SCOREBOARD_LIBRARY

#include <Scoreboard.h>

// the setup function runs once when you press reset or power the board
void setup() {

}

// the loop function runs over and over again until power down or reset
void loop() {
  
}
