dhskinner/Scoreboard/Sponsors/2020_Season/ExportedConfig/LedTW_Config/SysSetup.ini

[Transit_Service]
Controller_Port=6061
User_Port=6055
Server_IP=112.65.245.174
[Com_RF]
nSendUnit=400
nRealityReadWaitTimeOut=2500
DataLen=1024
nInputSize=400
nErrReSendTimes=2
nOutputSize=400
nSmartScanReadWaitTimeOut=1000
nPackageSleep=0
nComStopBits=0
nComParity=0
nComDataBits=3
nUnitSleepValue=500
[Com]
nSendUnit=128
nRealityReadWaitTimeOut=2000
DataLen=1024
nInputSize=40960
nErrReSendTimes=2
nOutputSize=40960
nSmartScanReadWaitTimeOut=1000
nPackageSleep=0
nUnitSleepValue=0
nComStopBits=0
nComParity=0
nComDataBits=3
[Main]
MsgSeq=1
Reserved1=0;
ProtecolType=0
DeviceType=0
Reserved2=0;
PHYType=0
SrcAddr=32768
DstAddr=1
ProtocolVer=0
[Static_Net]
nSendUnit=1400
DataLen=600
nErrReSendTimes=3
nSmartScanReadWaitTimeOut=1000
nPackageSleep=0
nUnitSleepValue=0
nRealityReadWaitTimeOut=5000
[Static_Net_Adv]
nSendUnit=32768
DataLen=16384
nErrReSendTimes=3
nSmartScanReadWaitTimeOut=1000
nUnitSleepValue=1
nRealityReadWaitTimeOut=5000
nPackageSleep=0
[Transit_Net]
nSendUnit=1400
DataLen=700
nSmartScanReadWaitTimeOut=1000
nPackageSleep=0
nUnitSleepValue=500
nErrReSendTimes=3
nRealityReadWaitTimeOut=40000
[BX-GPRS]
nRealityReadWaitTimeOut=40000
DataLen=700
nErrReSendTimes=3
nPackageSleep=0
nSmartScanReadWaitTimeOut=10000
