dhskinner/Scoreboard/Design/Firmware/Scoreboard_Firmware/Scoreboard_V4/NUMERAL44x24.h

/*
 *
 * NUMERAL44X28
 *
 * created with FontCreator
 * written by F. Maximilian Thiele
 *
 * http://www.apetech.de/fontCreator
 * me@apetech.de
 *
 * File Name           : NUMERAL44x24.h
 * Date                : 18.08.2015
 * Font size in bytes  : 10048
 * Font width          : 28
 * Font height         : 44
 * Font first char     : 48
 * Font last char      : 58
 * Font used chars     : 10
 *
 * The font data are defined as
 *
 * struct _FONT_ {
 *     uint16_t   font_Size_in_Bytes_over_all_included_Size_it_self;
 *     uint8_t    font_Width_in_Pixel_for_fixed_drawing;
 *     uint8_t    font_Height_in_Pixel_for_all_characters;
 *     unit8_t    font_First_Char;
 *     uint8_t    font_Char_Count;
 *
 *     uint8_t    font_Char_Widths[font_Last_Char - font_First_Char +1];
 *                  // for each character the separate width in pixels,
 *                  // characters < 128 have an implicit virtual right empty row
 *
 *     uint8_t    font_data[];
 *                  // bit field of all characters
 */

#include <inttypes.h>
#include <avr/pgmspace.h>

#ifndef NUMERAL44X24_H
#define NUMERAL44X24_H

#define NUMERAL44X24_WIDTH 28
#define NUMERAL44X24_HEIGHT 44

static const uint8_t NUMERAL44X24[] PROGMEM = {
    0x27, 0x40, // size
    0x1C, // width
    0x2C, // height
    0x30, // first char
    0x0A, // char count
    
    // char widths
    0x18, 0x0C, 0x18, 0x18, 0x18, 0x18, 0x18, 0x18, 0x18, 0x18, 
    
    
    // font data
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
    
};

#endif
