dhskinner/Scoreboard/(commit log)

2017-08-02 Updated 2017 sponsors
    [2017 Sponsors.xlsx]
2017-08-02 Added design files
    [112A-TAAR-R02_C_1.sldprt, 2x15Header.sldprt, 2x5Header.sldprt, 3xAA Battery Holder.SLDPRT, 4DLCD-35T-HVGA-BASE.sldprt, 4DLCD-35T-HVGA-FRAME.sldprt, 4DLCD-35T-HVGA-LCDGLASS.sldprt, 4DLCD-35T-HVGA-METAL.sldprt]
2017-08-03 Updated Eagle Files
    [Scoreboard Module 20150702.sch, Scoreboard Wifi Controller 20170514.brd, Scoreboard Wifi Controller 20170514.sch]
2018-05-05 Refreshed 2017 Sponsors
    [2017 Sponsors.xlsx]
2018-05-05 Synced 2017 Sponsors
    [2017 Sponsors.xlsx]
2018-05-05 Synced 2018 Sponsors
    [2018 Sponsors.xlsx]
2019-04-13 Updated with 2019 Sponsors
    [2019 Sponsors.xlsx]
2020-08-17 Updated 2020 Sponsors
    [2020 Sponsors.xlsx]
2020-08-17 Various solidworks updates
    [5mm LED GROMMIT.SLDPRT, 92844-005 USB CABLE B MALE TO B FEMALE PANEL MOUNT2.SLDPRT, Adafruit HUZZAH.SLDASM, Base PCB1.sldprt, Base PCB10.sldprt, Base PCB11.sldprt, Base PCB12.sldprt, Base PCB13.sldprt]
2020-08-22 Updated 2020 Logos
    [2020 Sponsors.xlsx]
2024-04-10 Sponsors 2023
    [SponsorList.xlsx]
2024-05-13 Sponsors 2024
    [SponsorList.xlsx]
