dhskinner/Scoreboard/(notices)

Notices in the files:
Design/Eagle/Scoreboard Module 20150702.brd:
COPYRIGHT 2015
parts and their libraries:
SparkFun-Connectors: Licensing: Creative Commons ShareAlike 4.0 International - https://creativecommons.org/licenses/by-sa/4.0
